nht-cyb/yumi-automatic-soldering-thd/README.md

# Automatic Soldering for Through-Hole Components with ABB YuMi

Automated soldering of through-hole (THD) components on PCBs with the **ABB YuMi (IRB 14000)** collaborative robot, a 3D-printed soldering-iron mount and a custom solder-wire feeder and cleaner.
The software pipeline goes from *"click the pins you want soldered"* to a ready-to-run **RAPID** program. Selected joints are mapped to robot coordinates using a calibrated point dataset, then ordered by **Ant Colony Optimization (ACO)** to minimise travel between joints.

> Bachelor thesis, VNU University of Engineering and Technology, MEMS and Microsystems Department (2024).
> Author: **Nguyen Huyen Trang**. Supervisors: Assoc. Prof. Bui Thanh Tung, MSc. Tran Nhu Chi.

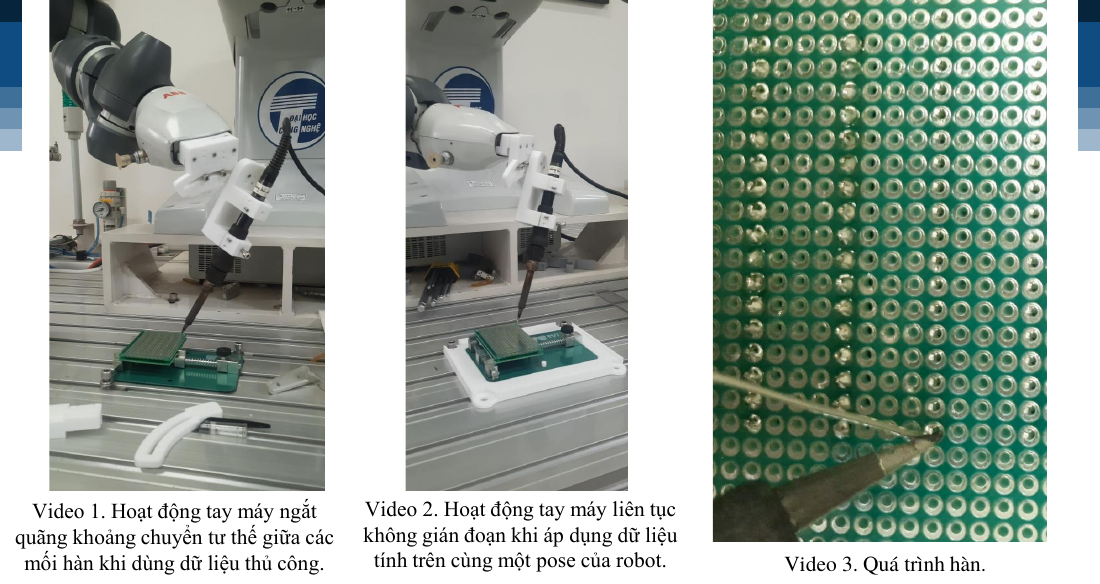
[picture p1: docs/images/robot_demo.png]
YuMi soldering a PCB


## Highlights

| | Result |
| --- | --- |
| Solder defects | **55 % empty joints → 6.7 % overall defect rate** (first trial vs. final parameters) |
| Wrong-position rate | **58.5 % → 10.2 %** of points (manual teaching vs. selective approximation) |
| Hole-pitch error | **1.305 mm → 0.022 mm** (manual teaching vs. selective approximation) |
| Re-setup time for a new board | **Hours → ≈ 4 min** (dataset + calibration instead of re-teaching every point) |
| Path optimization (Berlin52 benchmark) | Unordered tour **16,751 → 7,542** with ACO, the known optimum |
| RAPID programming | **Fully generated**, with no manual editing of point names or calls |
| Robot movement test | https://drive.google.com/drive/folders/1v9BW3aC0AH3kP2q5UkwLiJdkOLWXDny6?usp=sharing |
| Soldering Procedures | https://drive.google.com/drive/folders/1s6_kat9STPvH8OwUOIggMFEBmVdbERJi?usp=sharing |
## Contents

0. [Overview](#0-overview)
1. [Hardware](#1-hardware)
2. [Software setup](#2-software-setup)
3. [Working procedure (how to run)](#3-working-procedure)
4. [Experiments and results](#4-experiments-and-results)
5. [Limitations and future work](#5-limitations-and-future-work)

---

## 0. Overview

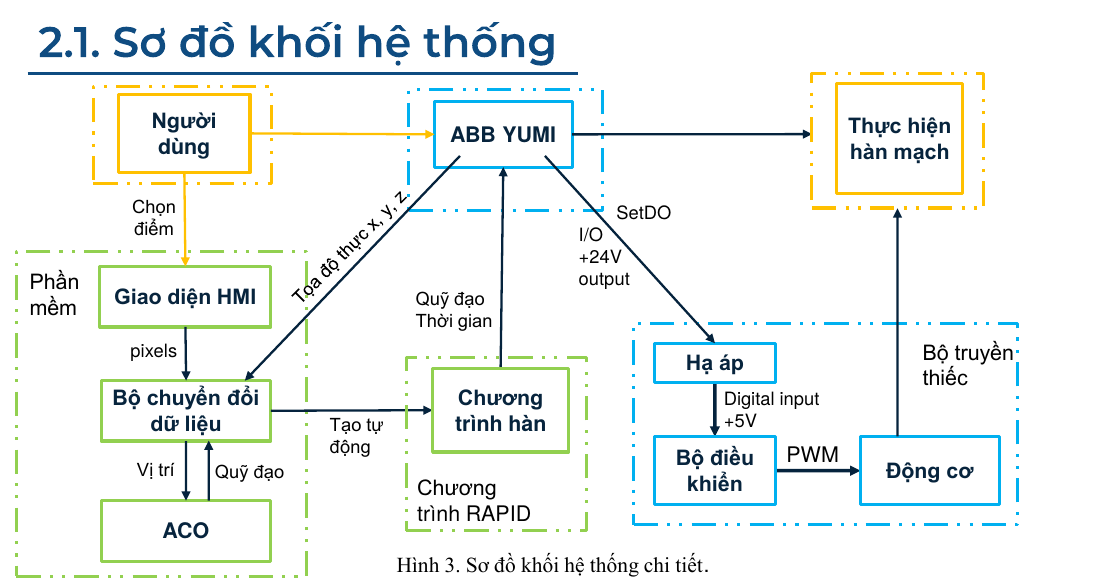
[picture p2: docs/images/system_diagram.png]
System block diagram


The system has three groups of blocks:

- **Software (green):** the web input page, the data processor, the ACO path optimizer and the RAPID program generator
- **Actuation (blue):** the YuMi right arm and the solder feeder
- **Operator (orange):** selects joints, jogs the robot with the FlexPendant and starts the program

**Data flow.** Joints selected on the web page come out as pixels. The processor converts them to `(row, col)` holes, and ACO orders them. The generator merges point data, the solder `PROC` and the `main()` calls into one RAPID module. During the run, YuMi raises a 24 V digital output at each joint. A logic step-down converts it to 5 V, and the feeder controller drives the motor to push solder wire.

### Repository structure

```
.
├── web_pcb_selector/            # HTML/JS page for picking joints, plus the scripts that turn clicks into RAPID
│   ├── index.html               # board-size menu
│   ├── 5x7.html, 6x8.html       # interactive perfboard pages
│   ├── script.js, styles.css
│   ├── img/                     # perfboard images (3×7 … 8×12 cm)
│   ├── pixel_point_conv.py      # clicked pixel coords → (row, col)
│   ├── generate_cmd.py          # (row, col) list → one PROC call per joint
│   ├── generate_rapid.py        # point data + calls → RAPID module
│   ├── clickdata/               # saved clicks from the page
│   ├── converted_output/        # clicks converted to (row, col)
│   ├── command/                 # generated call list
│   ├── program/inputgp/         # robtarget grid and calibration module used as generator input
│   └── Web/                     # screen recordings of the selector
├── data_processing/
│   ├── data_extraction/         # Python scripts for the point dataset
│   │   ├── extract_to_txt.py            # robtargets → x, y, z text
│   │   ├── extract_data_to_excel.py     # robtargets → x, y, z spreadsheet
│   │   ├── save_multiple_data.py        # all input files → one workbook, one sheet each
│   │   ├── generate_points.py           # taught outer-edge points → full 18×24 hole grid
│   │   ├── visualize.py                 # plot the extracted points
│   │   ├── input/                       # taught robtarget files
│   │   ├── output/                      # extracted spreadsheets
│   │   ├── generated point/             # generated inner grid points
│   │   └── visualize data/              # extracted coordinates and plots
│   ├── calibrate/0511/          # RAPID calibration modules (shift / set XYZ, work object)
│   ├── cal_points_v1/           # first C++ grid-point calculator
│   ├── Input real data/         # recordings of the taught-point plots
│   └── *.mp4, *.xlsx            # calibration videos and extracted coordinates
├── aco/
│   ├── ACO_Matlab/              # ACO / TSP solver (MATLAB): ant_colony.m, myaco.m, helpers
│   │   ├── data/, *.csv, *.xlsx, berlin52.*   # test point sets
│   │   └── results/             # result figures (.fig, .png)
│   └── Traveling Salesman/
│       ├── Code Matlab/         # Berlin52 version of the MATLAB solver
│       └── Code Python/         # Python version (main.py, aco.py, ant_colony.py, graphs.py, util.py)
├── ACO-results/                 # recordings and plots of ACO runs
├── rapid/
│   ├── MainModule.mod           # main right-arm module
│   ├── one_row_*.mod, move_p_row.mod   # single-row test programs
│   ├── SimpleMove.mod, SimpleMove.sys  # first motion test
│   ├── calibrateXYZ_for_shifted_station.txt   # calibration module for a shifted board
│   └── *.txt, *.xlsx            # taught robtarget data and backups
├── firmware/
│   ├── cad/                     # SolidWorks parts, STL and STEP files
│   │   ├── GripperVer1/, GripperVer2/   # soldering-iron mount, first and second build
│   │   ├── Board Setup/                 # PCB fixture
│   │   ├── Print2/                      # parts exported for 3D printing
│   │   ├── SLW_Hakko/                   # soldering-iron model
│   │   └── chot/                        # pin and transmission-head base
│   ├── cleaner_bldc/            # ESP32 + Nidec 24H BLDC tip cleaner
│   │   └── BLDC_Cleaner/        # sketch
│   ├── feeder_v1_esp32/         # ESP32 + Nidec 24H BLDC
│   │   ├── nidec/               # sketch
│   │   ├── SolderFeeder1/       # CAD
│   │   ├── schematic2/          # Fritzing schematic
│   │   └── SolderFeederSchematicV2/
│   └── feeder_v2_mega/          # Arduino Mega 2560 + TB6600 + NEMA14 (final)
│       ├── Solder_Feeder.ino    # sketch
│       ├── schematic3/          # Fritzing schematic and exports
│       ├── DM860A Stepper Motor Driver/   # Fritzing part
│       └── img/                 # gear-train renders
├── results_img/                 # photos of soldered boards per test case, result charts
├── reports/                     # thesis, slides and short report
├── yumi_readme/                 # RobotStudio getting-started notes
├── scripts/make_gifs.sh         # builds the README GIFs
└── docs/                        # images and GIFs used in this README
```

---

## 1. Hardware

### 1.1 Work-cell setup

A fixture plate holds the PCB in a repeatable position in front of the YuMi right arm. Test boards are double-sided perfboards (2.54 mm pitch) with jumper pins in consecutive rows. Pins should protrude **2 mm or less** and be held in place by bending the leads or taping them.

### 1.2 Soldering-iron mount

The mount bolts to the camera face of the YuMi wrist. A curved slotted bracket lets you set the iron angle. The final setup uses the **iron at 60° from vertical**, with the solder nozzle horizontal on the opposite side of the pin. All parts are 3D-printed. Leave clearance for M2 screw holes, because 0.4 mm nozzles shrink holes by about 0.2–0.5 mm.

| CAD | First and second builds |
| --- | --- |
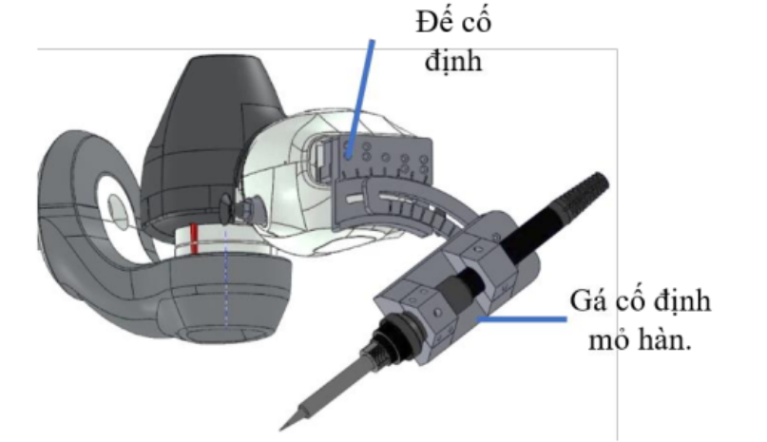
[picture p3: docs/images/mount_cad.png]
CAD model of the soldering-iron mount
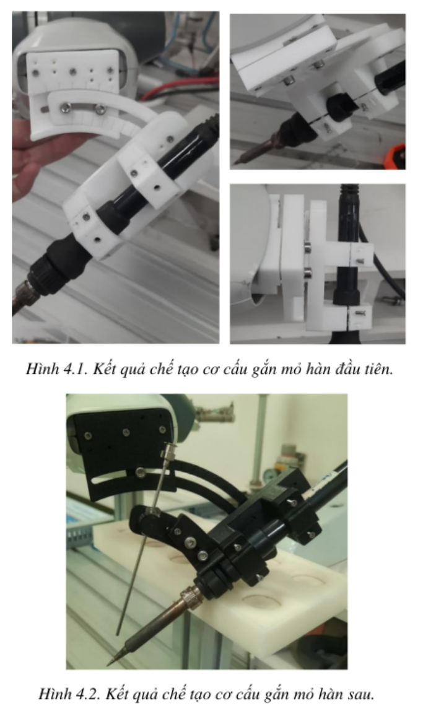
[picture p4: docs/images/mount_photos.png]
Photos of the first and second mount builds
|  |  |

### 1.3 Solder feeder v1 (ESP32 + BLDC)

The wire is pinched between a motor-driven gear and a ball bearing, guided by four brass posts. It only fits **0.8 mm** wire.

| Model | Build | Controller |
| --- | --- | --- |
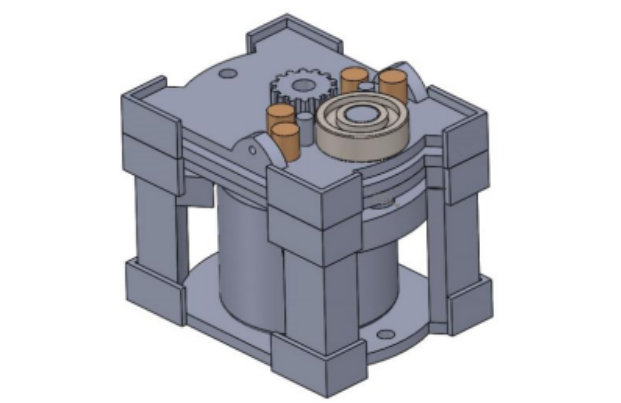
[picture p5: docs/images/feeder_v1_cad.png]
CAD model of feeder v1
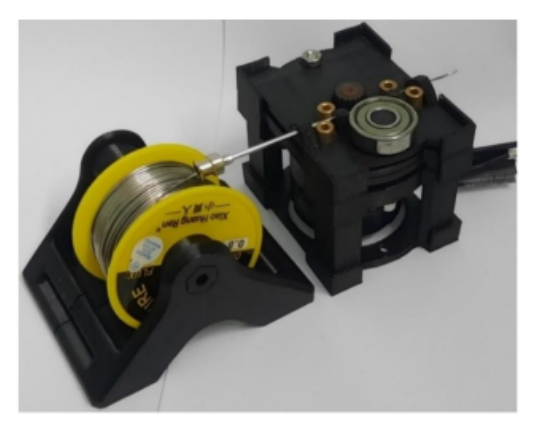
[picture p6: docs/images/feeder_v1_photo.png]
Built feeder v1
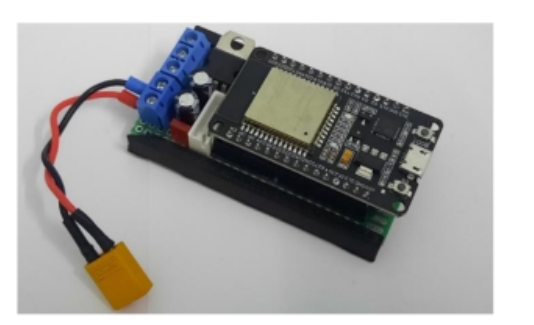
[picture p7: docs/images/feeder_v1_board.png]
ESP32 controller board for feeder v1
|  |  |  |

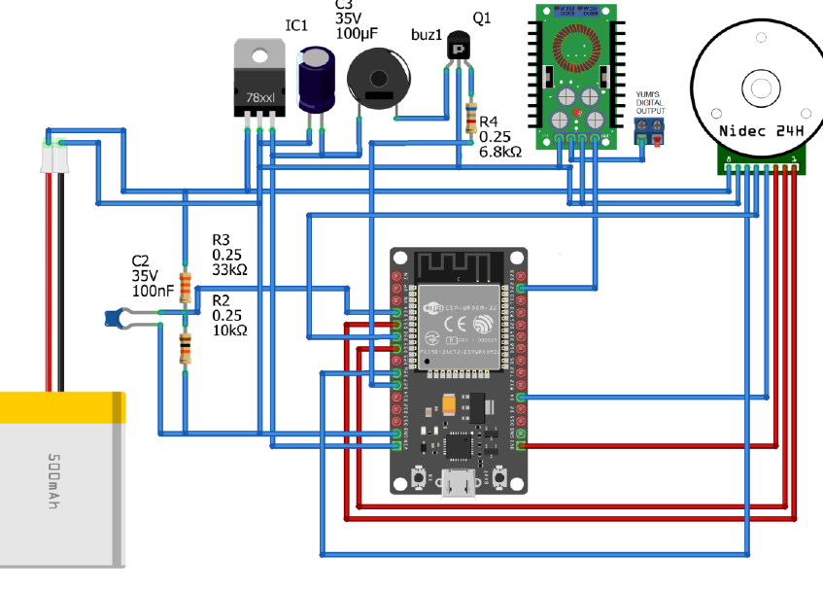
[picture p8: docs/images/feeder_v1_schematic.png]
v1 schematic


- **Controller:** ESP32 driving a **Nidec 24H055M020** BLDC motor with built-in driver and encoder (PWM speed control)
- **Power:** 12 V for the motor; a 7805 regulator supplies 5 V to the ESP32
- **Input:** YuMi digital output (0/24 V) through a voltage divider and step-down converter
- **Problems found:** wire slipping and sudden jerks at start-up. These caused most of the "insufficient solder" defects in early tests.
- **Code:** `firmware/feeder_v1_esp32/`

### 1.4 Solder feeder v2 (Arduino Mega + stepper), final version

This version is based on a 3D-printer filament extruder. A **9:5:1 spur-gear train** drives a grooved pulley, and a spring-loaded screw sets the clamping force. It handles wire from **0.3 to 1.2 mm**. The groove keeps bent wire from slipping and reduces solder spatter.

| Gear train | Build |
| --- | --- |
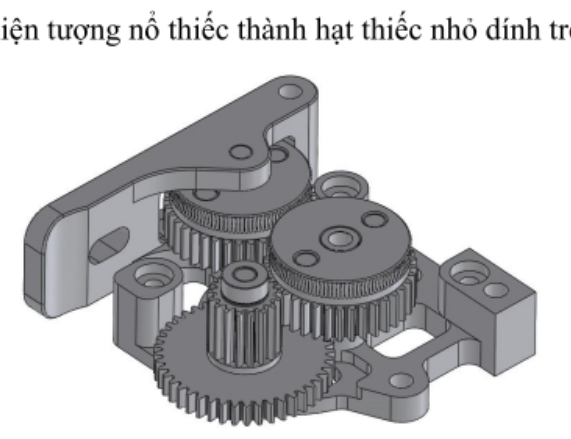
[picture p9: docs/images/feeder_v2_gears.png]
Feeder v2 spur-gear train
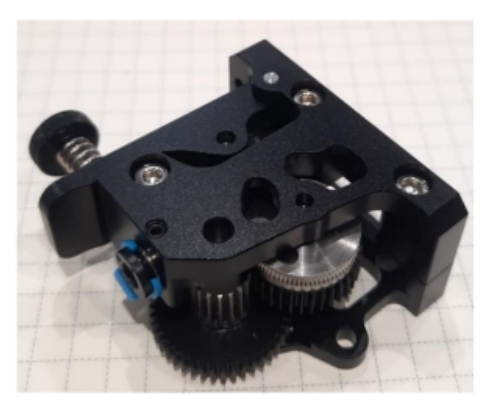
[picture p10: docs/images/feeder_v2_photo.png]
Built feeder v2
|  |  |

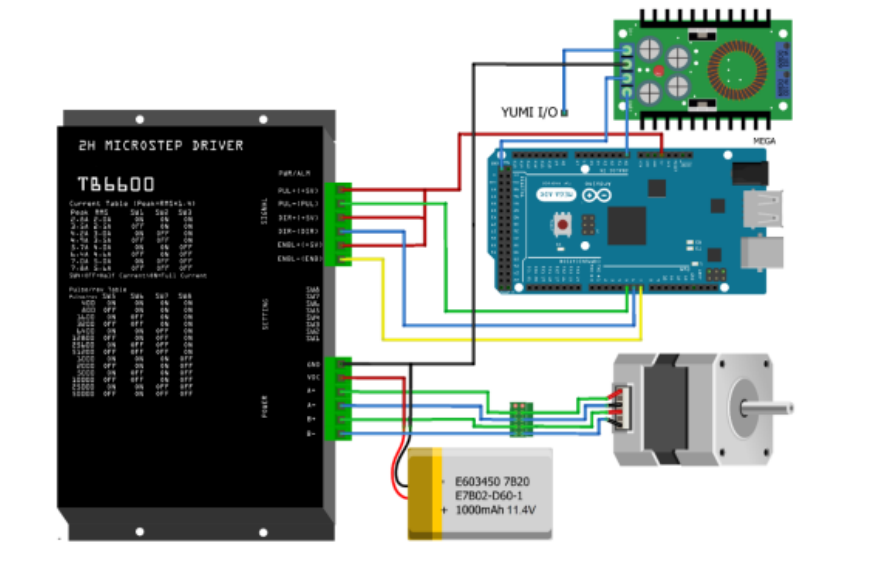
[picture p11: docs/images/feeder_v2_schematic.png]
v2 schematic


- **Controller:** Arduino Mega 2560 with a **TB6600** micro-step driver and a **NEMA14 36STH20-1004AHG** stepper, which gives slow and precise feed rates
- **Power:** 12 V to the driver and 5 V to the Mega
- **Input:** YuMi I/O through a 24 V → 5 V step-down
- **Code:** `firmware/feeder_v2_mega/`

---

## 2. Software setup

**Requirements**
- ABB RobotStudio (RobotWare with RAPID) connected to the YuMi controller
- Python 3.8+ with `numpy`, `matplotlib`, `pandas`, `xlsxwriter` and `plotly`
- MATLAB R2020+ (recommended for ACO, which ran much faster than the Python version)
- Arduino IDE (ESP32 core for v1)

```bash
git clone https://github.com/nht-cyb/yumi-automatic-soldering-thd.git
cd yumi-automatic-soldering-thd
pip install numpy matplotlib pandas xlsxwriter plotly
```

The scripts are research code: each one reads its input and output paths from variables in the file, relative to its own folder. Run them from that folder and edit the variables to point at your files.

### 2.1 Start pose

Jog the right arm with the FlexPendant joystick to a home pose. The wrist camera must face straight down at the board, perpendicular to the table. Adjust joints 4–6 to get there. With this pose fixed, pure linear jogging moves the iron tip along board rows and columns without changing the tool angle.

| J1 | J2 | J3 | J4 | J5 | J6 | J7 |
| --- | --- | --- | --- | --- | --- | --- |
| 54.64° | -98.48° | 25.01° | 20.64° | 41.72° | 94.18° | -96.10° |

### 2.2 Build the base point dataset (once per fixture)

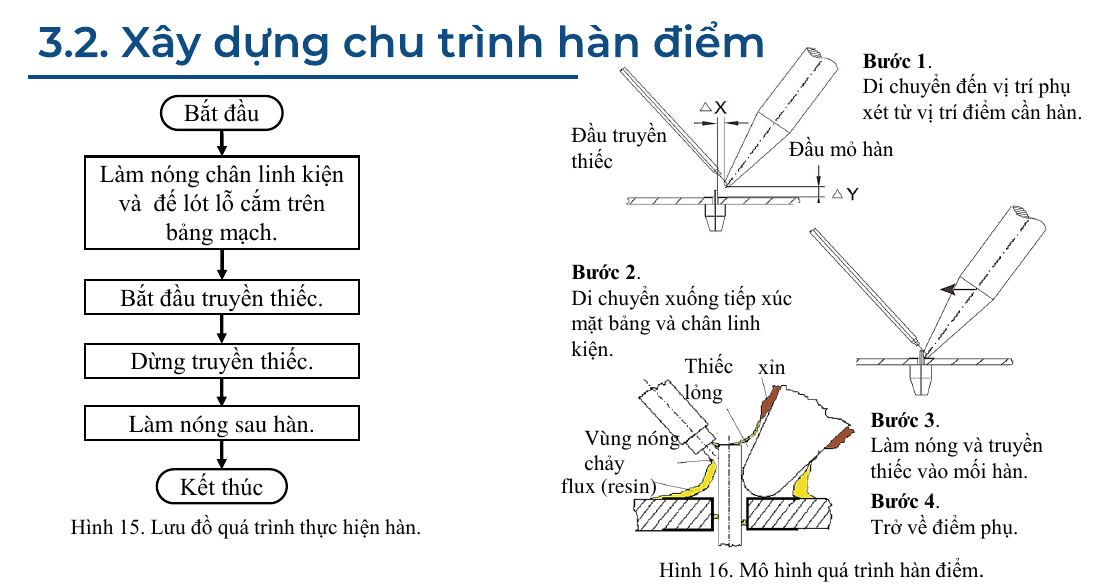
[picture p12: docs/images/dataset_flow.png]
Dataset generation flow


1. From the home pose, jog to the board corners and several reference holes along each row. Save each one as a `robtarget`. Move in straight lines only and touch the surface lightly.
2. Run the RAPID module that writes the saved points to a file.
3. Generate the full grid:

```bash
cd data_processing/data_extraction
python extract_to_txt.py     # input/2310_outer_grid.txt → visualize data/2310_outer_grid.txt
python generate_points.py    # → generated point/432_grid_points.txt
python visualize.py          # optional 3D plot of the points
```

Put the file of saved robtargets in `input/` and set `filename` at the top of `extract_to_txt.py`. That script extracts x, y, z from each `robtarget`. `generate_points.py` then interpolates between the taught edge points to fill in the full 18 × 24 grid (432 holes) and writes one `X, Y, Z` line per hole. `extract_data_to_excel.py` and `save_multiple_data.py` export the same coordinates to spreadsheets in `output/`.

The method described in the thesis (see `reports/`) also estimates the real hole pitch, which is not exactly 2.54 mm because of measurement angle, tilt and jog resolution, and replaces outliers with the averaged estimate.

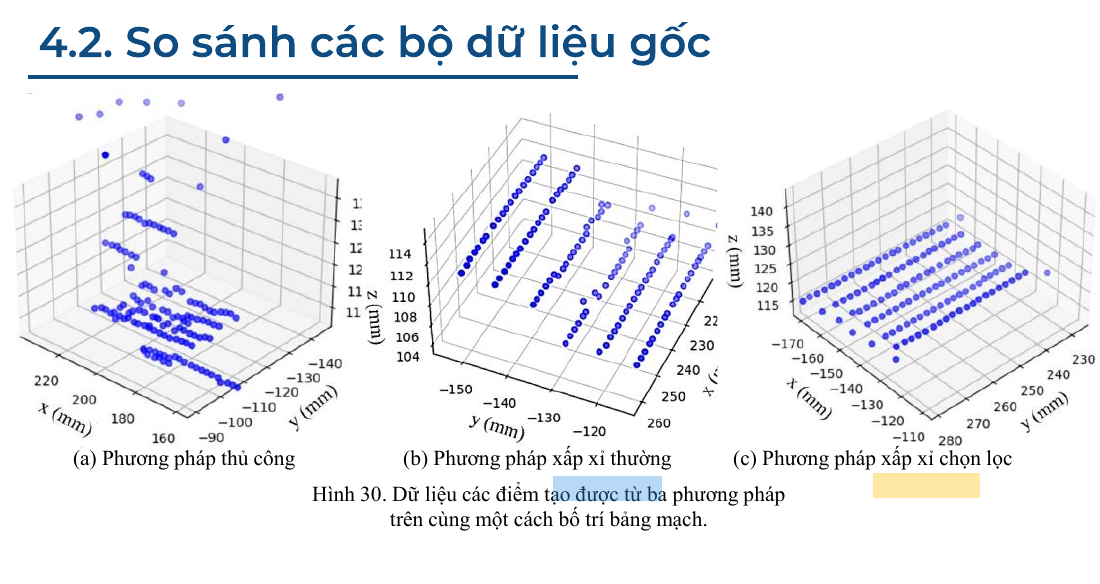
[picture p13: docs/images/dataset_methods.png]
Dataset methods compared


| Method | Δx | Δy | Δz | ε(x) | Wrong-position rate y / z / mean |
| --- | --- | --- | --- | --- | --- |
| Manual teaching | 1.2346 | 0.2713 | -0.0212 | 1.3054 | 0.409 / 0.761 / **0.585** |
| Plain approximation | 1.9523 | -0.0689 | -0.1047 | 0.5878 | 0.227 / 0.280 / **0.254** |
| Selective approximation | 2.5180 | -0.0046 | 0.0065 | **0.0215** | 0.129 / 0.076 / **0.102** |

Δ is the mean distance between consecutive points in a row (mm), and ε(x) is the mean pitch error. With the generated dataset, the arm moves smoothly between joints, without pose changes, pauses or pin collisions.

| Hand-taught points (left) vs. generated dataset (right), 1.5× speed |
| --- |
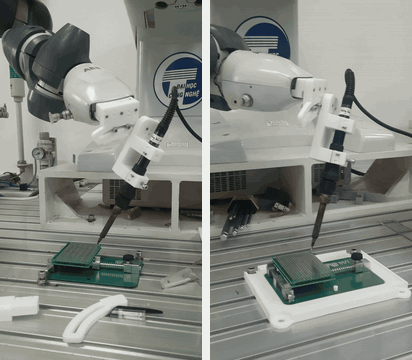
[picture p14: docs/gifs/motion_comparison.gif]
Left: the arm pauses to change pose between hand-taught points. Right: the arm moves continuously using the generated dataset
|  |

### 2.3 Calibration (each time the board is replaced)

The task needs about **0.2 mm** accuracy, and a replaced board never sits exactly where the last one did.

- **XY shift:** touch the new board origin. `shiftXY` is the mean offset from the stored origin, and it is added to every point.
- **Z height:** similar to bed levelling on a 3D printer. Touch the tip to the surface at several points until it just makes contact without pressing. Store the mean as the constant `calibratedZ`. YuMi only reports a collision after the board tilts about 2 mm, so the height must be set carefully when the iron is hot.

```
newPointXY = oldPointXY + shiftXY + offset    ! offset = hole spacing
newPointZ  = calibratedZ + PinLength
```

Re-setup takes **about 4 minutes**. Re-teaching every point by hand used to take hours.

---

## 3. Working procedure

### 3.1 Select the joints to solder

Open `web_pcb_selector/index.html` and choose a board size. The menu lists 3×7, 4×6, 5×7, 6×8, 7×9 and 8×12 cm, but only the 5×7 and 6×8 pages are included in this repository. Click a hole to select it, or drag to select a whole row. You can undo, clear all or save. **Save Positions** downloads `clicked_positions.txt`; move it into `web_pcb_selector/clickdata/`.

| Board size menu | Selecting joints |
| --- | --- |
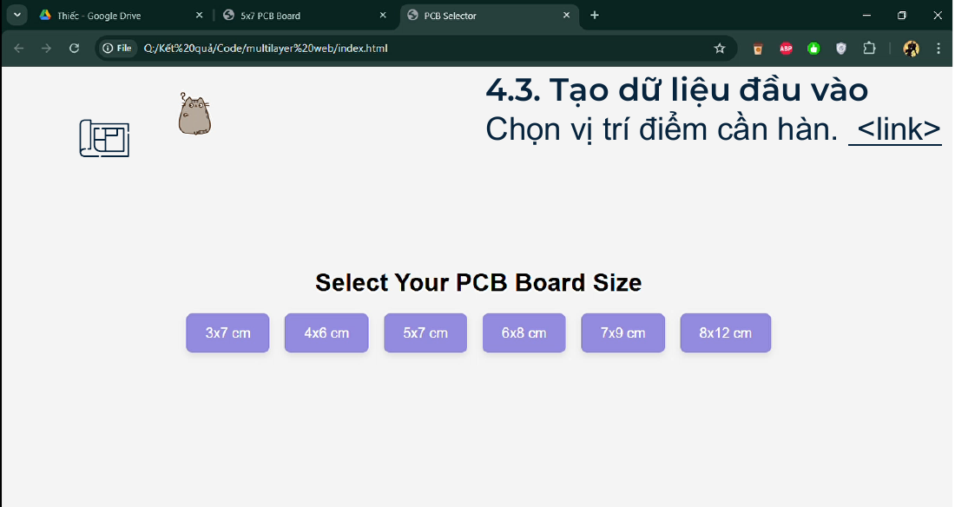
[picture p15: docs/images/pcb_selector.png]
Board size menu of the web selector
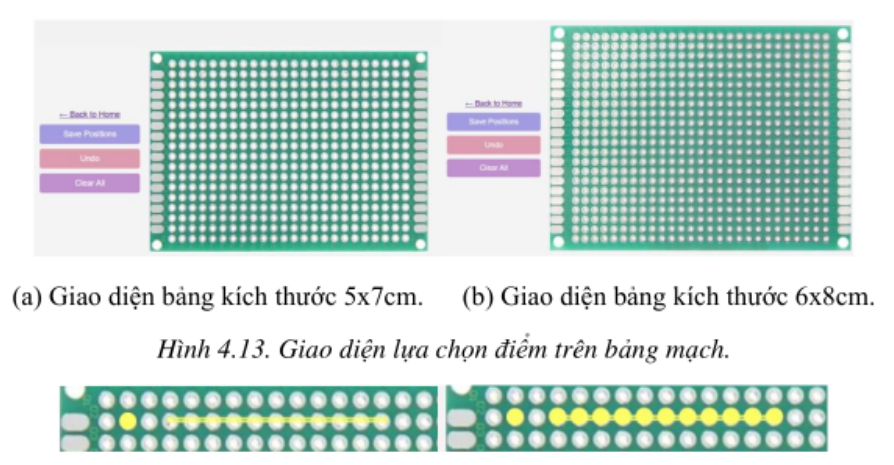
[picture p16: docs/images/pcb_boards.png]
Joints selected on a board
|  |  |

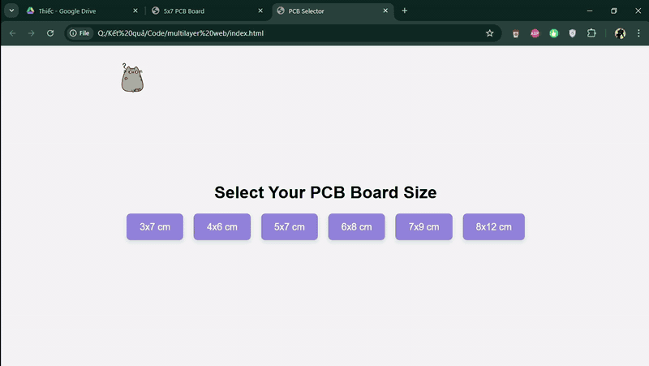
[picture p17: docs/gifs/web_selector.gif]
Choosing a 5×7 cm board and selecting rows of joints in the web selector (1.5× speed)


```bash
cd web_pcb_selector
python pixel_point_conv.py   # clickdata/clicked_positions.txt → converted_output/clicked_positions_converted.txt
```

The script snaps each pixel to the nearest hole, drops duplicates and sorts by row and column. The pixel position of hole (1, 1) and the hole spacing are set in `reference_x`, `reference_y` and `grid_spacing` near the end of the script; change them for a different board page. If the output file already exists, the script writes `clicked_positions_output_<n>.txt` instead of overwriting it.

| Input (pixels x, y) | Output (row, col) |
| --- | --- |
| 65 45 | 2 2 |
| 105 44 | 2 4 |
| 125 44 | 2 5 |
| 146 44 | 2 6 |
| … | … |
| 309 44 | 2 14 |

### 3.2 Optimize the path (ACO / TSP)

```matlab
% MATLAB (used for the reported results), from aco/ACO_Matlab/
ant_colony   % Berlin52 benchmark, reads berlin52.csv
myaco        % board points
```

```bash
# Python
cd "aco/Traveling Salesman/Code Python"
python main.py
```

All three have the author's own paths hard-coded, so edit them first:

- `ant_colony.m`: remove or change the `cd('Q:\Thesis\Code\ACO_Matlab')` line so that `berlin52.csv` is found.
- `myaco.m`: change the `cd(...)` line, supply an `input.csv` of joint coordinates and assign its columns to `x` and `y`. Set `n` to the number of joints.
- `main.py`: point `pd.read_csv(...)` at a tab-separated coordinate file with a header row. The tour is plotted with `plotly`.

Each ant builds a tour. Pheromones are updated after each iteration, and the shortest tour found is kept. The parameters were tuned on the **TSP Berlin52** benchmark, whose known optimal tour length is 7,542.

| Setting (MATLAB) | Iterations | Ants | α | β | δ | σ | Result |
| --- | --- | --- | --- | --- | --- | --- | --- |
| Initial | 300 | 60 | 1 | 4 | 0.15 | 0.97 | 8,210.2: stuck in a local optimum |
| **Tuned** | 300 | 60 | **15** | **20** | **0.13** | **0.86** | **7,549.0**, converges at about iteration 60 |

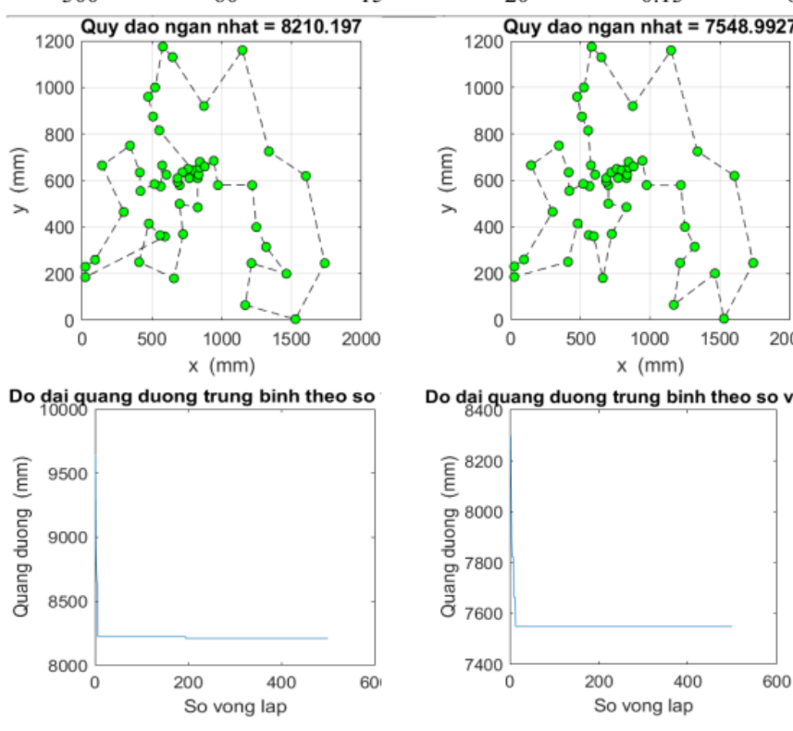
[picture p18: docs/images/aco_berlin52.png]
Berlin52 comparison


The Python version with local search (60 ants, 100 iterations, α = 15, β = 20, decay 0.1) reaches the optimum of 7,542:

| Unordered (16,751) | ACO (7,542) |
| --- | --- |
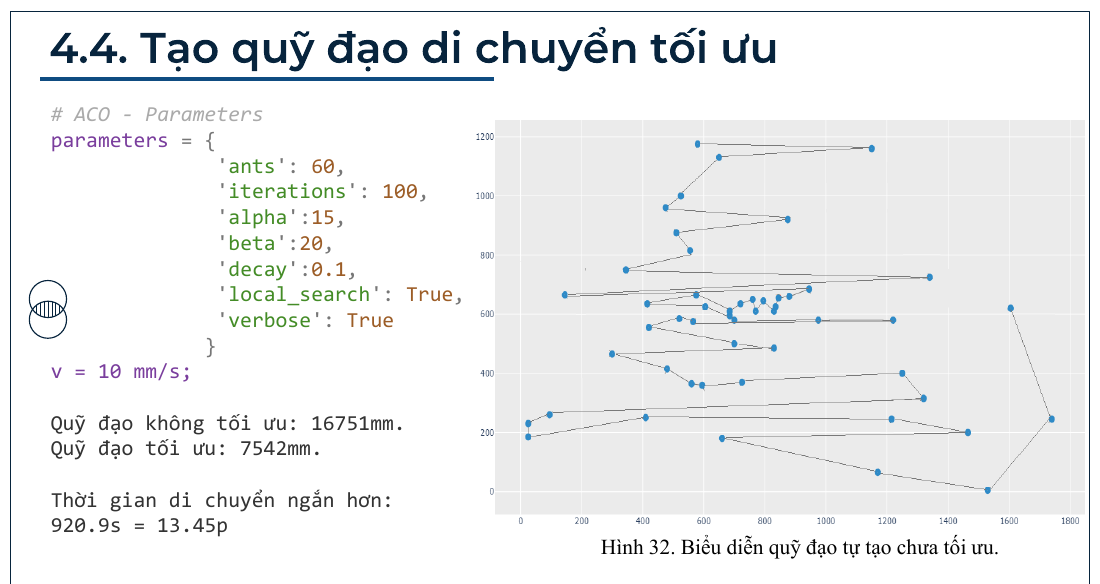
[picture p19: docs/images/path_before.png]
Unordered Berlin52 tour
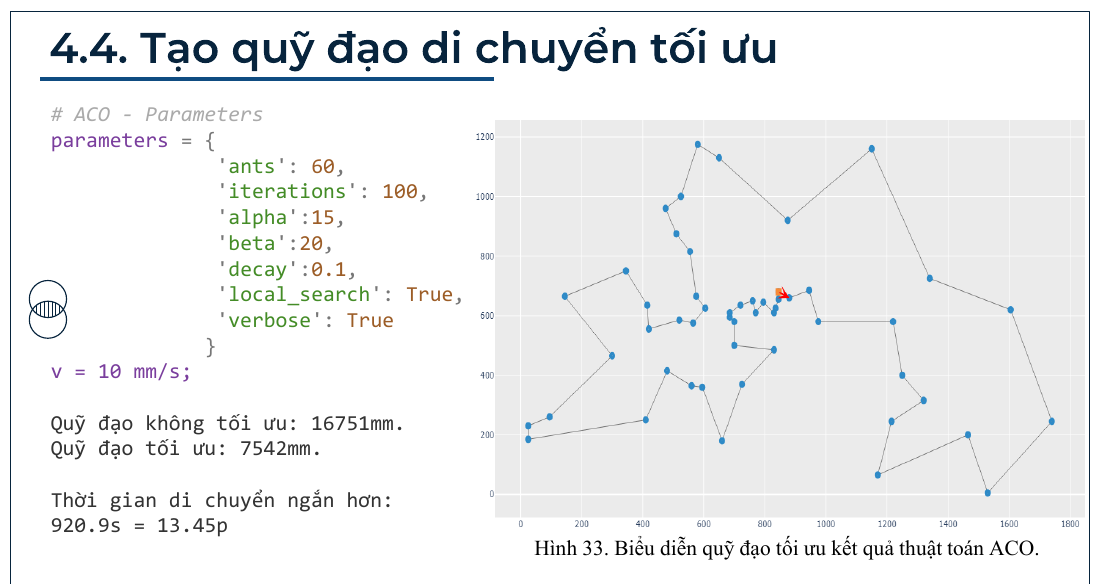
[picture p20: docs/images/path_aco.png]
ACO-optimized Berlin52 tour
|  |  |

**Working parameters for the board:** 20 iterations, 10 ants, α = 15, β = 20, δ = 0.13, σ = 0.86. On 10 random holes the shortest path was **74.14 mm**, found at iteration 4. When joints sit in evenly spaced rows, the order saved from the web page is already optimal, so ACO is only needed for scattered layouts.

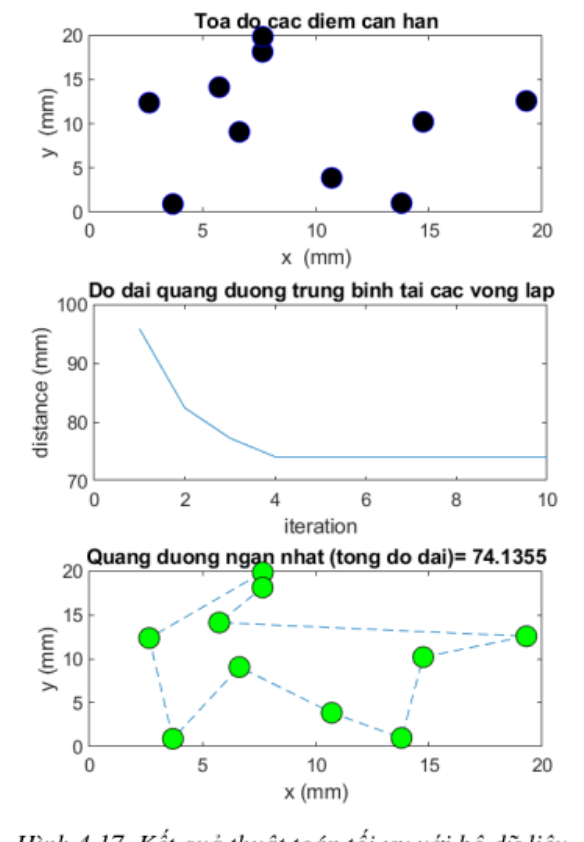
[picture p21: docs/images/aco_final.png]
ACO final


### 3.3 Generate the RAPID program

```bash
cd web_pcb_selector
python generate_cmd.py       # → command/commands.txt, one call per joint
python generate_rapid.py     # → program/clicked_positions_converted_module.txt
```

Both scripts read `converted_output/clicked_positions_converted.txt`; change `input_file` at the bottom of each to use another file. If the input is missing, `generate_rapid.py` exits without writing anything or printing an error.

`generate_rapid.py` starts from the template module (`program/inputgp/calibrateXYZ_for_shifted_station.txt`), which holds the calibration and per-joint routines. It adds any point declarations from `program/inputgp/2310_outer_grid.txt` that the template does not already have, and replaces the `MoveUpDown` calls in `main()` with one call per selected joint. The calls follow the line order of the converted file, so to use an ACO tour, reorder those lines first.

Each call is written as `MoveUpDown <point>;`. Rows map to letters and columns to numbers, so (1, 2) becomes `A2` and (18, 24) becomes `R24`. The included dataset only declares the holes on the board edge. For any other selected hole the script prints a warning; add its `robtarget` to the dataset file before loading the module.

### 3.4 Run on YuMi

1. In RobotStudio, paste or load the generated module into the **right-arm module** (`T_ROB_R`).
2. Flash the feeder firmware and connect the YuMi digital output through the 24 → 5 V step-down.
3. Set the iron to **350 °C**, then move to the home pose and run calibration (2.3).
4. Run `main()`. Keep the soldering speed at **`v20` or lower** to limit tip vibration.
5. Clean the tip every **15–20 joints**.

### 3.5 The soldering cycle at one joint

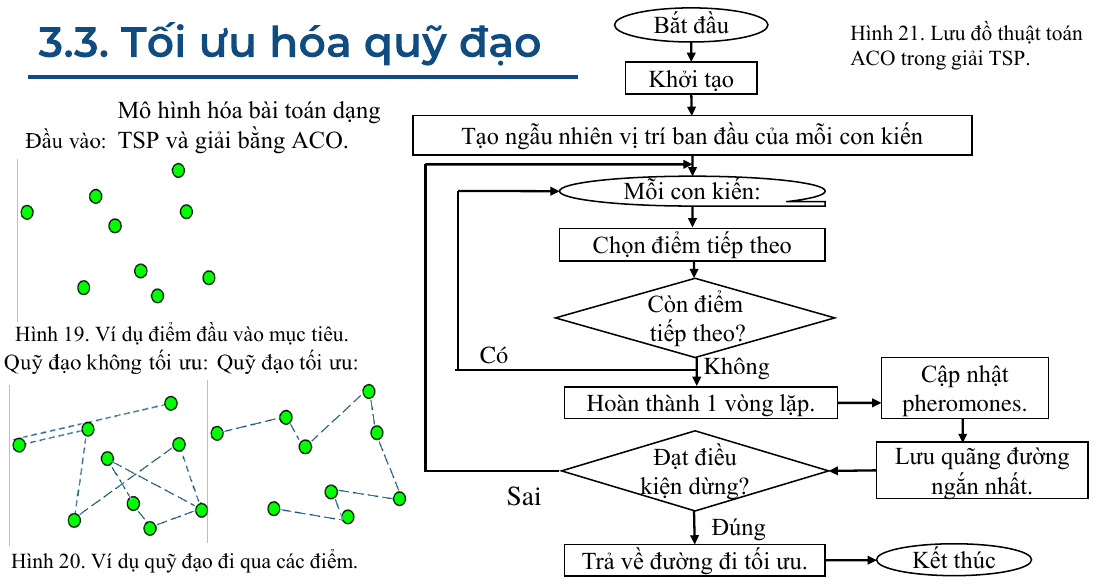
[picture p22: docs/images/solder_cycle.png]
Solder cycle timing


| Close-up along a row (3× speed) | Top-down view (2× speed) |
| --- | --- |
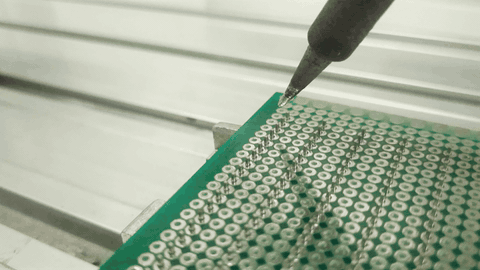
[picture p23: docs/gifs/soldering_closeup.gif]
Close-up of the iron soldering joints along a row
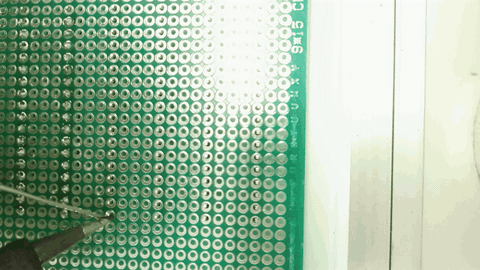
[picture p24: docs/gifs/soldering_topdown.gif]
Top-down view of YuMi soldering a row of joints
|  |  |

Simplified pseudo-code (not runnable RAPID; zones, tool data and semicolons are omitted, and `.xy` stands for setting `x` and `y`). The per-joint motion routine used by the generator is `MoveUpDown` in `web_pcb_selector/program/inputgp/calibrateXYZ_for_shifted_station.txt`.

```
PROC solder(robtarget currentPoint)
    temp.trans.xy         := currentPoint.trans.xy + shiftXY
    temp.trans.z          := calibratedZ + PinLength + clearance
    currentPoint.trans.xy := currentPoint.trans.xy + shiftXY
    currentPoint.trans.z  := calibratedZ + PinLength
    MoveL temp, v50                   ! approach point above the joint
    PulseDO \PLength:=0.3, feed       ! pre-feed: wet the tip
    MoveL currentPoint, v20           ! touch pad + pin
    WaitTime pre_heat                 ! pre-heat pad and pin
    PulseDO \PLength:=0.4, feed       ! feed solder
    WaitTime post_heat                ! let the solder flow
    MoveL temp, v20                   ! retract
ENDPROC
```

| Step | Time |
| --- | --- |
| Wait above joint, wet the tip (DO ON) | 0.1 – 0.4 s |
| Move down to the joint | 0.4 – 0.6 s |
| Pre-heat pad and pin | 1.2 s |
| Feed solder (DO ON) | 0.4 s |
| Post-heat, solder flows (DO OFF) | 0.8 s |
| Retract | 0.2 s |
| **Total per joint** | **≈ 3.2 s** |

---

## 4. Experiments and results

### 4.1 Test case 1: no dataset, no calibration

Setup: iron at 30°, feeder v1, points taught by hand, and solder fed the moment the tip touched the board.

| Trial | Temp. | Wait above | Feed | Wait after |
| --- | --- | --- | --- | --- |
| 1 | 285 °C | 0.5 s | 1.0 s | 0.2 s |
| 2 | 320 °C | 1.0 s | 1.5 s | 0.8 s |

**Result:** 22 of 40 joints (**55 %**) were empty. The board and tip were too cold for the solder to flow, and the tool pose drifted between points. Some joints also landed between pins because of position errors.

### 4.2 Test case 2: effect of temperature

Setup: dataset and calibration in use, pre-heat 1.5 s, feed 0.65 s, post-heat 1.0 s, 85 joints per temperature (5 rows × 17).

| Temp. | Excess | Insufficient | Skipped | Spike | Burnt | Defect rate |
| --- | --- | --- | --- | --- | --- | --- |
| 285 °C | 3 | 12 | 1 | 0 | 2 | 22.1 % |
| 300 °C | 2 | 8 | 1 | 0 | 0 | 10.7 % |
| 320 °C | 9 | 10 | 1 | 0 | 0 | 23.5 % |
| **350 °C** | 2 | 4 | 0 | 0 | 0 | **7.1 %** |
| 385 °C (run 1) | 1 | 8 | 1 | 3 | 3 | 18.6 % |
| 385 °C (run 2) | 4 | 16 | 3 | 1 | 4 | 31.4 % |

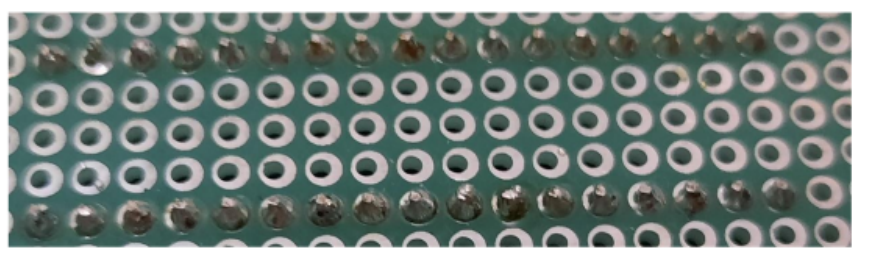
[picture p25: docs/images/joints_350C.png]
Joints at 350 °C


**Heat build-up.** The tip gets hotter during a long run. Joints soldered later in a row (shown at a 400 °C setting, left to right) become duller and burn more easily. Use **320–350 °C** and clean the tip every 15–20 joints.

Heat accumulation

### 4.3 Test case 3: feed time

Setup: 350 °C, pre-heat 1.5 s, feed speed 6 mm/s, post-heat 0.8 s, 72 joints. A short pre-feed was added to wet the tip, so solder reaches both sides of the pin.

| Pre-feed | Feed | Excess | Insufficient | Skipped | Spike | Short | Total defects |
| --- | --- | --- | --- | --- | --- | --- | --- |
| 0.7 s | 1.0 s | 27 | 0 | 0 | 0 | 1 | 29 |
| 0.5 s | 0.8 s | 13 | 7 | 1 | 0 | 0 | 21 |
| **0.3 s** | **0.4 s** | 0 | 18 | 0 | 1 | 0 | **19** |

A typical joint needs about 2 mm of wire, while a 0.7 s pre-feed pushes about 4.5 mm, which explains the excess solder.

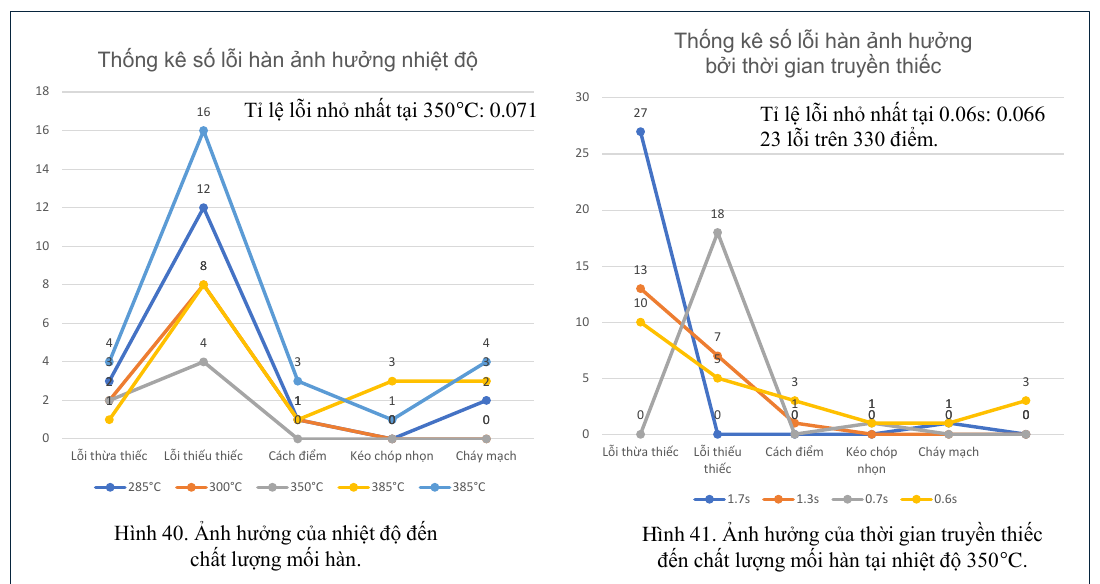
[picture p26: docs/images/defect_stats.png]
Defect statistics


### 4.4 Test case 4: final parameters

Final setup: feeder v2, 350 °C, pre-feed 0.5 s, pre-heat 1.5 s, feed 0.6 s at 4 mm/s, post-heat 0.8 s, and tip cleaning between rows. 330 joints were soldered (22 rows × 15) for each pin length.

| Pin length | Excess | Insufficient | Skipped | Spike | Short | Burnt | Total defects |
| --- | --- | --- | --- | --- | --- | --- | --- |
| 2 mm | 10 | 5 | 3 | 1 | 1 | 3 | 23 |
| 4 mm | 5 | 17 | 0 | 0 | 16 | 4 | 42 |

For short-pin components the overall defect rate is **6.69 %**. Excess solder dropped to **0.33 %**, down from about 30 % in earlier tests. Burnt joints were almost eliminated.

| Short-pin components | Long-pin (4 mm) components |
| --- | --- |
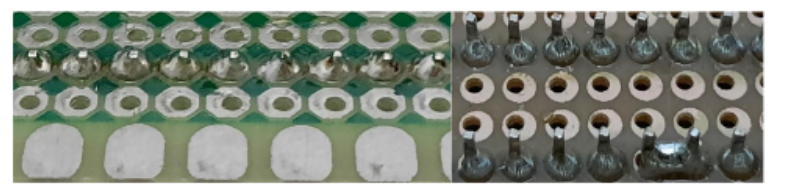
[picture p27: docs/images/final_joints.png]
Final solder joints on short-pin components
|  | Long pins limit the tip's contact angle with the pad and conduct heat toward neighbours, which causes bridging and one-sided joints. |

---

## 5. Limitations and future work

**Limitations**
- There is no temperature sensor. Heat is controlled only through the soldering station setting and timing.
- The quality scale does not yet fully follow industrial criteria such as IPC-A-610.
- Tests used perfboards only, not designed production PCBs.

**Future work**
- A friendlier user interface
- A dedicated CNC-style feeder built for high temperatures
- Active heating with closed-loop temperature sensing
- Camera-based joint localization, collision warnings and motion planning
- ML-based automated optical inspection (AOI) of joints from optical or X-ray images

---

## Citation

```
Nguyen Huyen Trang, "Research and development of through-hole component soldering
on printed circuit boards for the YuMi collaborative robot," B.Eng. thesis,
VNU University of Engineering and Technology, Hanoi, 2024.
```

## License

This project is licensed under the [MIT License](LICENSE).
