nht-cyb/yumi-automatic-soldering-thd/data_processing/data_extraction/visualize data/1110.png

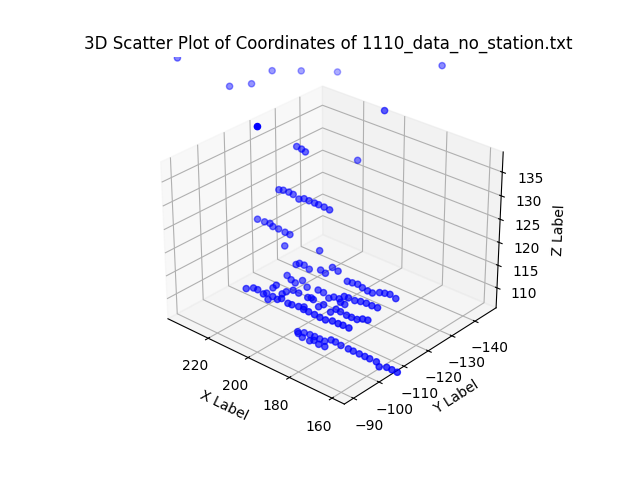
data_processing/data_extraction/visualize data/1110.png
