nht-cyb/yumi-automatic-soldering-thd/data_processing/data_extraction/visualize data/2210_BQ.png

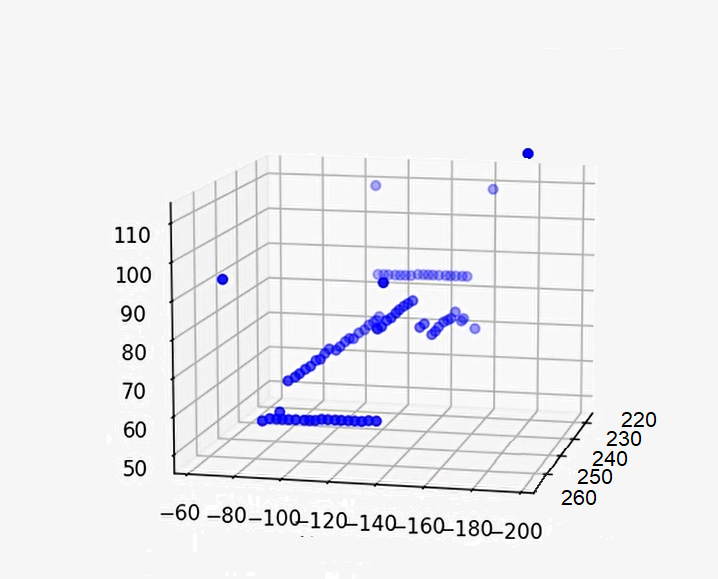
data_processing/data_extraction/visualize data/2210_BQ.png
