nht-cyb/yumi-automatic-soldering-thd/data_processing/data_extraction/visualize data/data.png

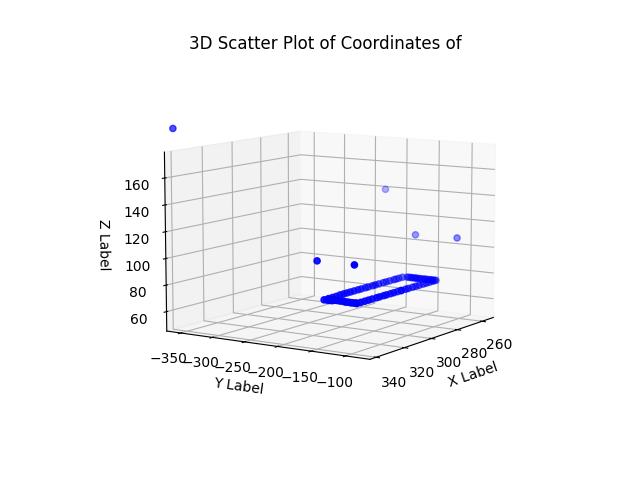
data_processing/data_extraction/visualize data/data.png
