nht-cyb/yumi-automatic-soldering-thd/data_processing/data_extraction/visualize data/Figure_1.png

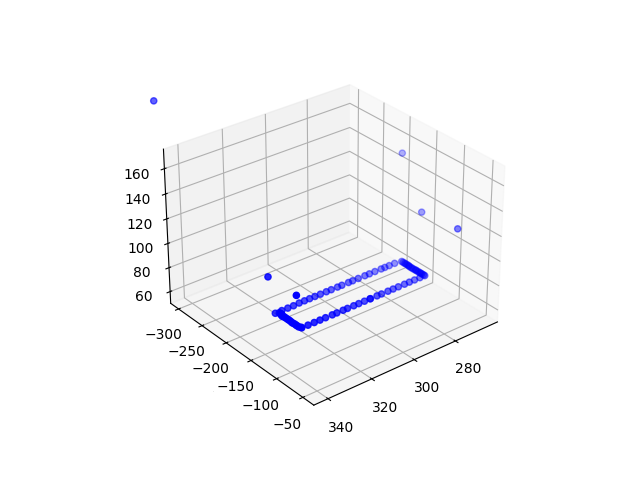
data_processing/data_extraction/visualize data/Figure_1.png
