nht-cyb/yumi-automatic-soldering-thd/data_processing/data_extraction/visualize data/Figure_1_.png

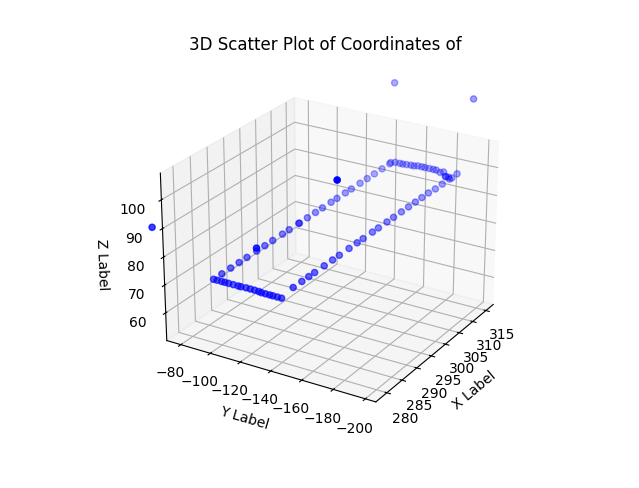
data_processing/data_extraction/visualize data/Figure_1_.png
