nht-cyb/yumi-automatic-soldering-thd/data_processing/data_extraction/visualize data/yellowpip.png

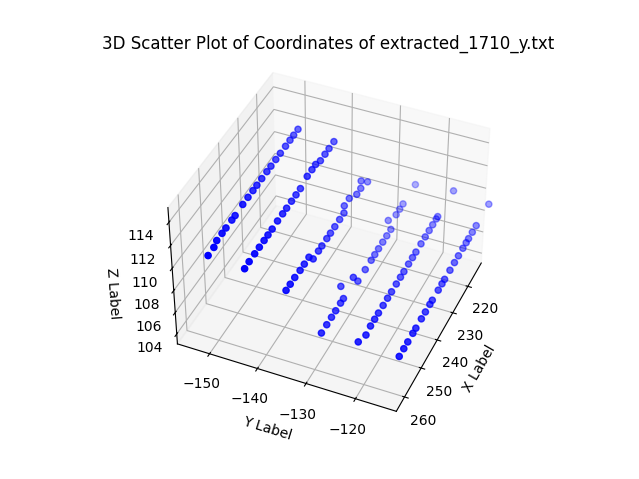
data_processing/data_extraction/visualize data/yellowpip.png
