nht-cyb/yumi-automatic-soldering-thd/firmware/cad/abb_irb14000_with_workspace-1.snapshot.2/ABB_IRB14000_with_WorkSpace.JPG

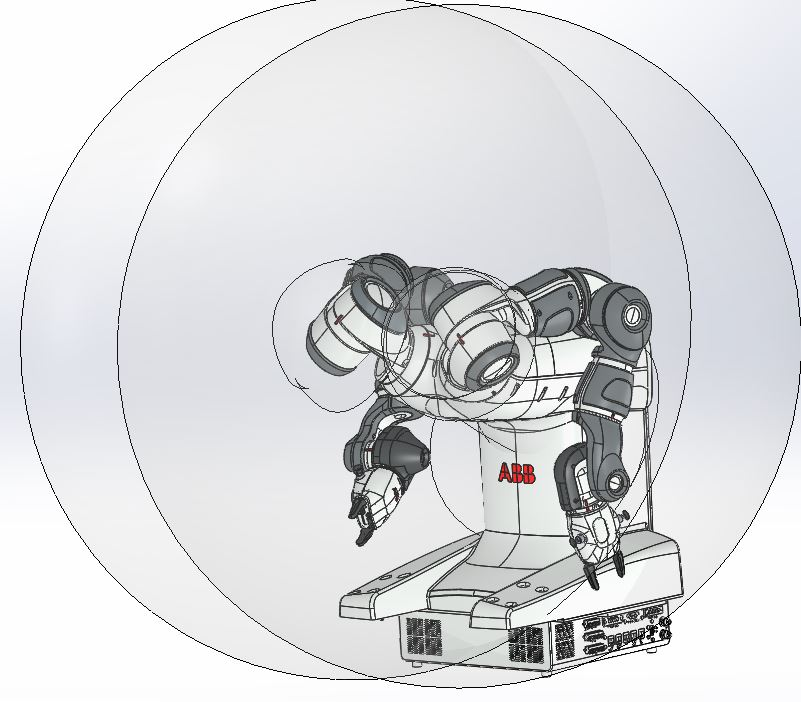
firmware/cad/abb_irb14000_with_workspace-1.snapshot.2/ABB_IRB14000_with_WorkSpace.JPG
