nht-cyb/yumi-automatic-soldering-thd/firmware/cad/Assem3.JPG

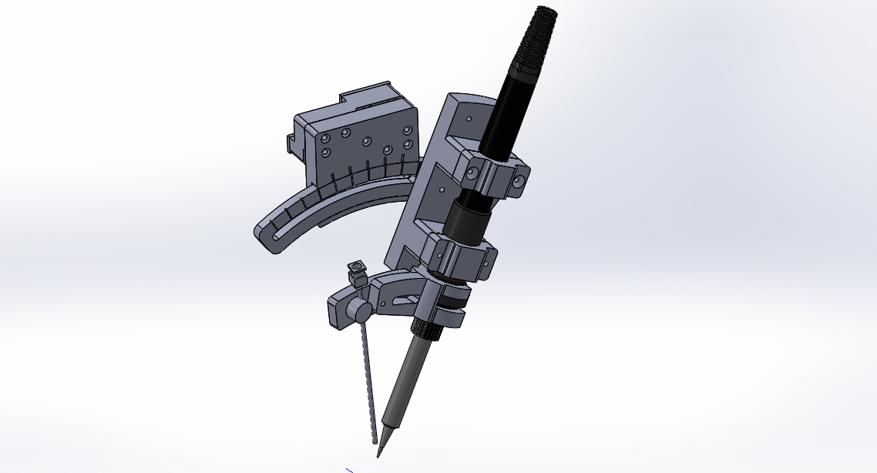
firmware/cad/Assem3.JPG
