nht-cyb/yumi-automatic-soldering-thd/firmware/cad/GripperVer2/Asse112.JPG

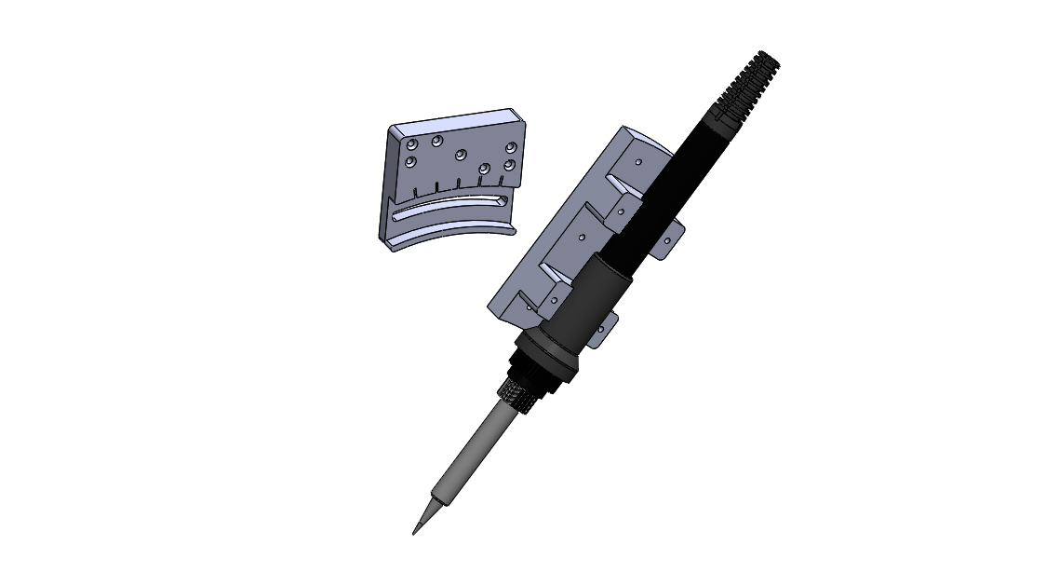
firmware/cad/GripperVer2/Asse112.JPG
