nht-cyb/yumi-automatic-soldering-thd/firmware/cad/GripperVer2/Assem2.JPG

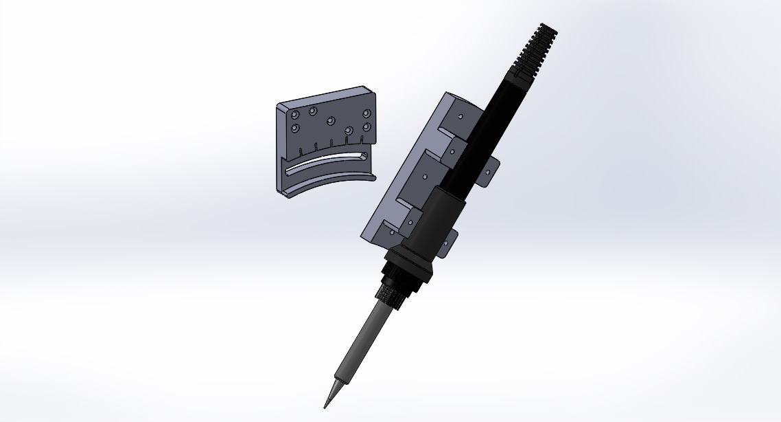
firmware/cad/GripperVer2/Assem2.JPG
