nht-cyb/yumi-automatic-soldering-thd/firmware/cad/GripperVer2/Assem3-1.JPG

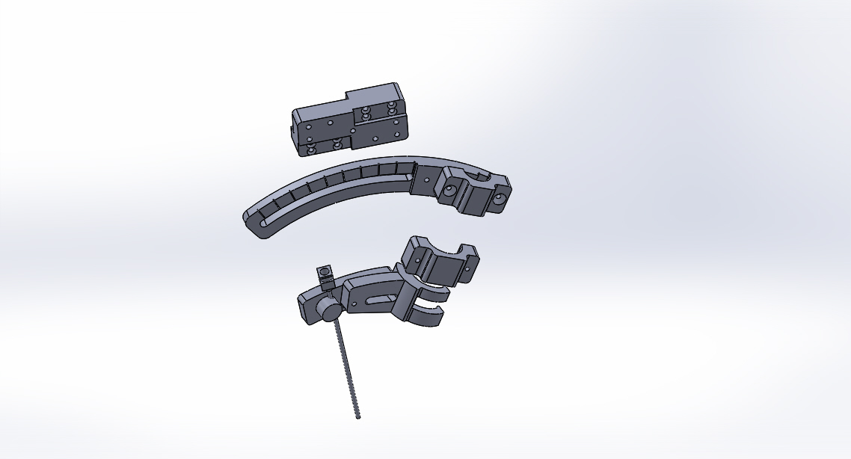
firmware/cad/GripperVer2/Assem3-1.JPG
