nht-cyb/yumi-automatic-soldering-thd/firmware/cad/GripperVer2/img/Assem3-4.JPG

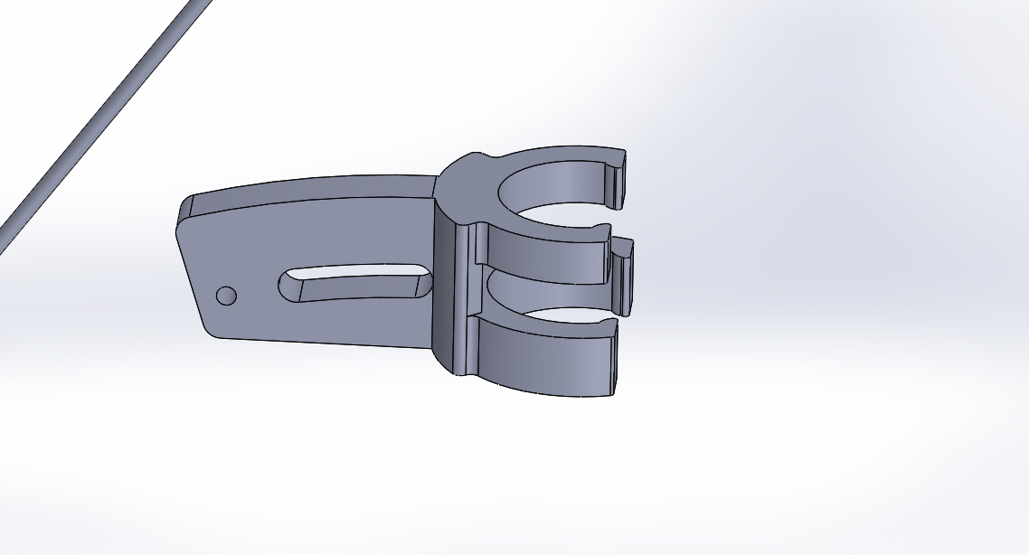
firmware/cad/GripperVer2/img/Assem3-4.JPG
