nht-cyb/yumi-automatic-soldering-thd/firmware/cad/GripperVer2/img/Assem3-angle.JPG

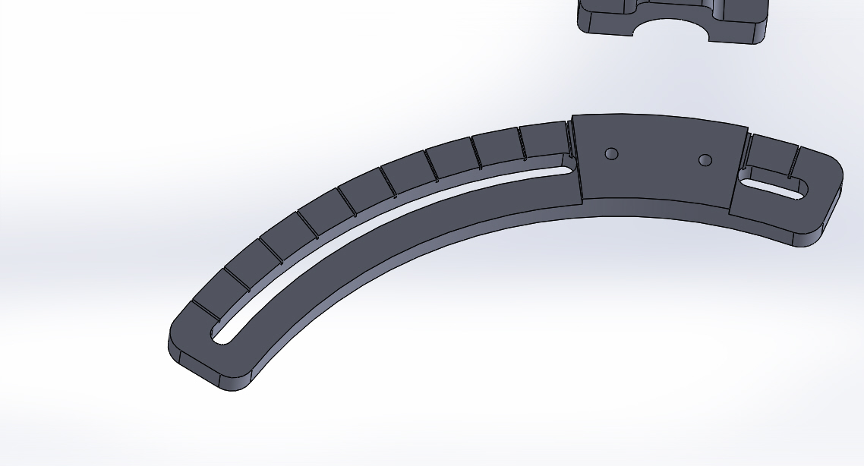
firmware/cad/GripperVer2/img/Assem3-angle.JPG
