nht-cyb/yumi-automatic-soldering-thd/firmware/cad/GripperVer2/img/Assem3.JPG

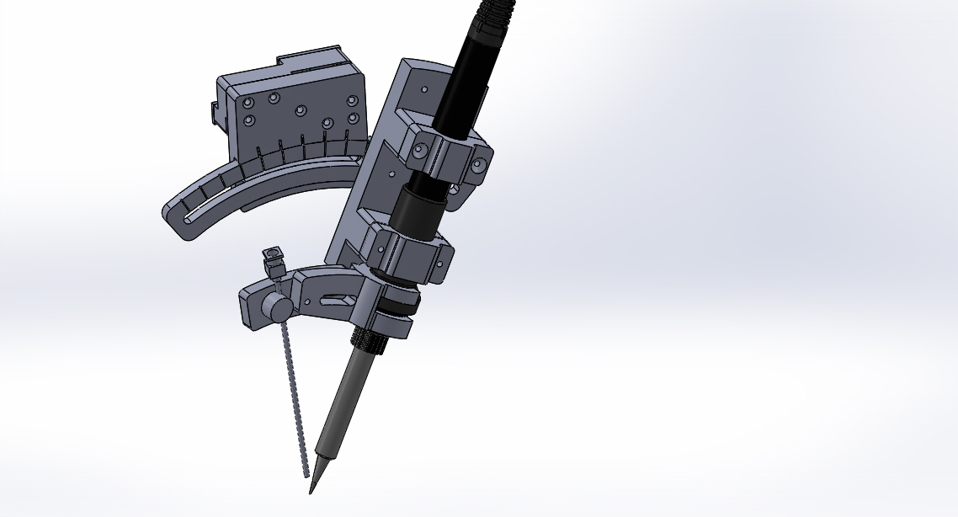
firmware/cad/GripperVer2/img/Assem3.JPG
