nht-cyb/yumi-automatic-soldering-thd/firmware/feeder_v1_esp32/Assem2-1.JPG

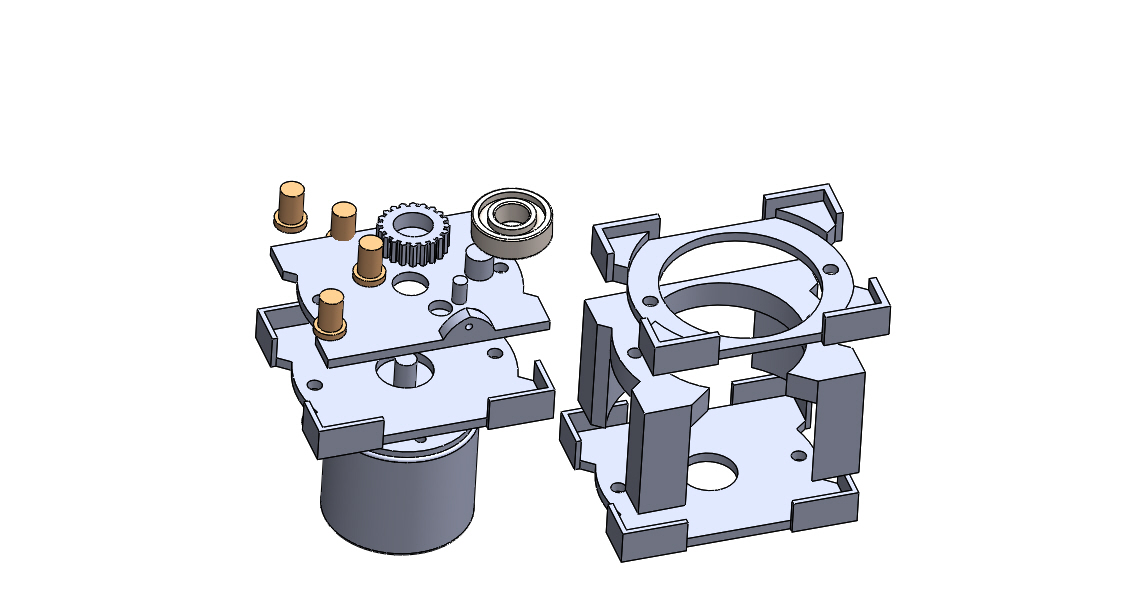
firmware/feeder_v1_esp32/Assem2-1.JPG
