nht-cyb/yumi-automatic-soldering-thd/firmware/feeder_v2_mega/20241212_080543.jpg

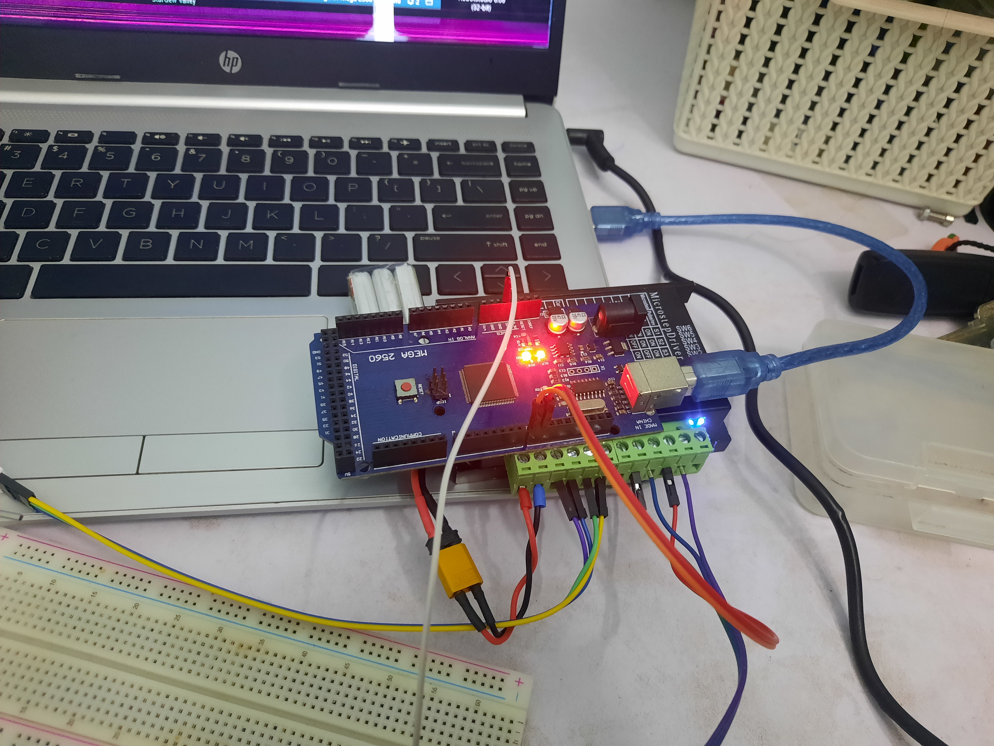
firmware/feeder_v2_mega/20241212_080543.jpg
