nht-cyb/yumi-automatic-soldering-thd/firmware/feeder_v2_mega/feederv2.png

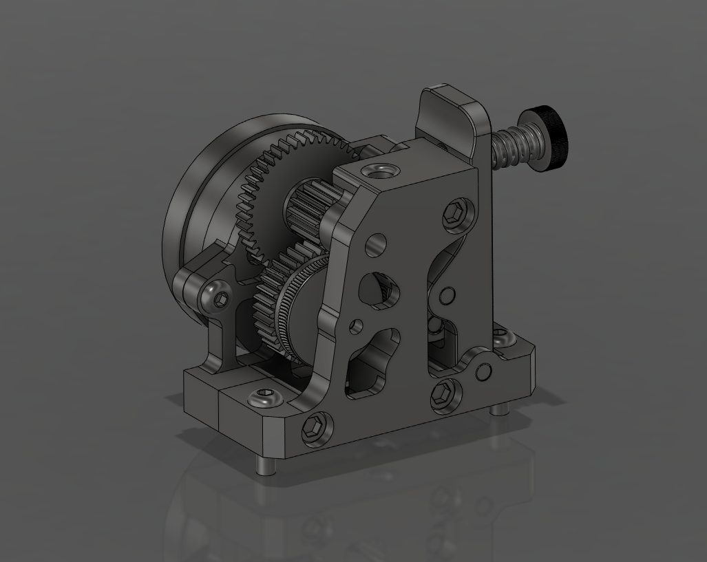
firmware/feeder_v2_mega/feederv2.png
