nht-cyb/yumi-automatic-soldering-thd/firmware/feeder_v2_mega/img/feeder.PNG

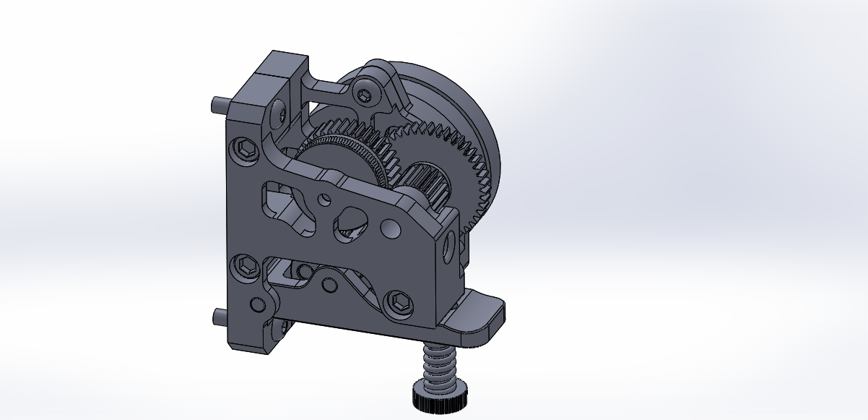
firmware/feeder_v2_mega/img/feeder.PNG
