nht-cyb/yumi-automatic-soldering-thd/firmware/feeder_v2_mega/img/feeder_gear.PNG

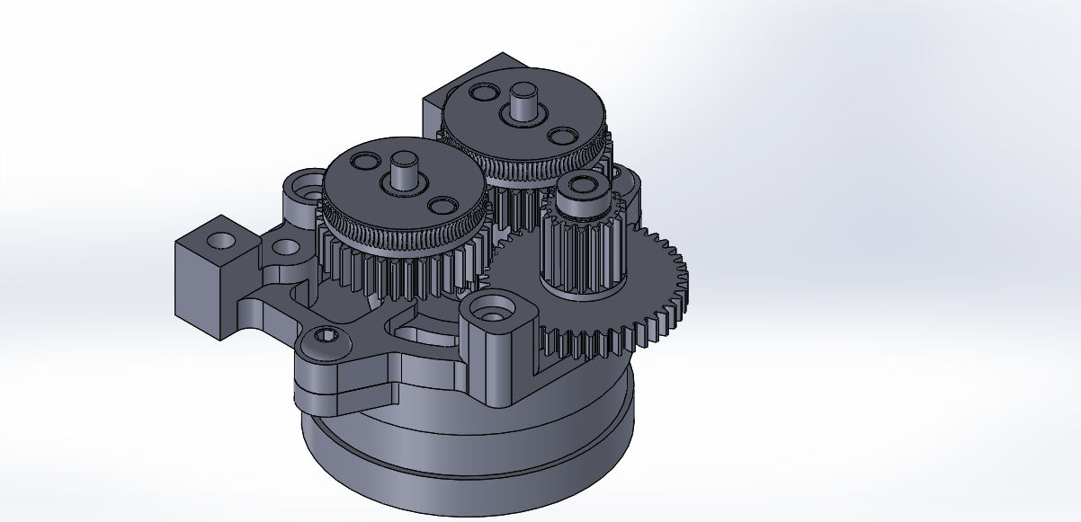
firmware/feeder_v2_mega/img/feeder_gear.PNG
