nht-cyb/yumi-automatic-soldering-thd/firmware/feeder_v2_mega/schematic3/fin_feeder2_schem.png

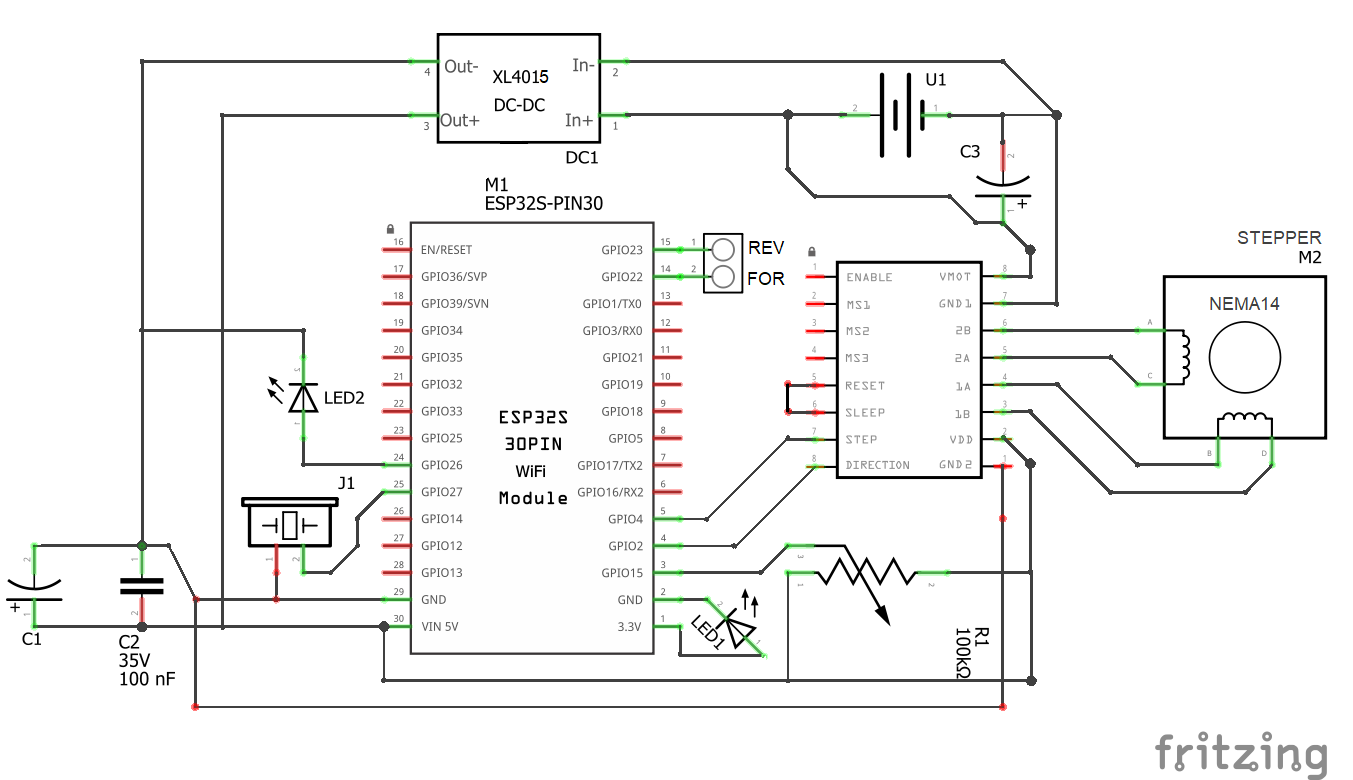
firmware/feeder_v2_mega/schematic3/fin_feeder2_schem.png
