nht-cyb/yumi-automatic-soldering-thd/firmware/feeder_v2_mega/schematic3/schematic3_bb.png

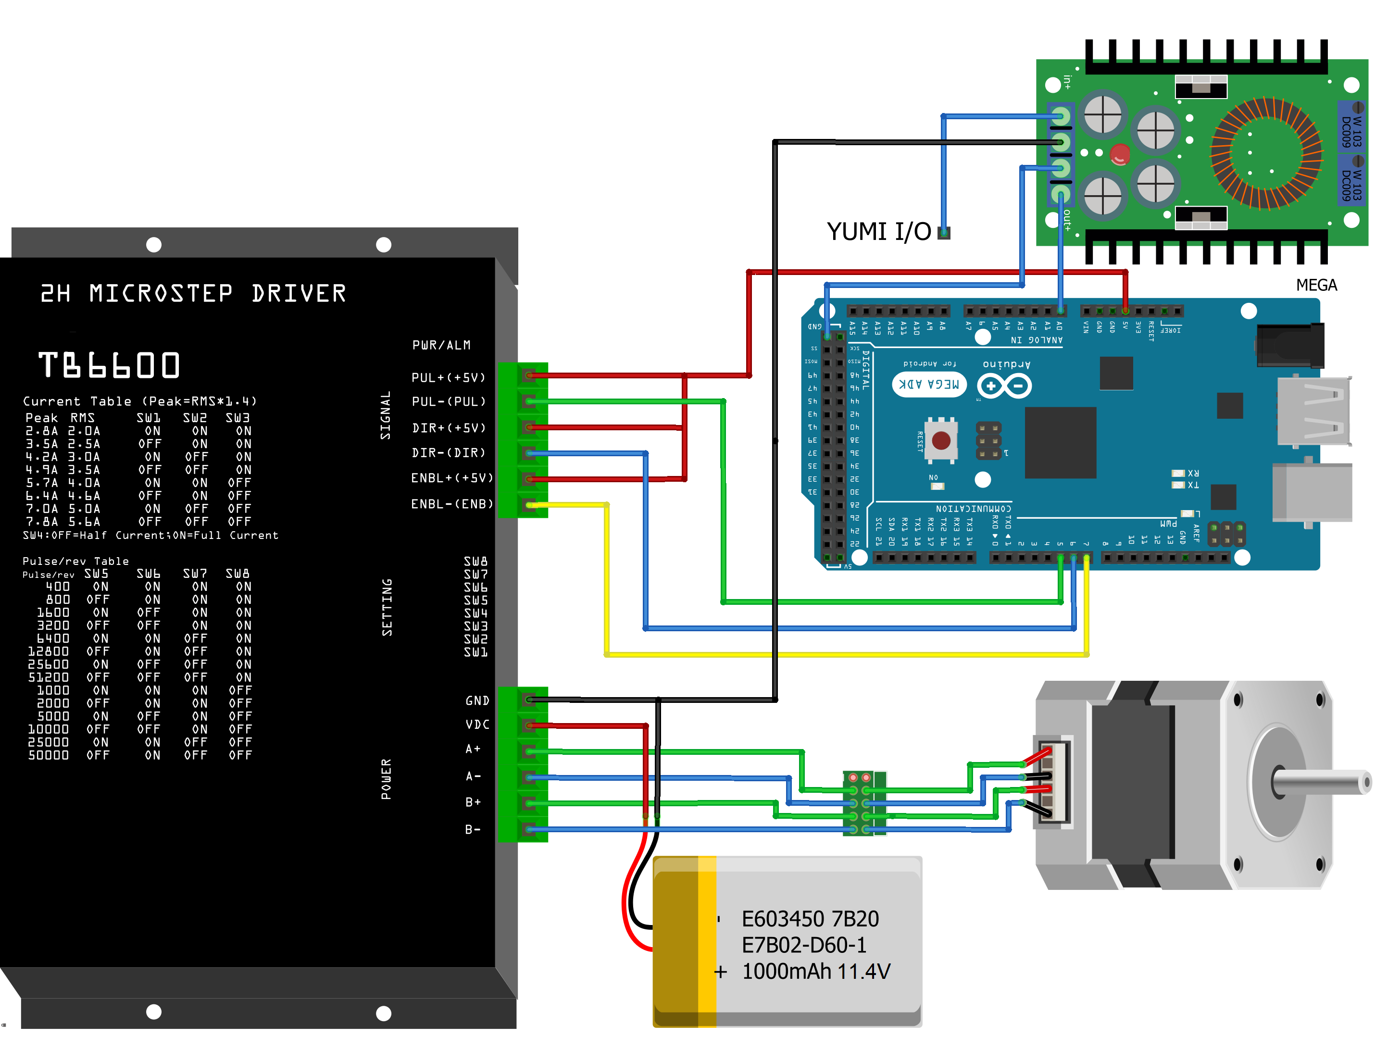
firmware/feeder_v2_mega/schematic3/schematic3_bb.png
