nht-cyb/yumi-automatic-soldering-thd/firmware/feeder_v2_mega/schematic3/schematicV2.png

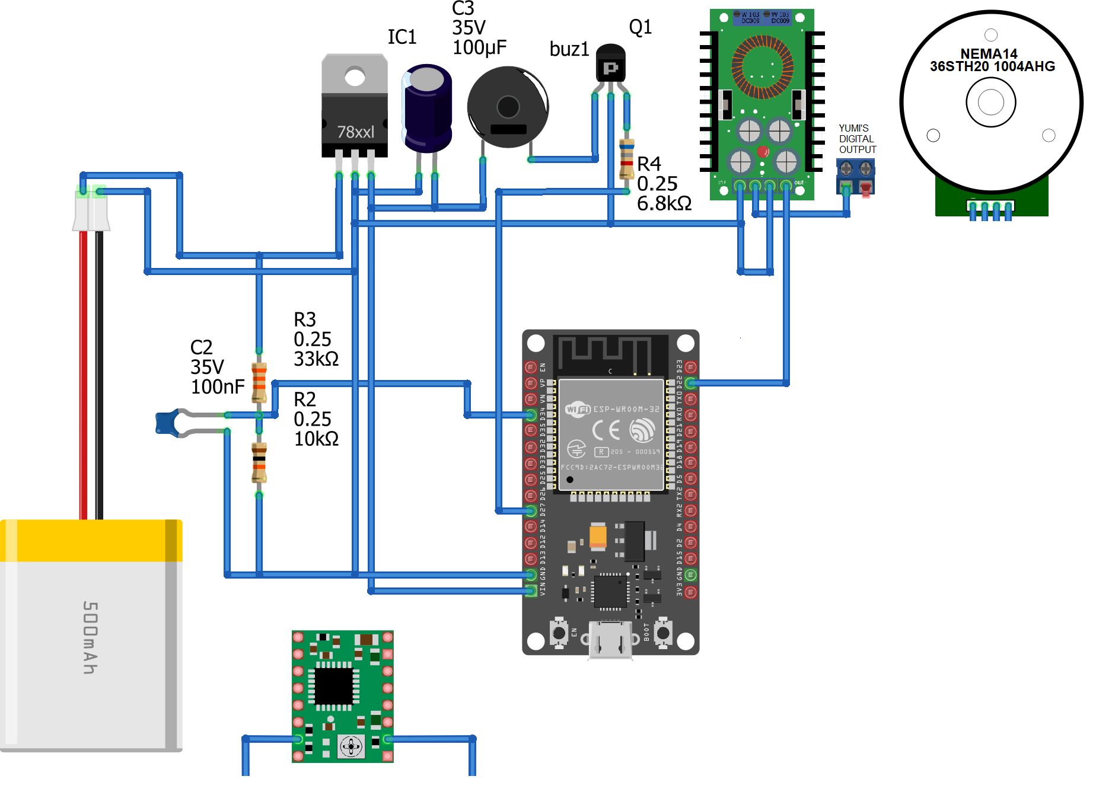
firmware/feeder_v2_mega/schematic3/schematicV2.png
