nht-cyb/yumi-automatic-soldering-thd/web_pcb_selector/img/3x7cm.jpg

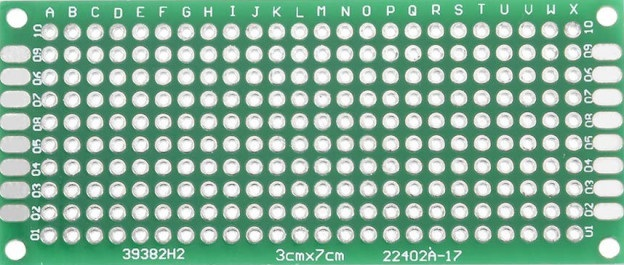
web_pcb_selector/img/3x7cm.jpg
