nht-cyb/yumi-automatic-soldering-thd/web_pcb_selector/img/4x6cm.jpg

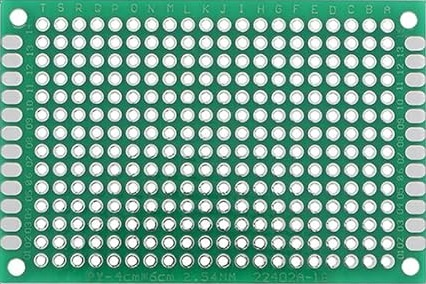
web_pcb_selector/img/4x6cm.jpg
