nht-cyb/yumi-automatic-soldering-thd/web_pcb_selector/img/5x7cm-perfboard-new.png

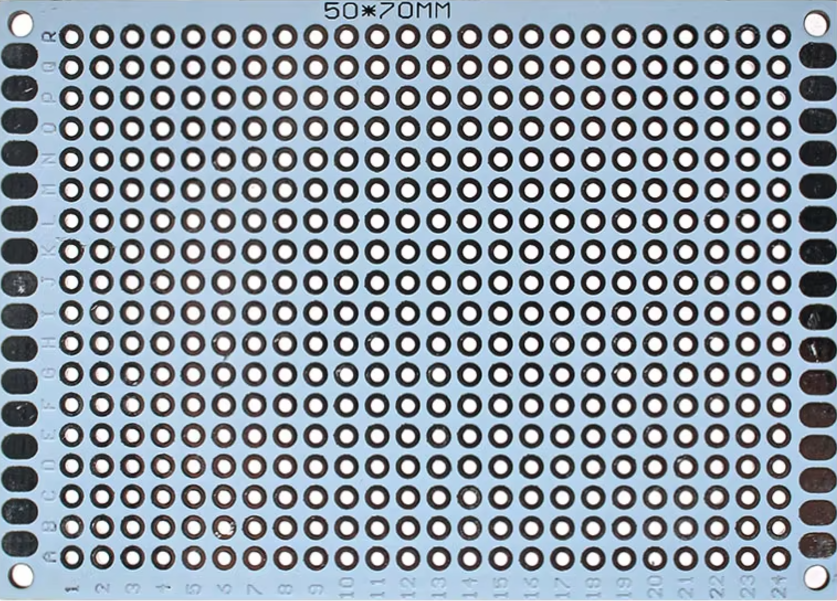
web_pcb_selector/img/5x7cm-perfboard-new.png
