nht-cyb/yumi-automatic-soldering-thd/web_pcb_selector/img/6x8cm-perfboard-480.jpg

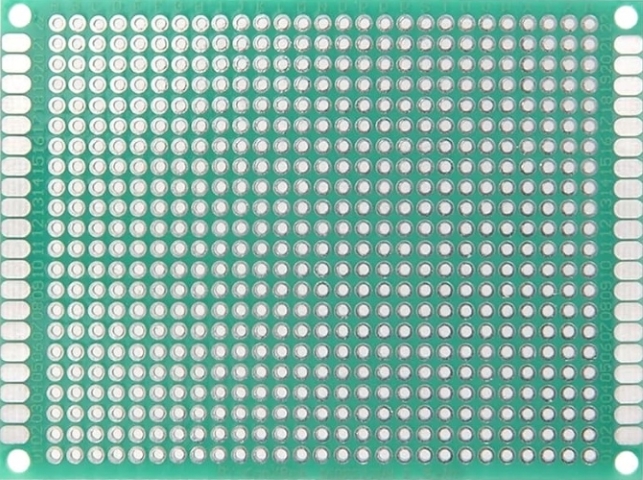
web_pcb_selector/img/6x8cm-perfboard-480.jpg
