nht-cyb/yumi-automatic-soldering-thd/web_pcb_selector/img/8x12cm.jpg

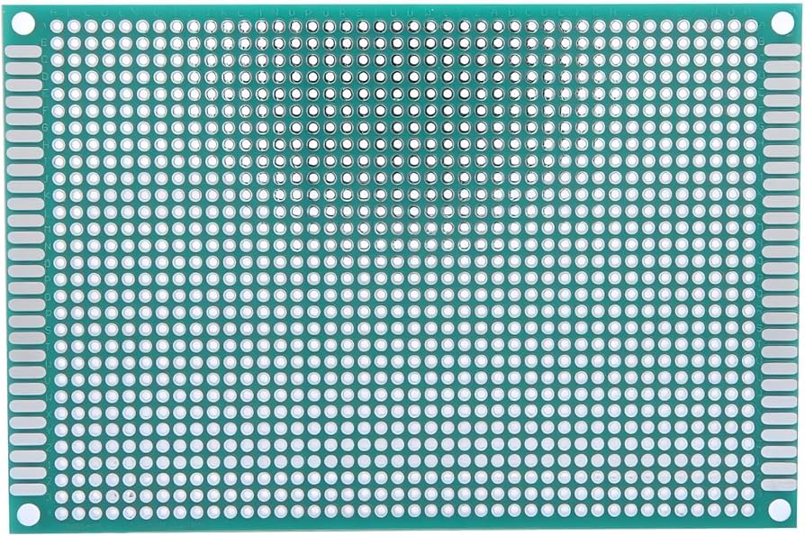
web_pcb_selector/img/8x12cm.jpg
