nht-cyb/yumi-automatic-soldering-thd/firmware/cad/Board Setup/20-PinHeader-Male-2.54mm.SLDASM

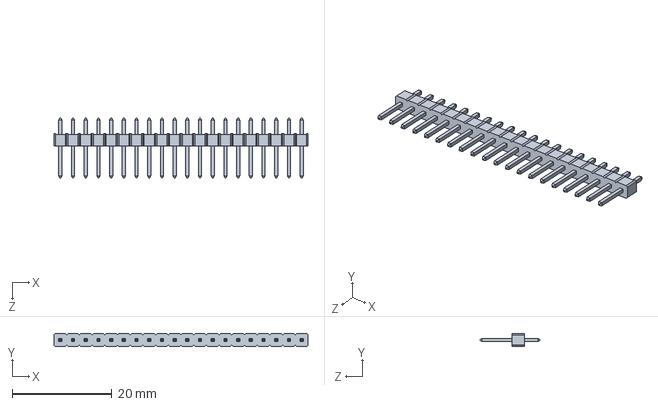
[picture p69: CAD file, 2026-10-10]
firmware/cad/Board Setup/20-PinHeader-Male-2.54mm.SLDASM
50.8 x 2.54 x 11.9 mm
