nht-cyb/yumi-automatic-soldering-thd/firmware/feeder_v1_esp32/SolderFeeder1/Assem1.SLDASM

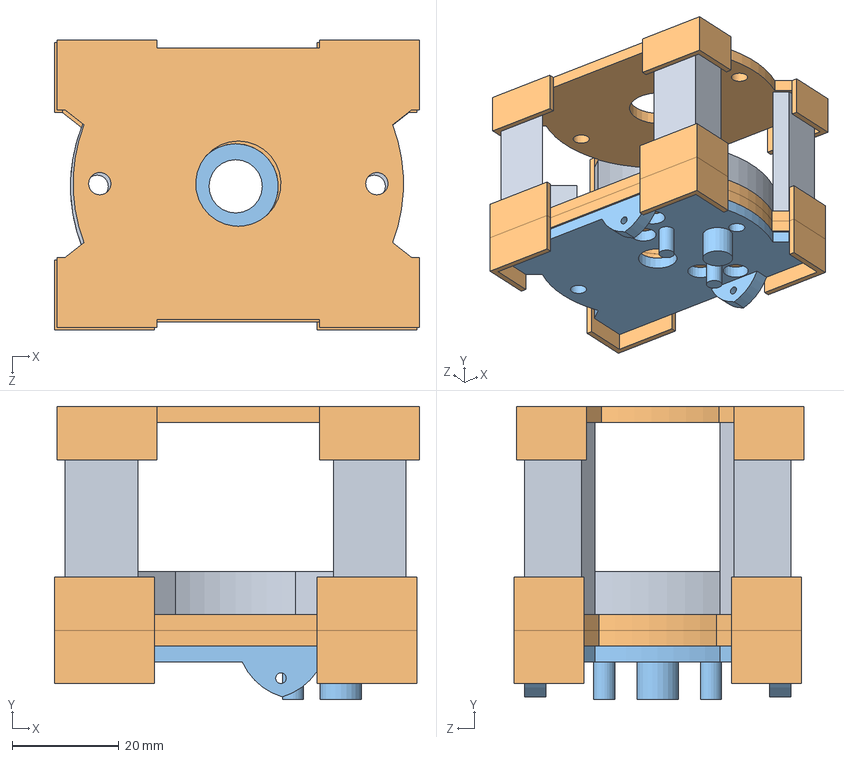
[picture p70: CAD file, 2026-10-10]
firmware/feeder_v1_esp32/SolderFeeder1/Assem1.SLDASM
68.5 x 55.0 x 54.5 mm
motor
motortop x 3
top
