nht-cyb/yumi-automatic-soldering-thd/firmware/cad/Board Setup/pcb_holder.SLDASM

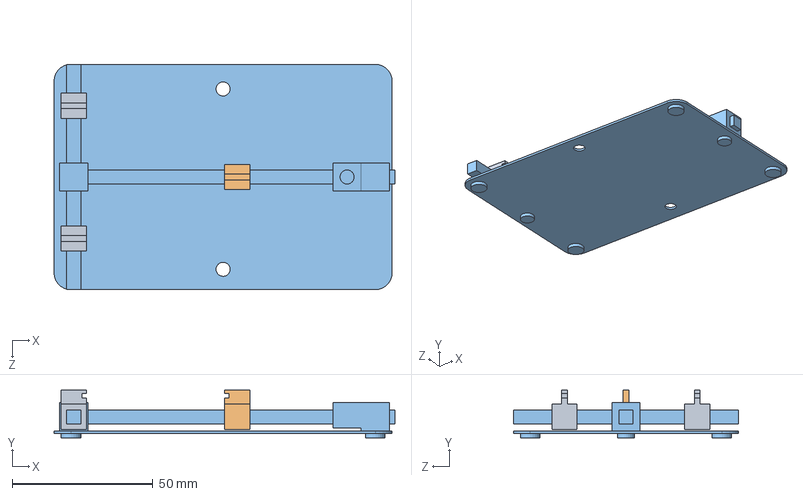
[picture p71: CAD file, 2026-10-10]
firmware/cad/Board Setup/pcb_holder.SLDASM
121.0 x 17.0 x 80.0 mm
2xh_slider x 2
v_slider
holder1
