nht-cyb/yumi-automatic-soldering-thd/firmware/feeder_v1_esp32/SolderFeeder1/Assem2.SLDASM

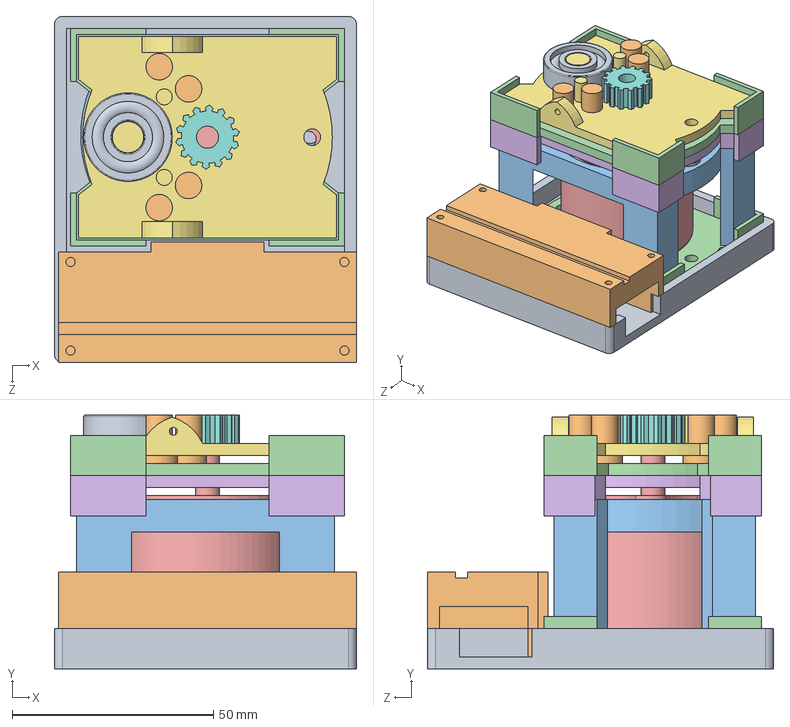
[picture p72: CAD file, 2026-10-10]
firmware/feeder_v1_esp32/SolderFeeder1/Assem2.SLDASM
75.0 x 63.0 x 86.0 mm
batt_holder
batt_holder_top
motor
motortop x 2
nidec24h
board_mount
top
zigzag
radial ball bearing_68_skf
pin x 4
