nht-cyb/yumi-automatic-soldering-thd/firmware/feeder_v1_esp32/SolderFeeder1/Assem1-motor.SLDASM

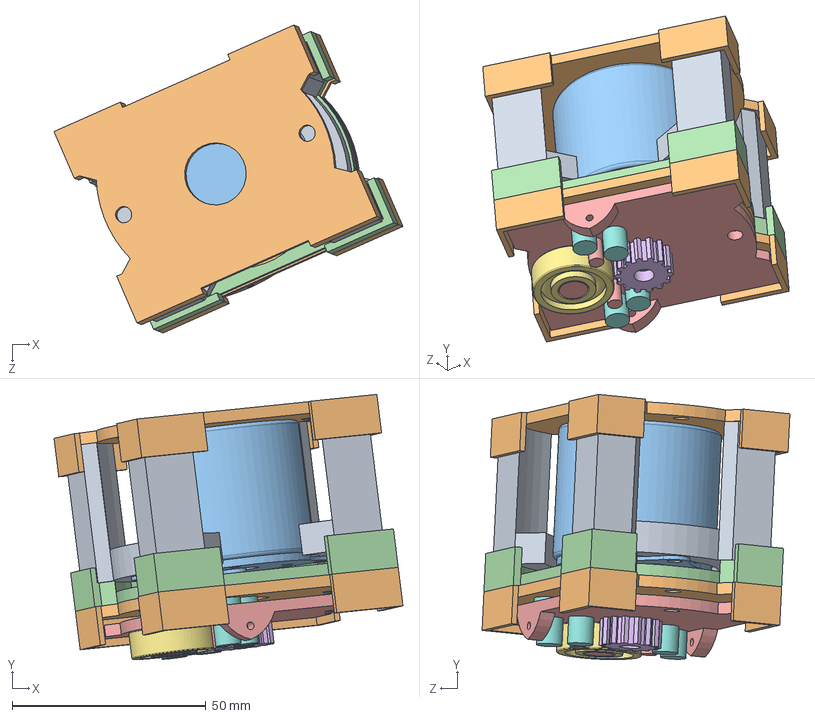
[picture p74: CAD file, 2026-10-10]
firmware/feeder_v1_esp32/SolderFeeder1/Assem1-motor.SLDASM
90.0 x 68.4 x 79.4 mm
motor
motortop x 2
nidec24h
board_mount
top
zigzag
radial ball bearing_68_skf
pin x 4
