nht-cyb/yumi-automatic-soldering-thd/firmware/cad/Board Setup/tableplate_mt.SLDPRT

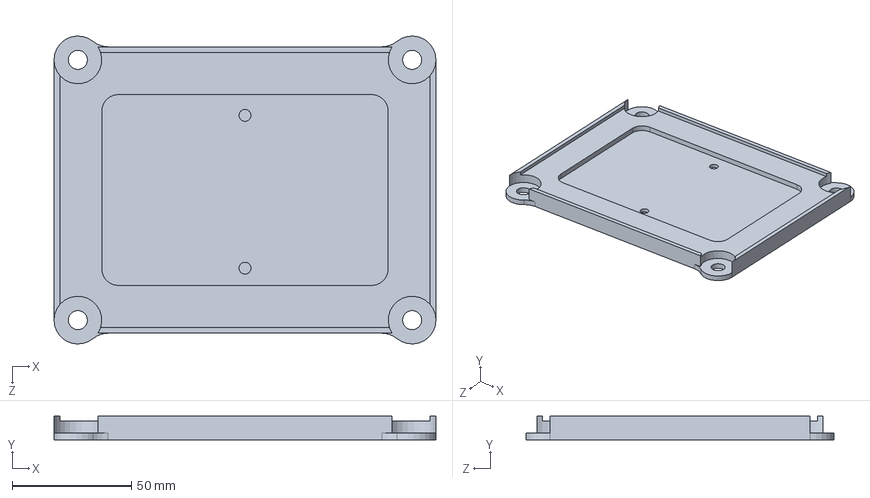
[picture p75: CAD file, 2026-10-10]
firmware/cad/Board Setup/tableplate_mt.SLDPRT
160.0 x 10.0 x 129.0 mm
