nht-cyb/yumi-automatic-soldering-thd/firmware/cad/chot/de_dung_dau_truyen.SLDPRT

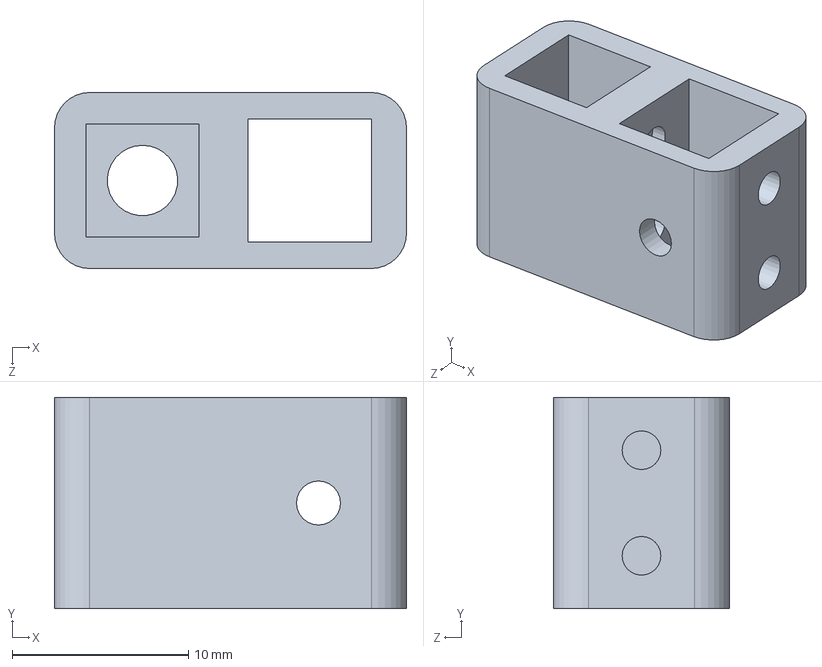
[picture p76: CAD file, 2026-10-10]
firmware/cad/chot/de_dung_dau_truyen.SLDPRT
20.0 x 12.0 x 10.0 mm
