nht-cyb/yumi-automatic-soldering-thd/firmware/cad/GripperVer2/b_holder.SLDPRT

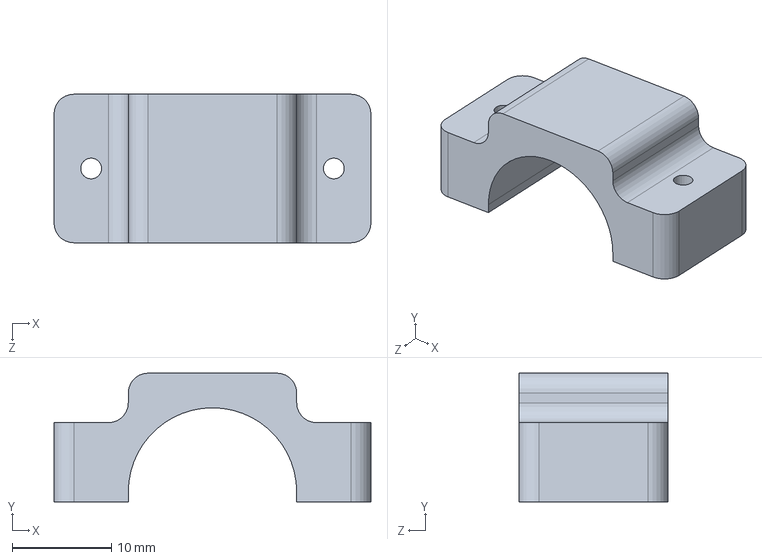
[picture p77: CAD file, 2026-10-10]
firmware/cad/GripperVer2/b_holder.SLDPRT
32.0 x 13.0 x 15.0 mm
