nht-cyb/yumi-automatic-soldering-thd/firmware/cad/HGX-extruder.stp

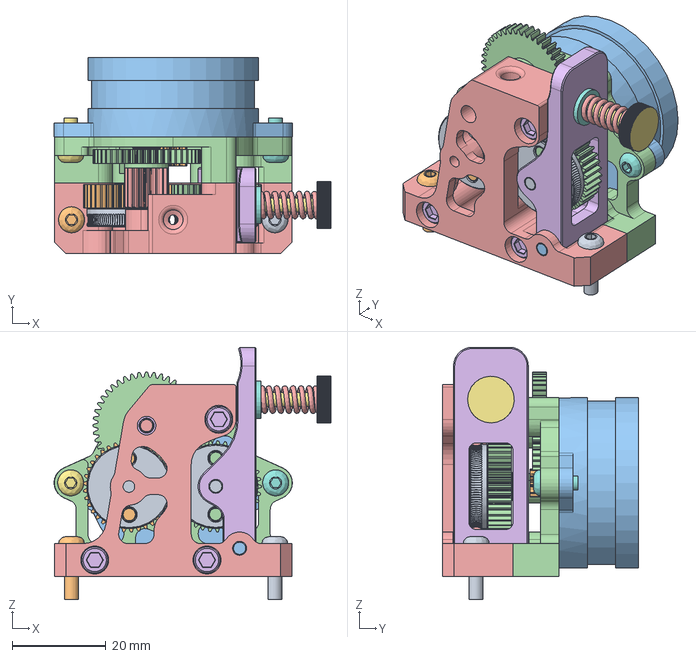
[picture p78: CAD file, 2026-10-10]
firmware/cad/HGX-extruder.stp
59.2 x 42.0 x 54.0 mm
