nht-cyb/yumi-automatic-soldering-thd/firmware/cad/Print2/newp/motorjoint.STL

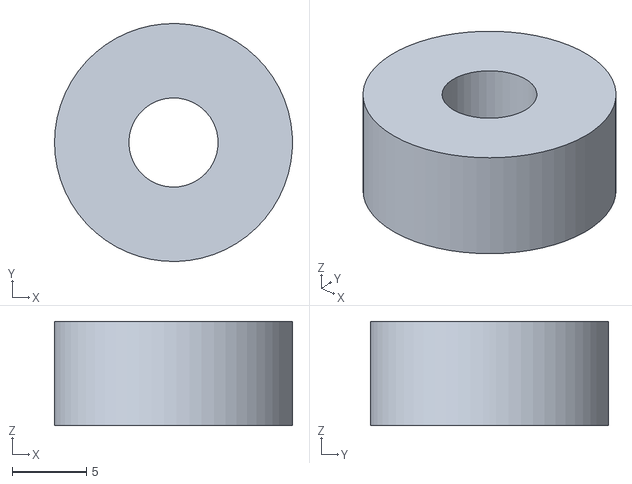
[picture p79: CAD file, 2026-10-10]
firmware/cad/Print2/newp/motorjoint.STL
16.0 x 16.0 x 7.00
