nht-cyb/yumi-automatic-soldering-thd/firmware/cad/Print2/pin_holder.SLDPRT

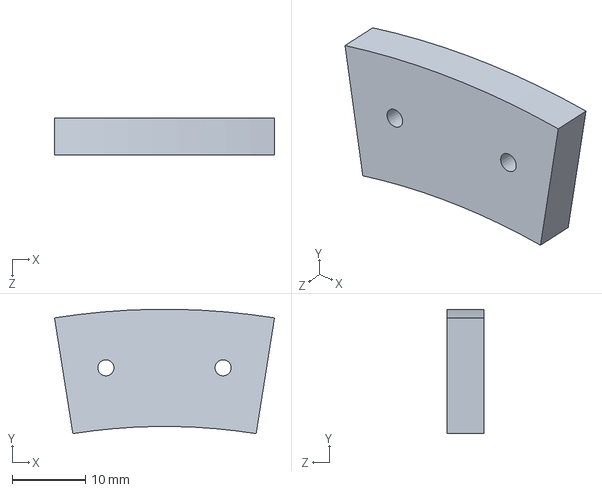
[picture p80: CAD file, 2026-10-10]
firmware/cad/Print2/pin_holder.SLDPRT
30.0 x 17.0 x 5.00 mm
