nht-cyb/yumi-automatic-soldering-thd/firmware/cad/Print2/print_again/motor_joint165.STL

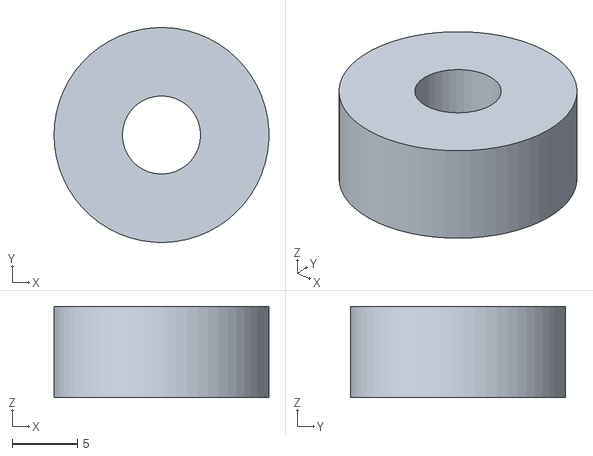
[picture p81: CAD file, 2026-10-10]
firmware/cad/Print2/print_again/motor_joint165.STL
16.5 x 16.5 x 7.00
