nht-cyb/yumi-automatic-soldering-thd/firmware/feeder_v1_esp32/SolderFeeder1/nidec24h.SLDPRT

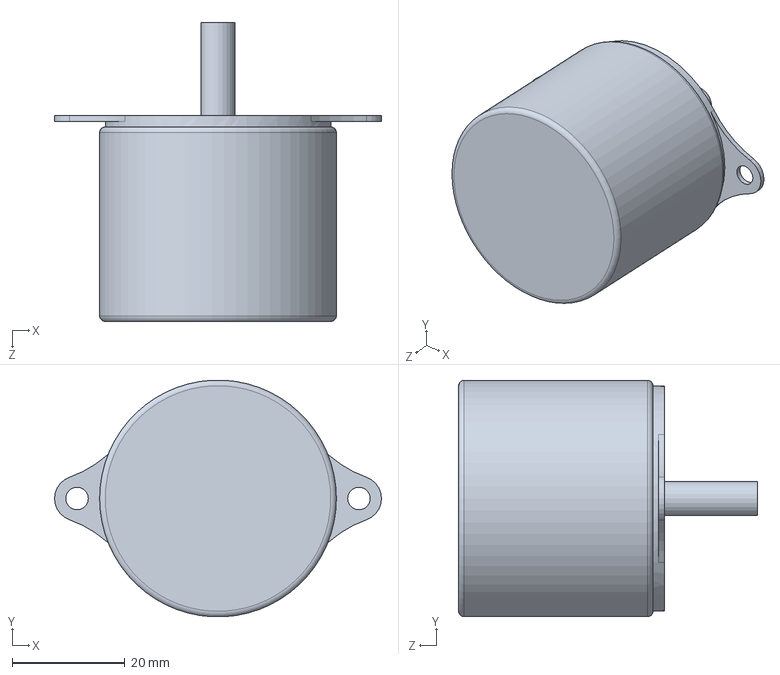
[picture p82: CAD file, 2026-10-10]
firmware/feeder_v1_esp32/SolderFeeder1/nidec24h.SLDPRT
58.0 x 41.9 x 53.0 mm
