nht-cyb/yumi-automatic-soldering-thd/firmware/cad/chot/chotcai.SLDPRT

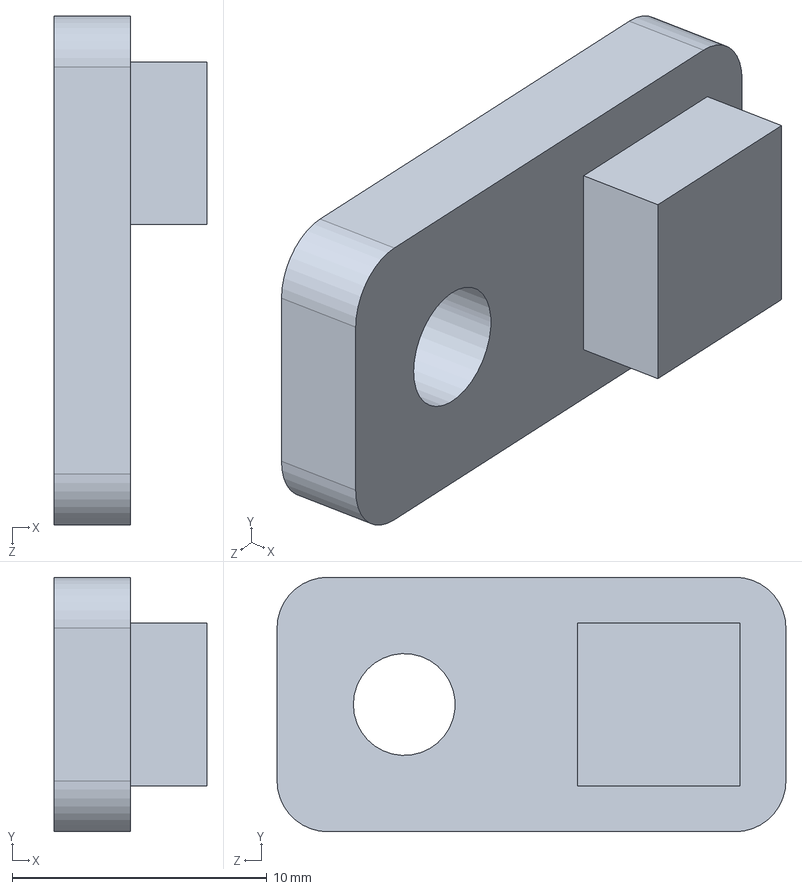
[picture p83: CAD file, 2026-10-10]
firmware/cad/chot/chotcai.SLDPRT
6.00 x 10.0 x 20.0 mm
