nht-cyb/yumi-automatic-soldering-thd/firmware/cad/Print2/motor.SLDPRT

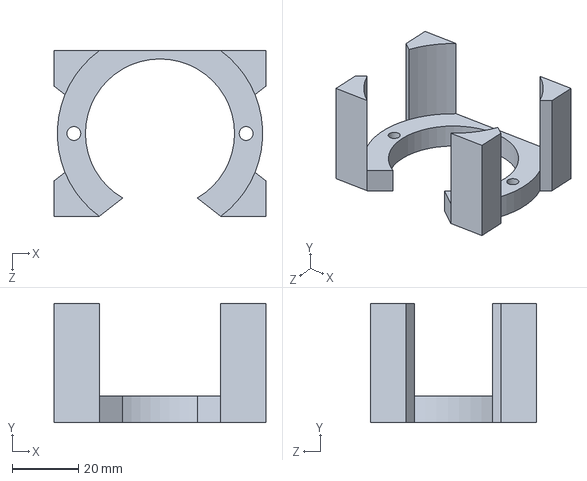
[picture p84: CAD file, 2026-10-10]
firmware/cad/Print2/motor.SLDPRT
64.0 x 36.0 x 50.0 mm
