nht-cyb/yumi-automatic-soldering-thd/firmware/cad/Print2/newp/flat_surface.STL

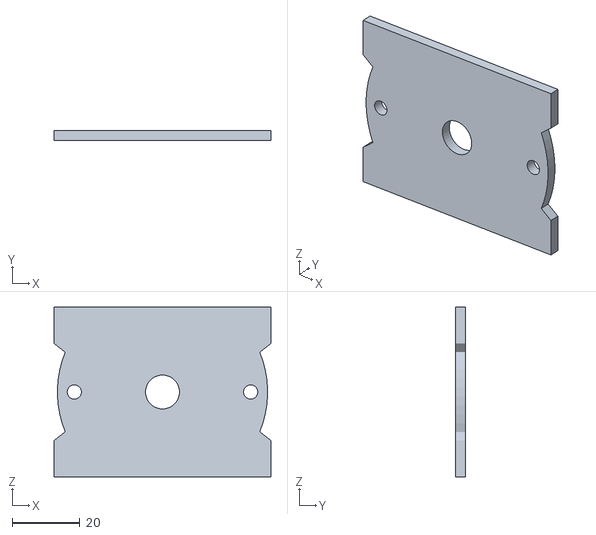
[picture p85: CAD file, 2026-10-10]
firmware/cad/Print2/newp/flat_surface.STL
64.0 x 3.00 x 50.0
