nht-cyb/yumi-automatic-soldering-thd/firmware/cad/Print2/print_again/motortop.STL

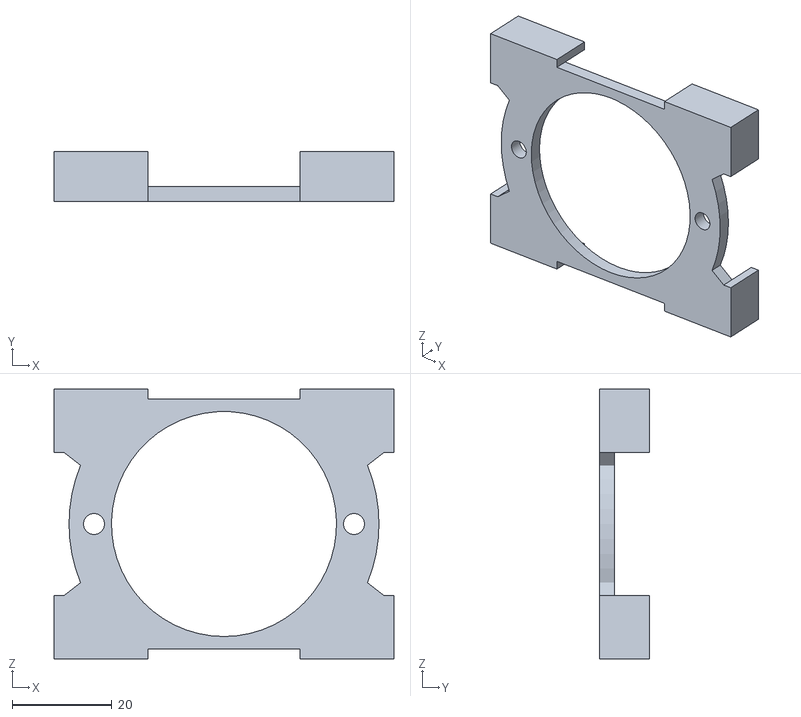
[picture p86: CAD file, 2026-10-10]
firmware/cad/Print2/print_again/motortop.STL
68.0 x 10.0 x 54.0
