nht-cyb/yumi-automatic-soldering-thd/firmware/cad/SLW_Hakko/BendingGuard.SLDPRT

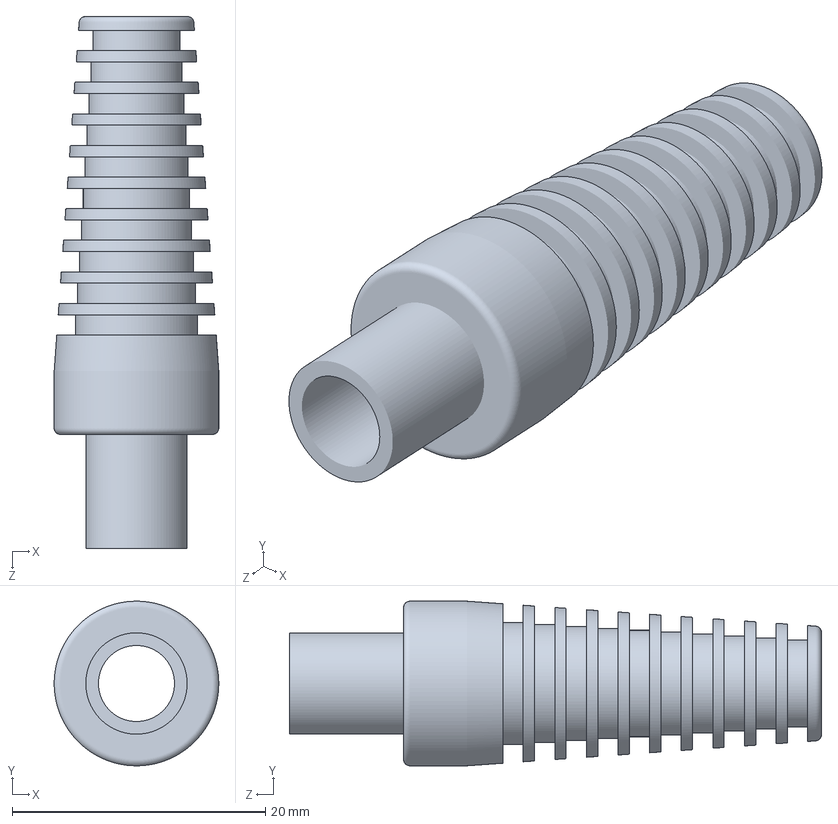
[picture p87: CAD file, 2026-10-10]
firmware/cad/SLW_Hakko/BendingGuard.SLDPRT
13.0 x 13.0 x 42.0 mm
