nht-cyb/yumi-automatic-soldering-thd/firmware/feeder_v1_esp32/SolderFeeder1/flat_surface_no2.SLDPRT

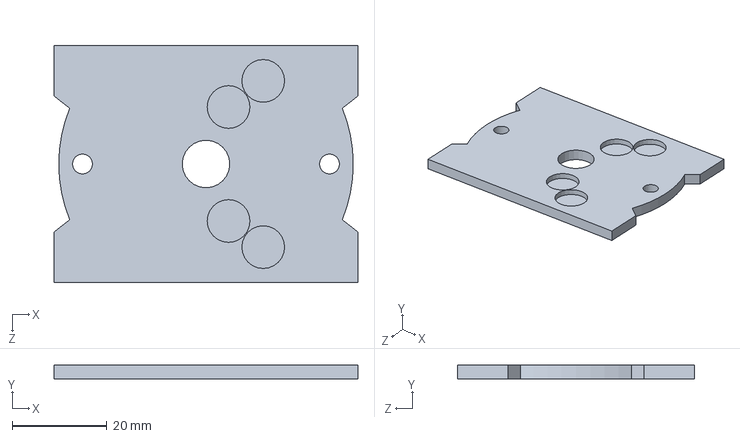
[picture p88: CAD file, 2026-10-10]
firmware/feeder_v1_esp32/SolderFeeder1/flat_surface_no2.SLDPRT
64.0 x 3.00 x 50.0 mm
