nht-cyb/yumi-automatic-soldering-thd/firmware/cad/Board Setup/holder1.SLDPRT

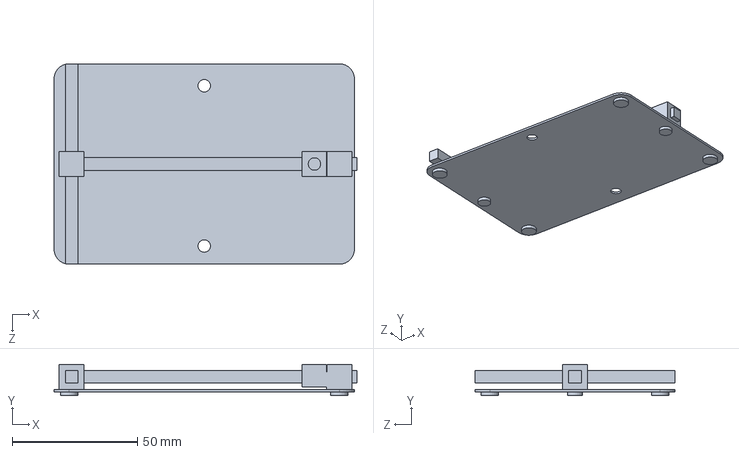
[picture p89: CAD file, 2026-10-10]
firmware/cad/Board Setup/holder1.SLDPRT
121.0 x 12.5 x 80.0 mm
