nht-cyb/yumi-automatic-soldering-thd/firmware/cad/GripperVer2/solderfeed5cm.SLDPRT

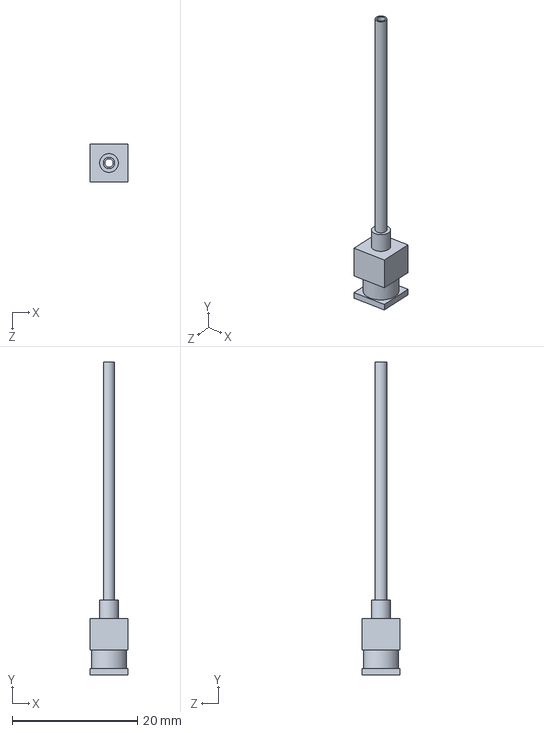
[picture p90: CAD file, 2026-10-10]
firmware/cad/GripperVer2/solderfeed5cm.SLDPRT
6.00 x 50.0 x 6.00 mm
