nht-cyb/yumi-automatic-soldering-thd/firmware/cad/SLW_Hakko/RubberCollar.SLDPRT

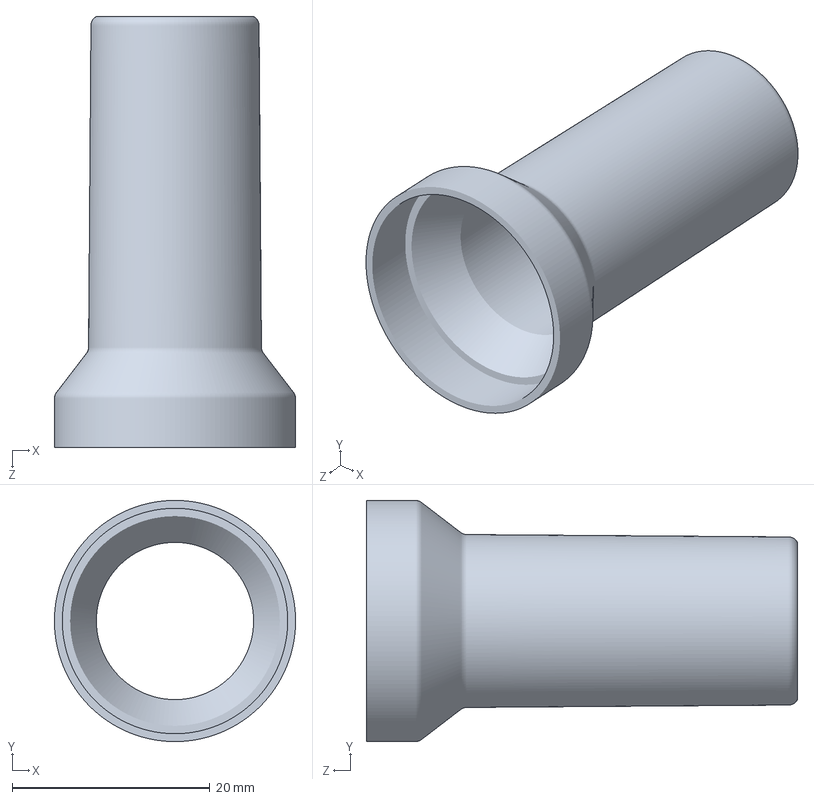
[picture p91: CAD file, 2026-10-10]
firmware/cad/SLW_Hakko/RubberCollar.SLDPRT
24.4 x 24.4 x 43.6 mm
