nht-cyb/yumi-automatic-soldering-thd/firmware/feeder_v1_esp32/SolderFeeder1/pin.SLDPRT

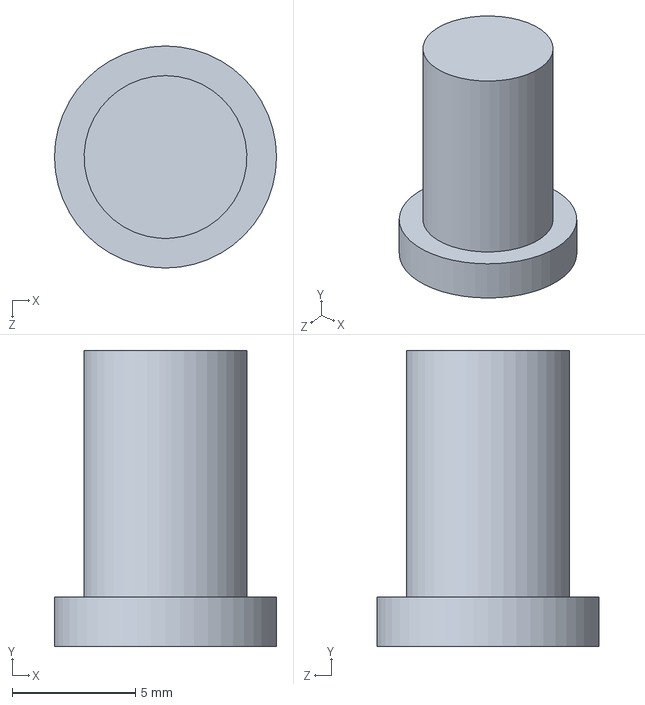
[picture p92: CAD file, 2026-10-10]
firmware/feeder_v1_esp32/SolderFeeder1/pin.SLDPRT
9.00 x 12.0 x 9.00 mm
