nht-cyb/yumi-automatic-soldering-thd/firmware/cad/Board Setup/v_slider.SLDPRT

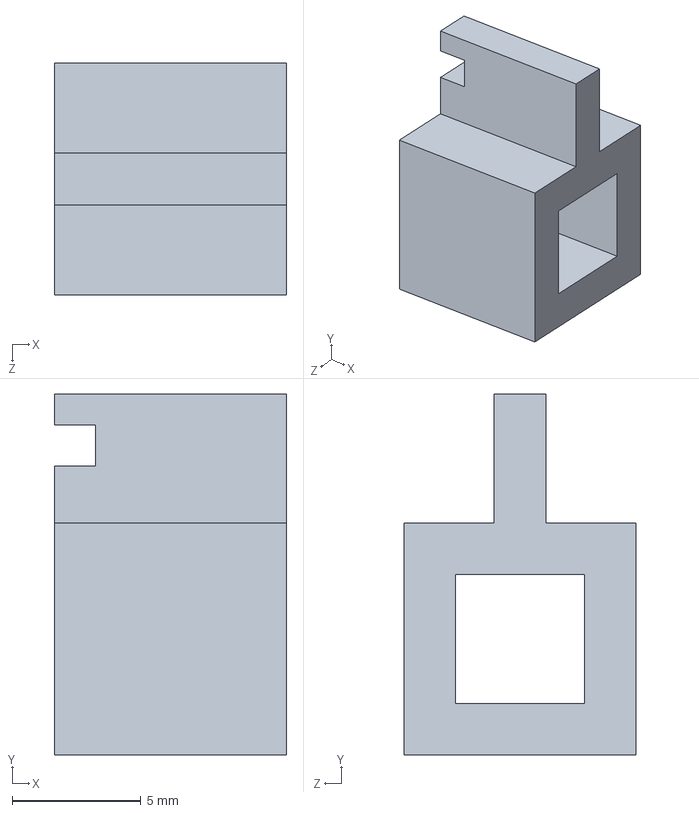
[picture p93: CAD file, 2026-10-10]
firmware/cad/Board Setup/v_slider.SLDPRT
9.00 x 14.0 x 9.00 mm
