nht-cyb/yumi-automatic-soldering-thd/firmware/cad/GripperVer2/yumi_to_mp.SLDPRT

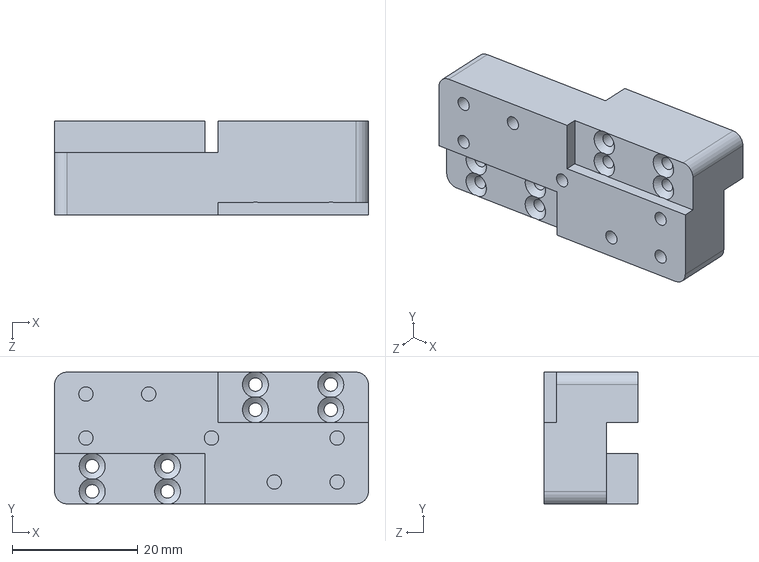
[picture p94: CAD file, 2026-10-10]
firmware/cad/GripperVer2/yumi_to_mp.SLDPRT
50.0 x 21.0 x 15.0 mm
