nht-cyb/yumi-automatic-soldering-thd/firmware/cad/Print2/newp/zigzag.STL

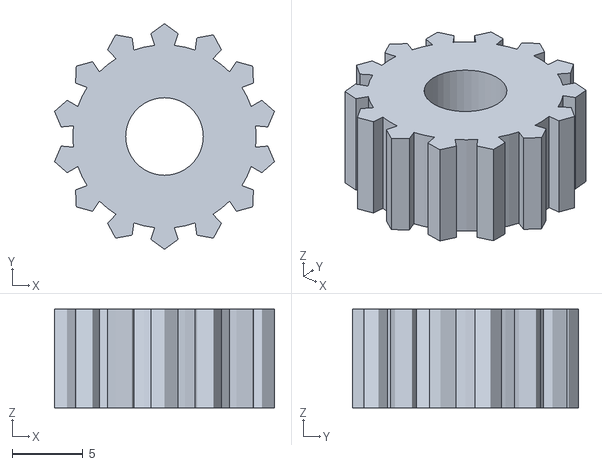
[picture p95: CAD file, 2026-10-10]
firmware/cad/Print2/newp/zigzag.STL
15.6 x 16.0 x 7.00
