nht-cyb/yumi-automatic-soldering-thd/firmware/cad/Print2/Part4_1hole.SLDPRT

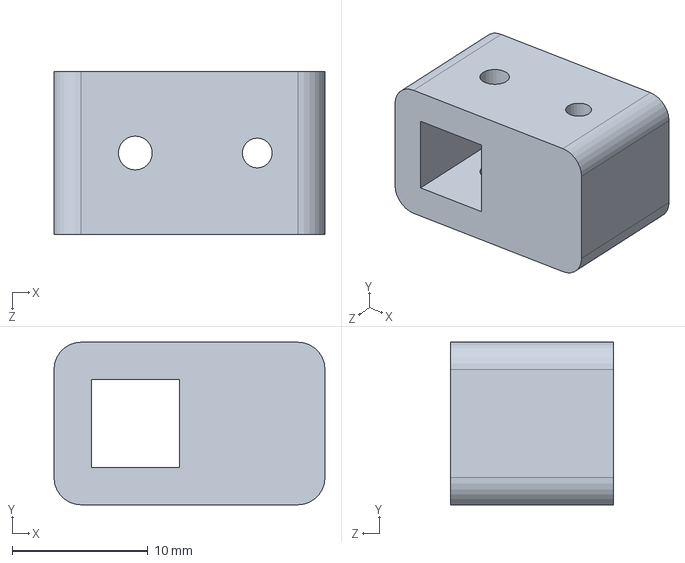
[picture p96: CAD file, 2026-10-10]
firmware/cad/Print2/Part4_1hole.SLDPRT
20.0 x 12.0 x 12.0 mm
