nht-cyb/yumi-automatic-soldering-thd/firmware/cad/Print2/print_again/batt_holder_top.STL

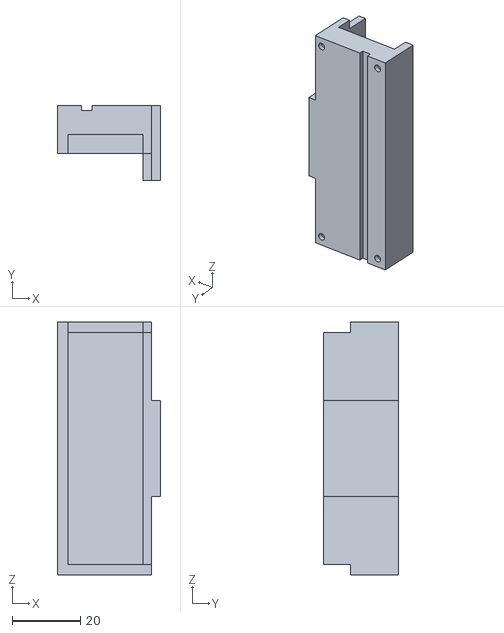
[picture p97: CAD file, 2026-10-10]
firmware/cad/Print2/print_again/batt_holder_top.STL
30.0 x 22.0 x 74.0
