nht-cyb/yumi-automatic-soldering-thd/firmware/cad/SLW_Hakko/Heater.SLDPRT

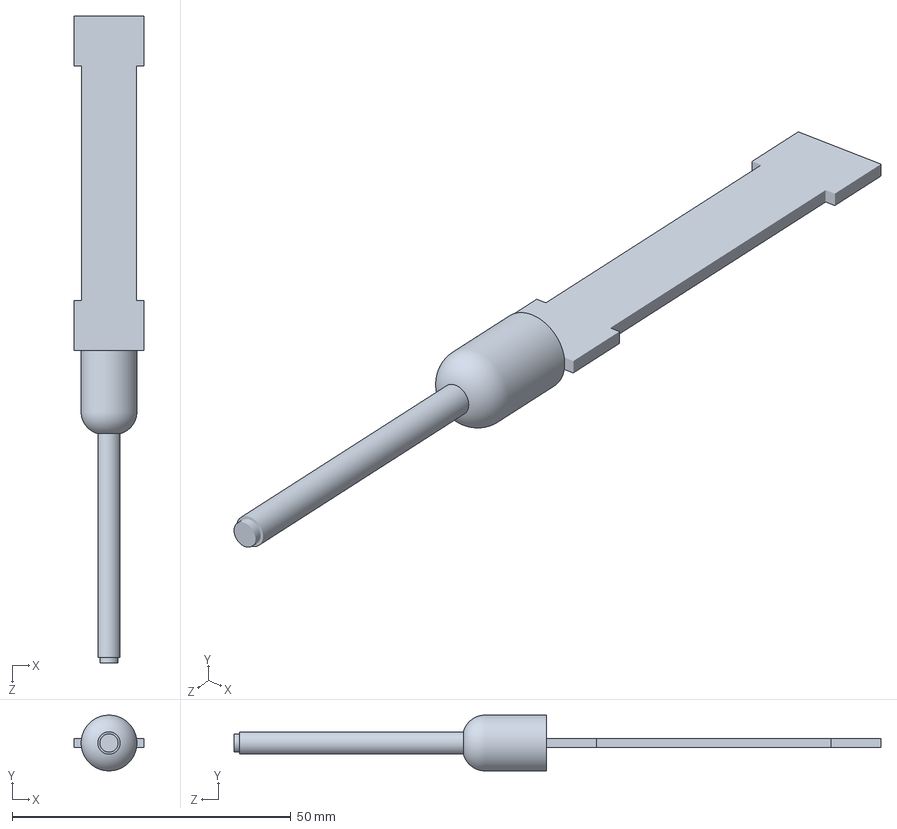
[picture p98: CAD file, 2026-10-10]
firmware/cad/SLW_Hakko/Heater.SLDPRT
12.6 x 10.00 x 116.0 mm
