nht-cyb/yumi-automatic-soldering-thd/firmware/cad/GripperVer2/yumi_mount.SLDPRT

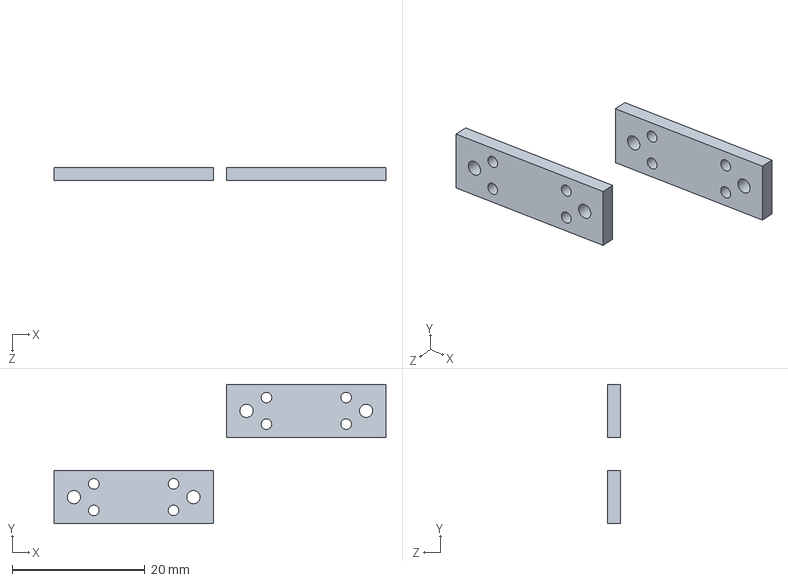
[picture p99: CAD file, 2026-10-10]
firmware/cad/GripperVer2/yumi_mount.SLDPRT
50.0 x 21.0 x 2.00 mm
