nht-cyb/yumi-automatic-soldering-thd/firmware/cad/Print2/newp/top.STL

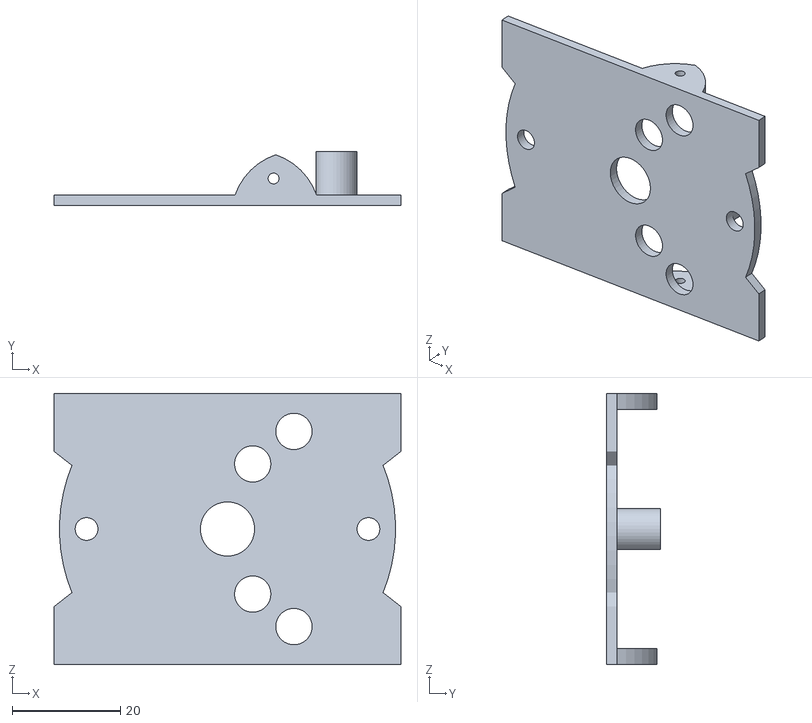
[picture p100: CAD file, 2026-10-10]
firmware/cad/Print2/newp/top.STL
64.0 x 10.0 x 50.0
