nht-cyb/yumi-automatic-soldering-thd/firmware/cad/Print2/part_to 2_anglers.SLDPRT

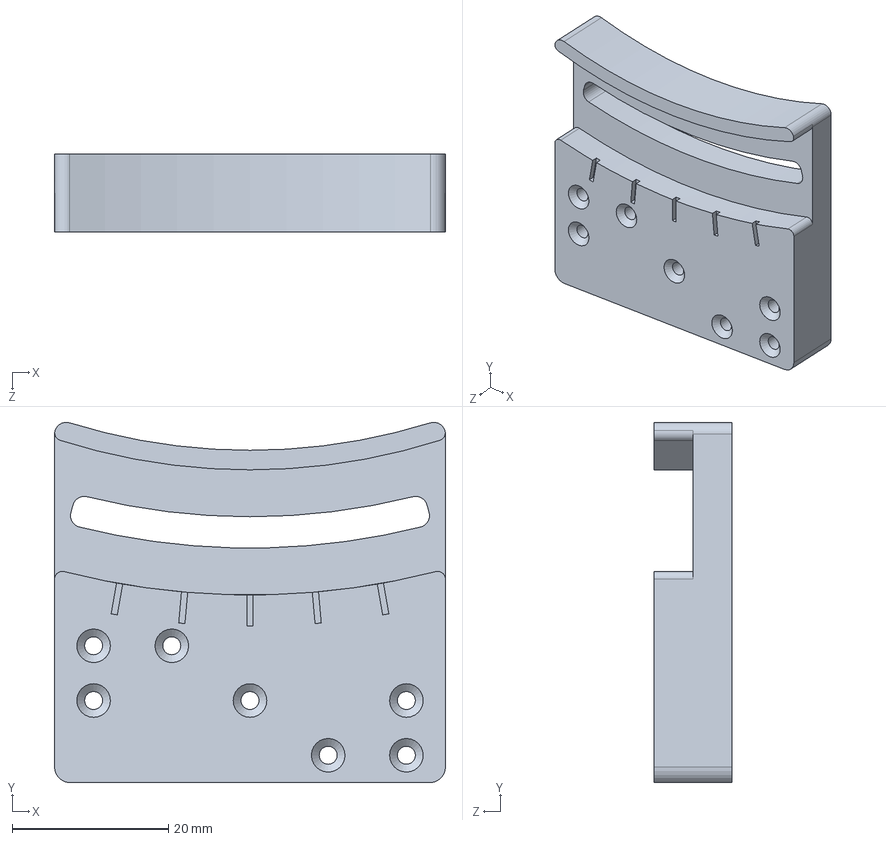
[picture p101: CAD file, 2026-10-10]
firmware/cad/Print2/part_to 2_anglers.SLDPRT
50.0 x 46.1 x 10.0 mm
