nht-cyb/yumi-automatic-soldering-thd/firmware/cad/Print2/print_again/top.STL

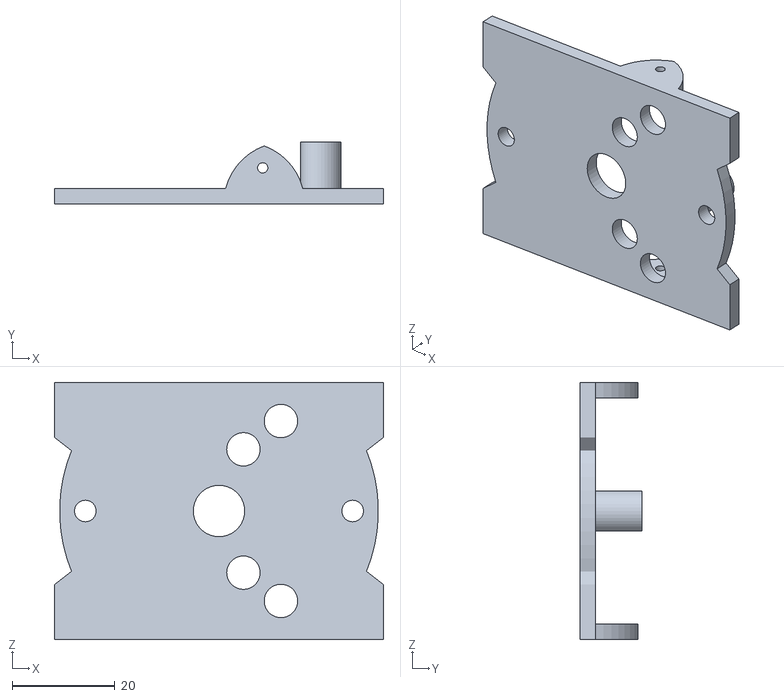
[picture p102: CAD file, 2026-10-10]
firmware/cad/Print2/print_again/top.STL
64.0 x 12.0 x 50.0
