nht-cyb/yumi-automatic-soldering-thd/firmware/cad/SLW_Hakko/Barrel.SLDPRT

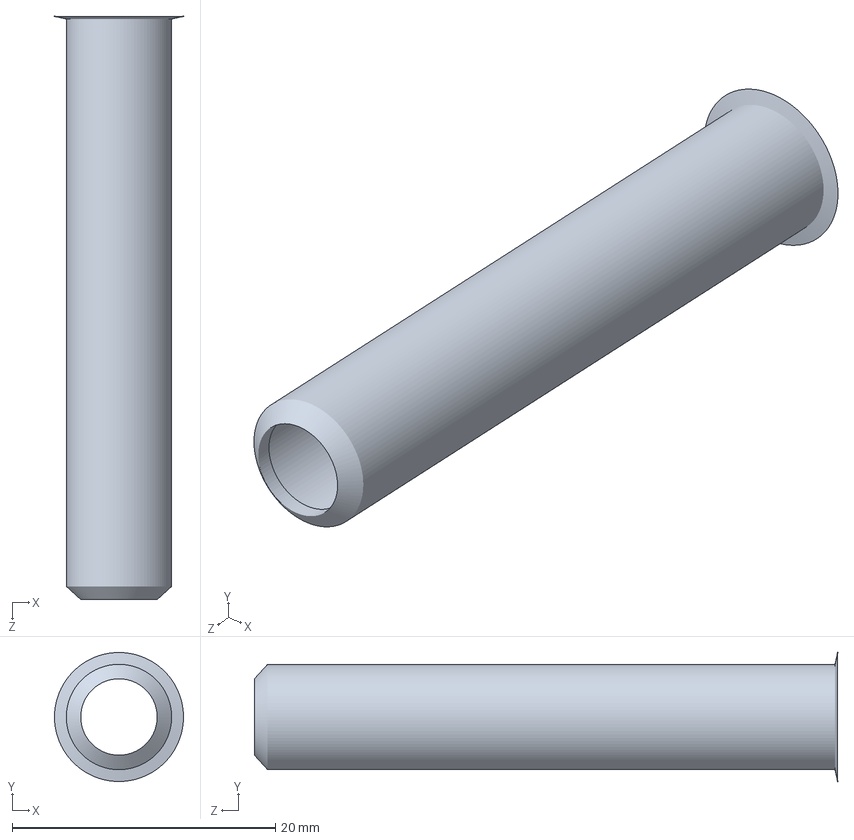
[picture p103: CAD file, 2026-10-10]
firmware/cad/SLW_Hakko/Barrel.SLDPRT
9.80 x 9.80 x 44.3 mm
