nht-cyb/yumi-automatic-soldering-thd/firmware/feeder_v1_esp32/SolderFeeder1/batt_holder.SLDPRT

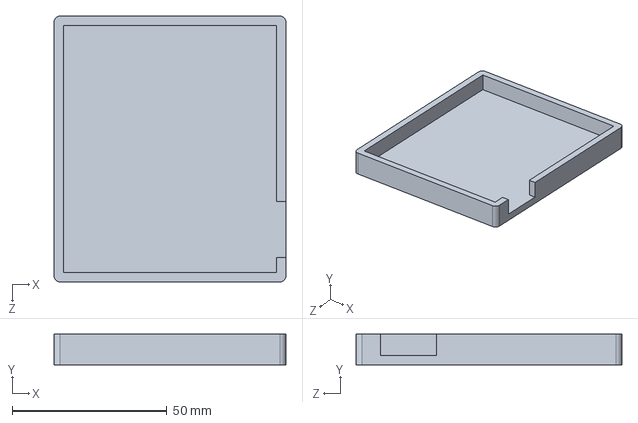
[picture p104: CAD file, 2026-10-10]
firmware/feeder_v1_esp32/SolderFeeder1/batt_holder.SLDPRT
75.0 x 10.0 x 86.0 mm
