nht-cyb/yumi-automatic-soldering-thd/firmware/cad/Board Setup/pole.SLDPRT

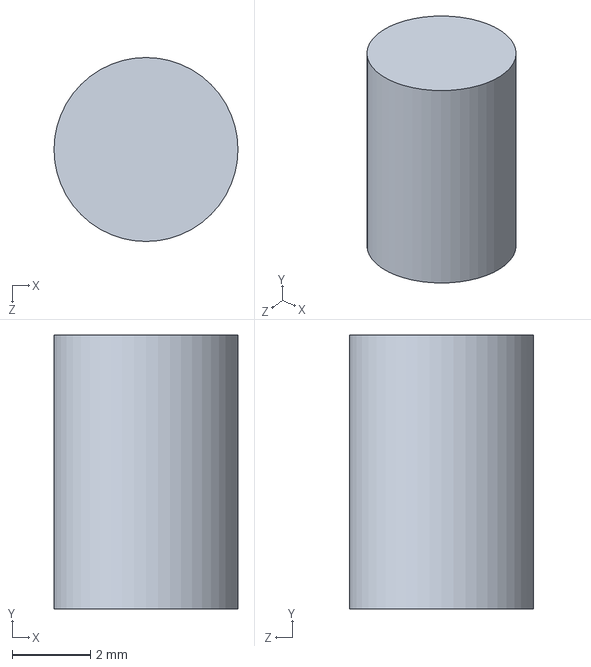
[picture p105: CAD file, 2026-10-10]
firmware/cad/Board Setup/pole.SLDPRT
4.70 x 7.00 x 4.70 mm
