nht-cyb/yumi-automatic-soldering-thd/firmware/cad/Print2/print_again/motor_joint155.STL

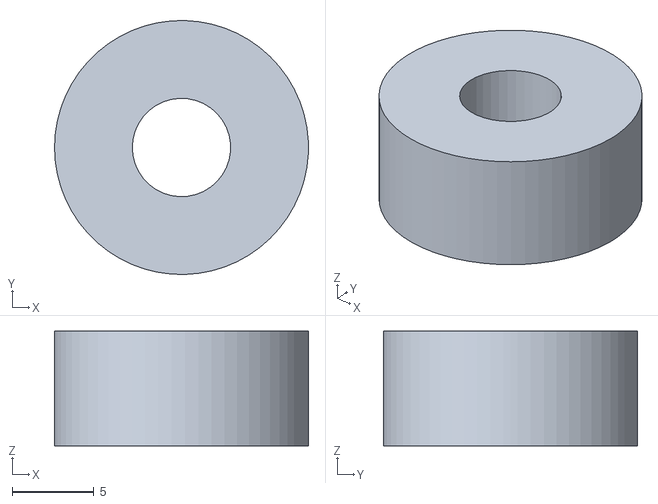
[picture p106: CAD file, 2026-10-10]
firmware/cad/Print2/print_again/motor_joint155.STL
15.5 x 15.5 x 7.00
