nht-cyb/yumi-automatic-soldering-thd/firmware/cad/Print2/rod_holder.STL

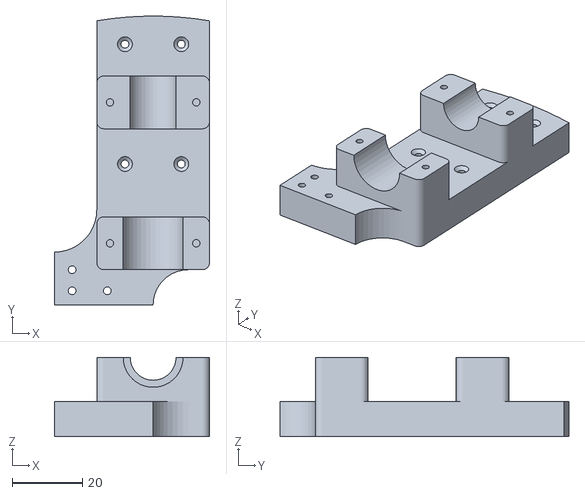
[picture p107: CAD file, 2026-10-10]
firmware/cad/Print2/rod_holder.STL
44.0 x 82.0 x 22.5
