nht-cyb/yumi-automatic-soldering-thd/firmware/cad/SLW_Hakko/Handle.SLDPRT

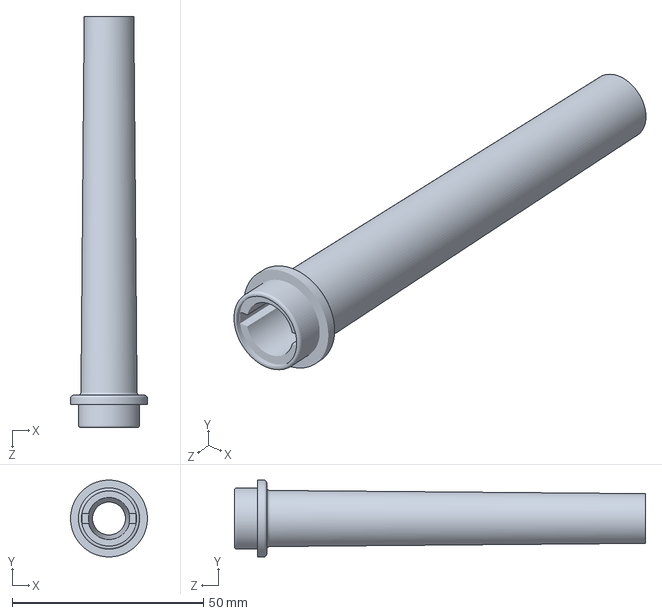
[picture p108: CAD file, 2026-10-10]
firmware/cad/SLW_Hakko/Handle.SLDPRT
20.1 x 20.1 x 107.5 mm
