nht-cyb/yumi-automatic-soldering-thd/firmware/cad/Print2/Part4_flat.SLDPRT

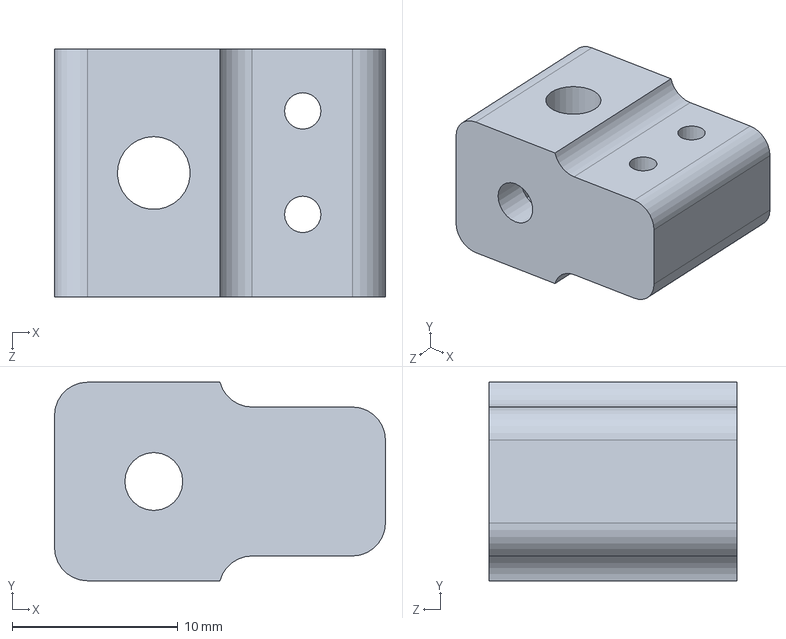
[picture p109: CAD file, 2026-10-10]
firmware/cad/Print2/Part4_flat.SLDPRT
20.0 x 12.0 x 15.0 mm
