nht-cyb/yumi-automatic-soldering-thd/firmware/cad/SLW_Hakko/Tip.SLDPRT

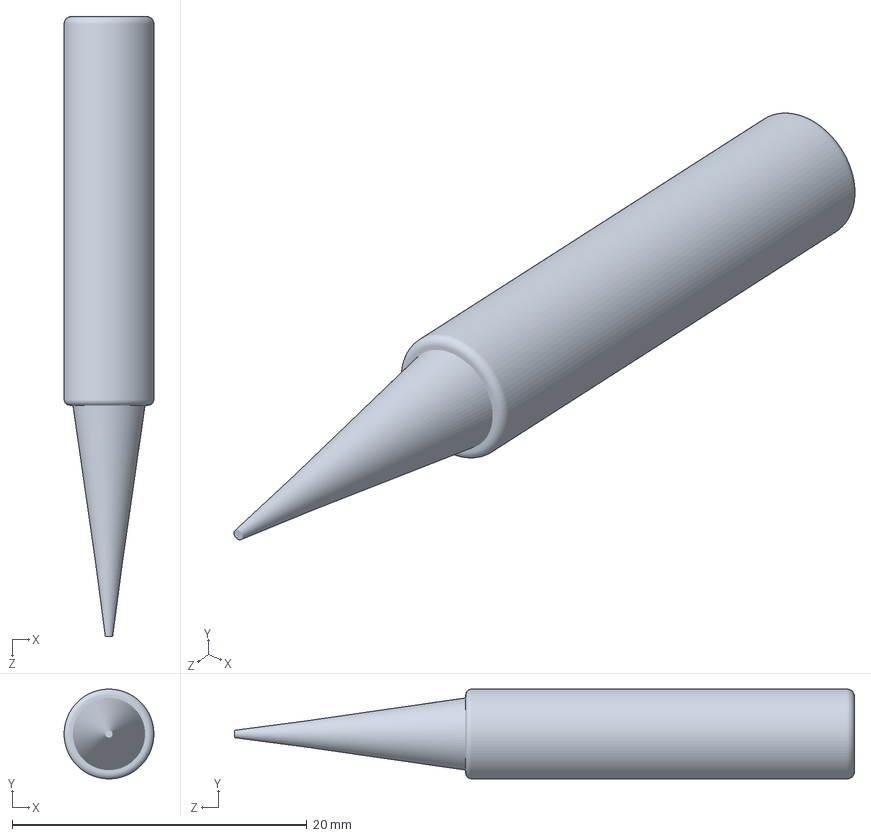
[picture p110: CAD file, 2026-10-10]
firmware/cad/SLW_Hakko/Tip.SLDPRT
6.10 x 6.10 x 42.1 mm
