nht-cyb/yumi-automatic-soldering-thd/firmware/feeder_v1_esp32/SolderFeeder1/battery.SLDPRT

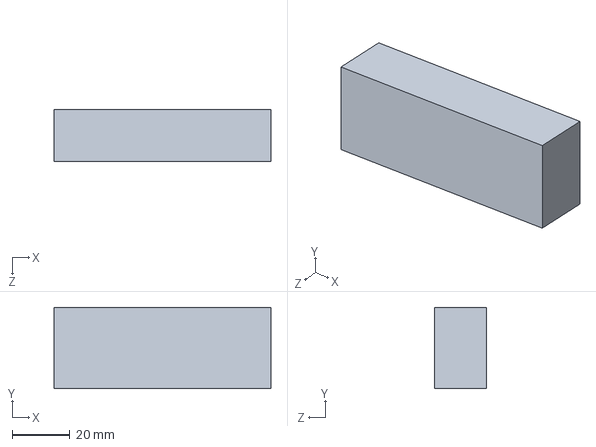
[picture p111: CAD file, 2026-10-10]
firmware/feeder_v1_esp32/SolderFeeder1/battery.SLDPRT
75.0 x 28.0 x 18.0 mm
