nht-cyb/yumi-automatic-soldering-thd/firmware/cad/GripperVer2/solderfeed10cm.SLDPRT

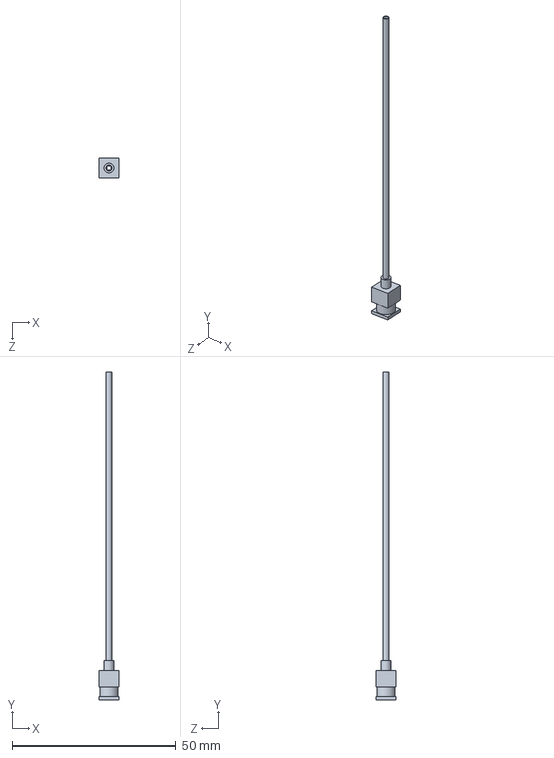
[picture p112: CAD file, 2026-10-10]
firmware/cad/GripperVer2/solderfeed10cm.SLDPRT
6.00 x 100.0 x 6.00 mm
