nht-cyb/yumi-automatic-soldering-thd/firmware/cad/Print2/print_again/motor_joint17.STL

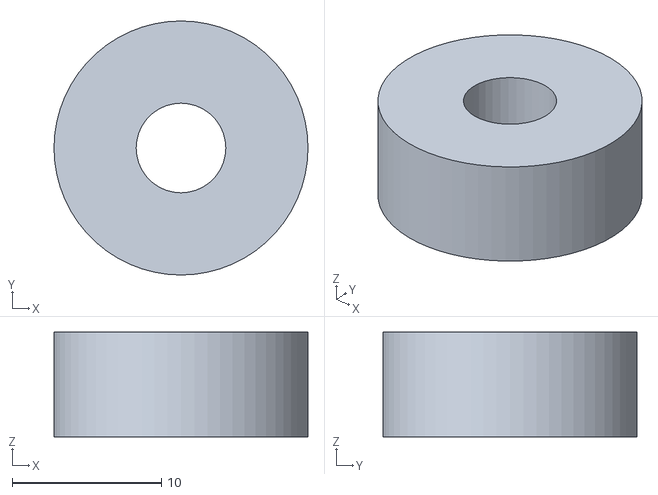
[picture p113: CAD file, 2026-10-10]
firmware/cad/Print2/print_again/motor_joint17.STL
17.0 x 17.0 x 7.00
