nht-cyb/yumi-automatic-soldering-thd/firmware/feeder_v1_esp32/SolderFeeder1/motortop.SLDPRT

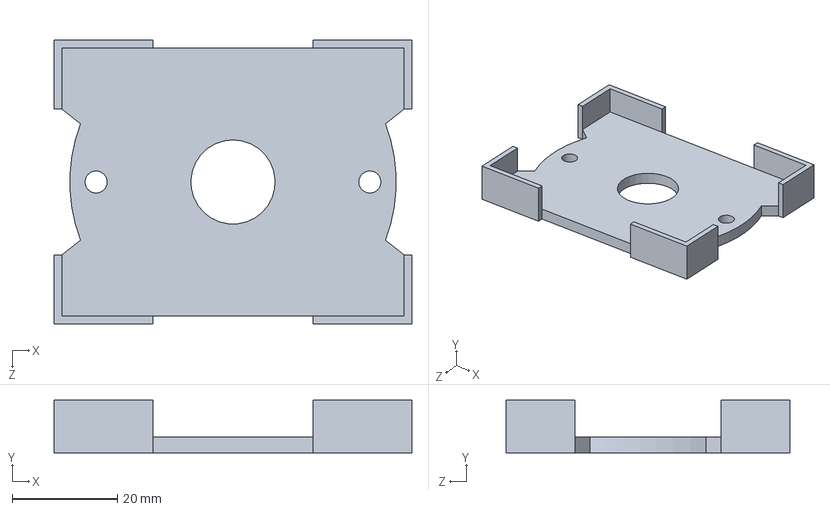
[picture p114: CAD file, 2026-10-10]
firmware/feeder_v1_esp32/SolderFeeder1/motortop.SLDPRT
68.0 x 10.0 x 54.0 mm
