nht-cyb/yumi-automatic-soldering-thd/firmware/cad/GripperVer2/Part1.SLDPRT

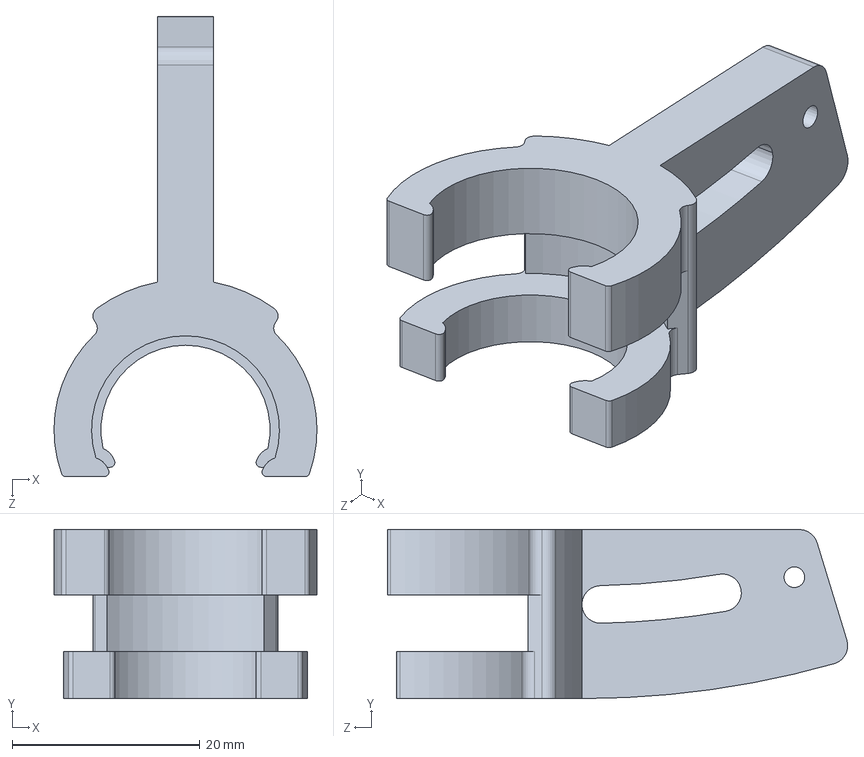
[picture p115: CAD file, 2026-10-10]
firmware/cad/GripperVer2/Part1.SLDPRT
28.0 x 18.0 x 49.0 mm
