nht-cyb/yumi-automatic-soldering-thd/firmware/cad/Print2/new_angler.STL

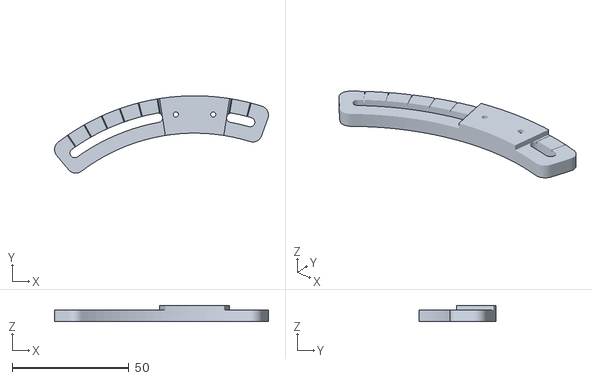
[picture p116: CAD file, 2026-10-10]
firmware/cad/Print2/new_angler.STL
91.7 x 33.1 x 7.00
