nht-cyb/yumi-automatic-soldering-thd/firmware/feeder_v1_esp32/SolderFeeder1/motor_joint.SLDPRT

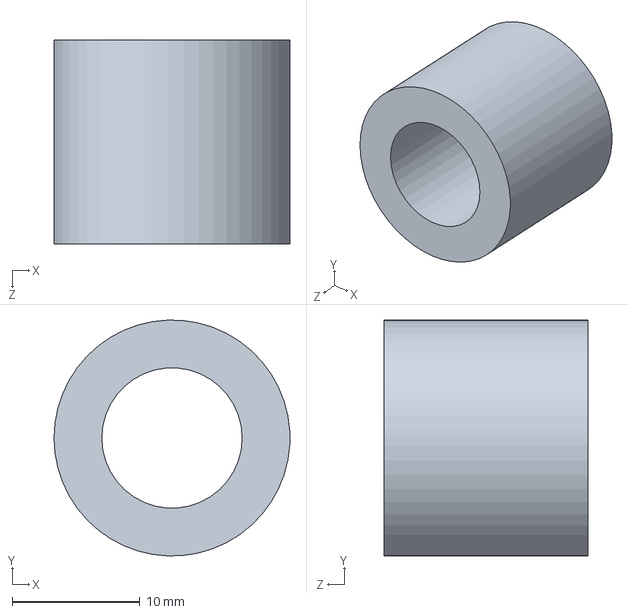
[picture p117: CAD file, 2026-10-10]
firmware/feeder_v1_esp32/SolderFeeder1/motor_joint.SLDPRT
18.5 x 18.5 x 16.0 mm
