nht-cyb/yumi-automatic-soldering-thd/firmware/cad/GripperVer2/rod_holder.SLDPRT

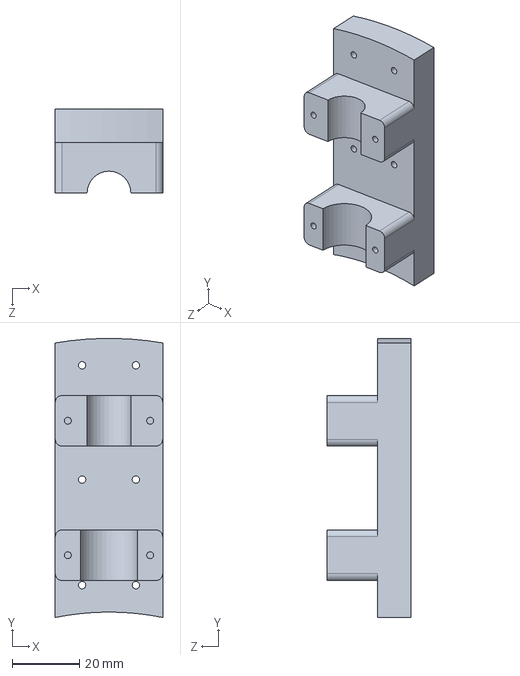
[picture p118: CAD file, 2026-10-10]
firmware/cad/GripperVer2/rod_holder.SLDPRT
32.0 x 83.0 x 25.0 mm
