nht-cyb/yumi-automatic-soldering-thd/firmware/cad/Print2/grip.SLDPRT

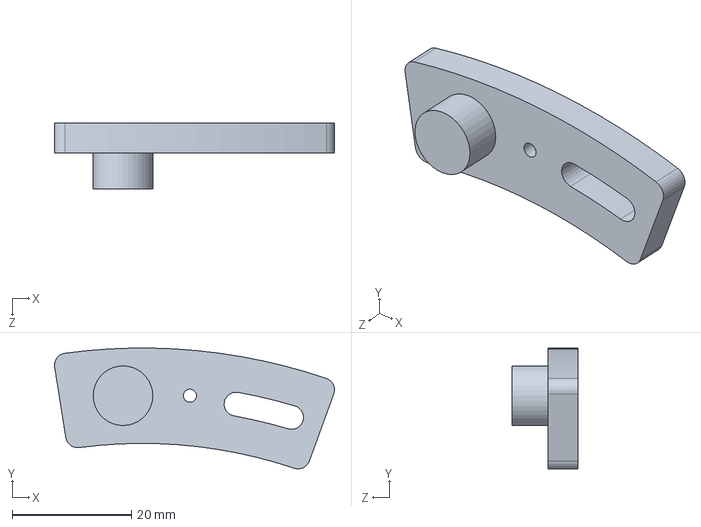
[picture p119: CAD file, 2026-10-10]
firmware/cad/Print2/grip.SLDPRT
47.0 x 20.3 x 11.0 mm
