nht-cyb/yumi-automatic-soldering-thd/firmware/feeder_v1_esp32/SolderFeeder1/zigzag.SLDPRT

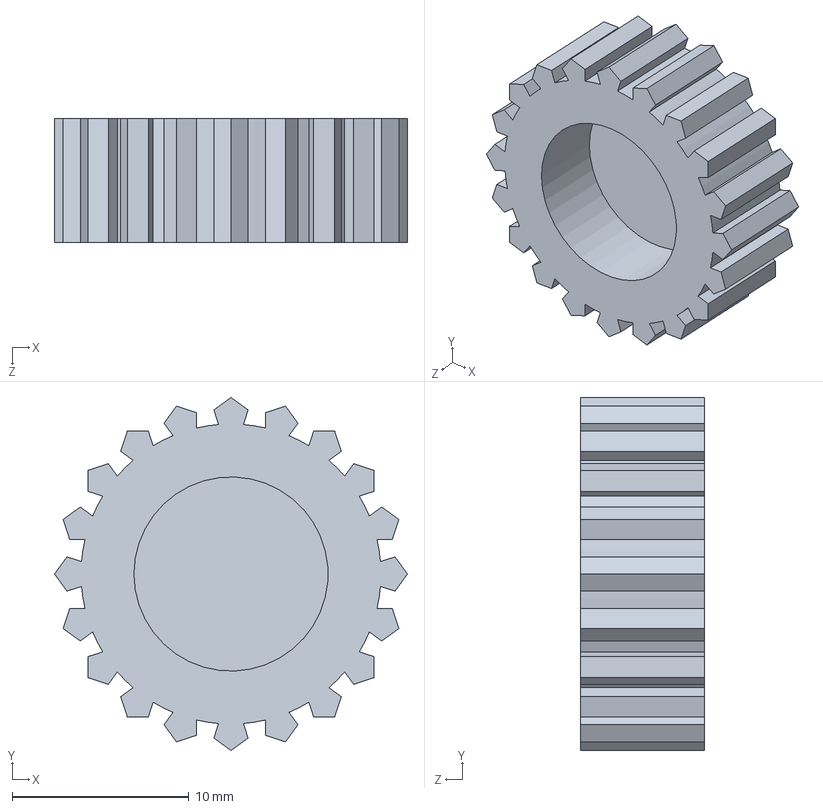
[picture p120: CAD file, 2026-10-10]
firmware/feeder_v1_esp32/SolderFeeder1/zigzag.SLDPRT
20.0 x 20.0 x 7.00 mm
