nht-cyb/yumi-automatic-soldering-thd/firmware/cad/GripperVer2/new_angler.SLDPRT

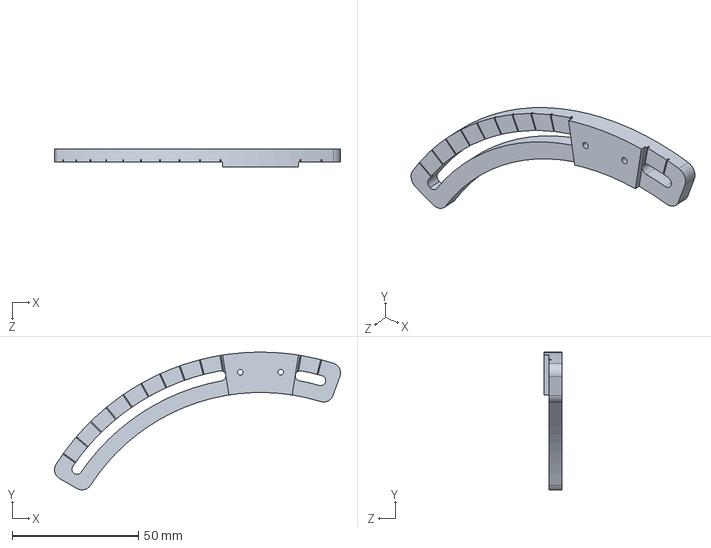
[picture p121: CAD file, 2026-10-10]
firmware/cad/GripperVer2/new_angler.SLDPRT
113.2 x 54.6 x 7.00 mm
