nht-cyb/yumi-automatic-soldering-thd/firmware/cad/Print2/connector.SLDPRT

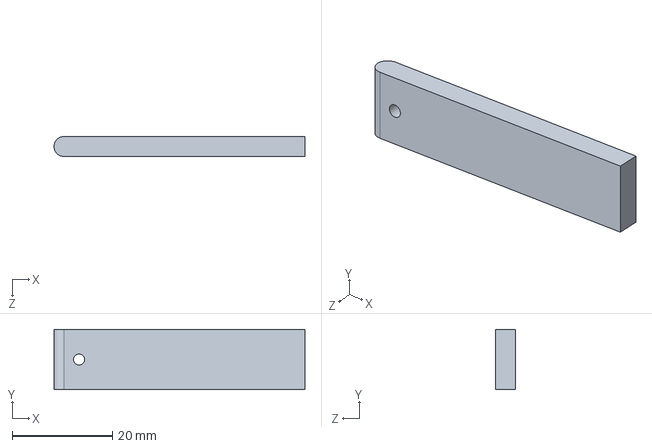
[picture p122: CAD file, 2026-10-10]
firmware/cad/Print2/connector.SLDPRT
50.0 x 12.0 x 4.00 mm
