nht-cyb/yumi-automatic-soldering-thd/firmware/cad/Print2/b_holder.STL

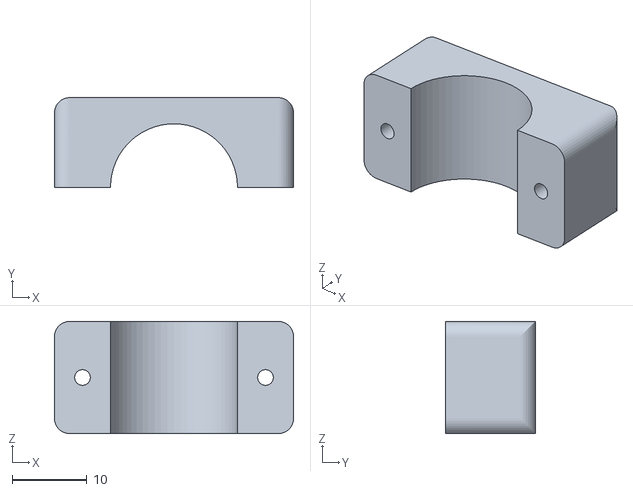
[picture p123: CAD file, 2026-10-10]
firmware/cad/Print2/b_holder.STL
32.0 x 12.0 x 15.0
