nht-cyb/yumi-automatic-soldering-thd/firmware/cad/Print2/t_holder.STL

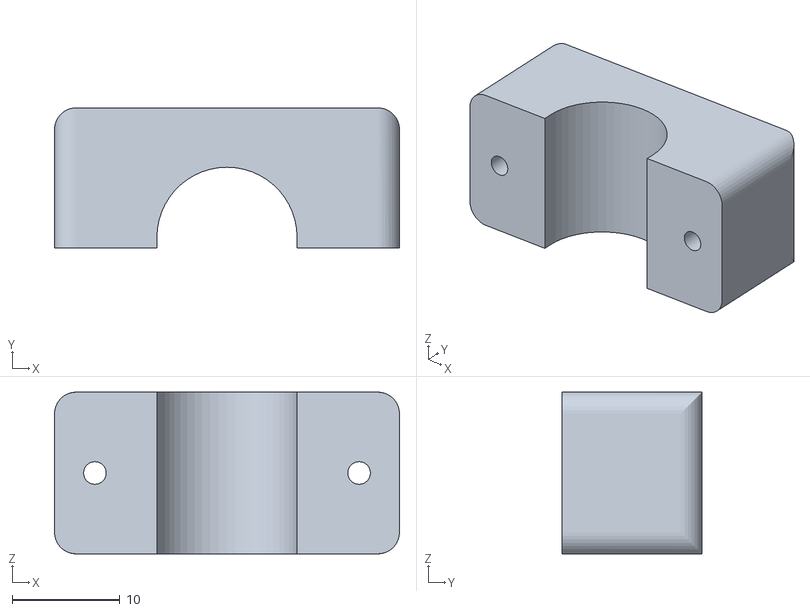
[picture p124: CAD file, 2026-10-10]
firmware/cad/Print2/t_holder.STL
32.0 x 13.0 x 15.0
