nht-cyb/yumi-automatic-soldering-thd/firmware/feeder_v1_esp32/SolderFeeder1/top.SLDPRT

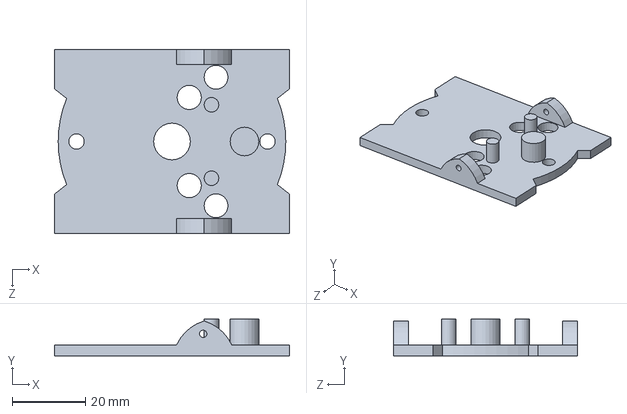
[picture p126: CAD file, 2026-10-10]
firmware/feeder_v1_esp32/SolderFeeder1/top.SLDPRT
64.0 x 10.0 x 50.0 mm
