nht-cyb/yumi-automatic-soldering-thd/firmware/cad/Print2/squarerod.SLDPRT

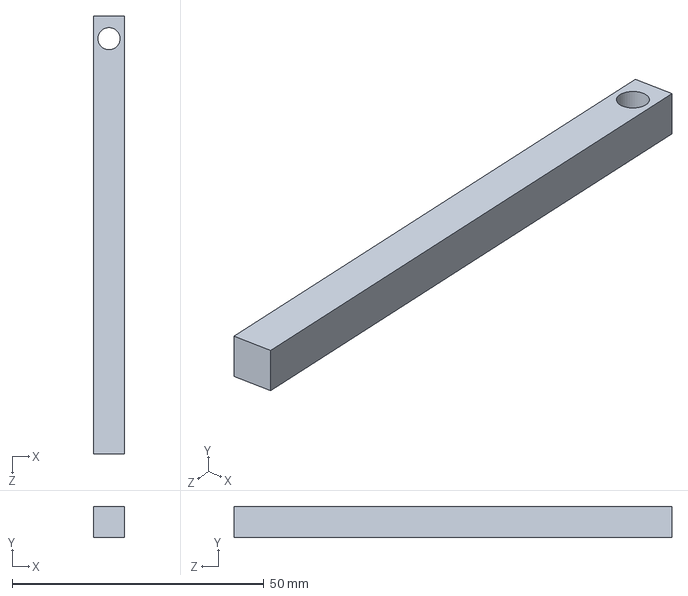
[picture p127: CAD file, 2026-10-10]
firmware/cad/Print2/squarerod.SLDPRT
6.20 x 6.20 x 87.0 mm
