nht-cyb/yumi-automatic-soldering-thd/firmware/feeder_v1_esp32/SolderFeeder1/bottom.SLDPRT

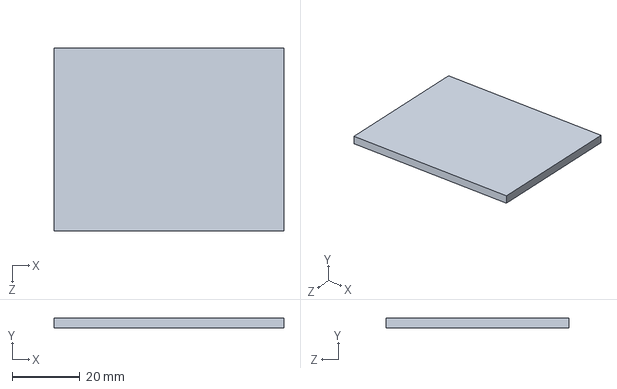
[picture p128: CAD file, 2026-10-10]
firmware/feeder_v1_esp32/SolderFeeder1/bottom.SLDPRT
68.0 x 3.00 x 54.0 mm
