nht-cyb/yumi-automatic-soldering-thd/firmware/cad/Print2/4xouterpart.SLDPRT

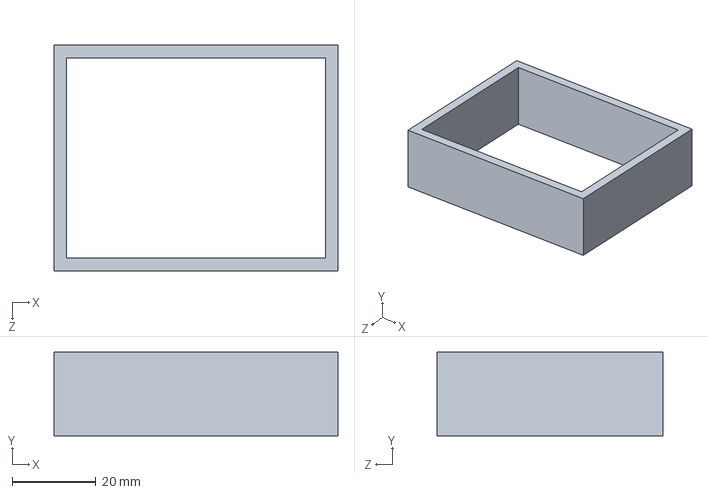
[picture p129: CAD file, 2026-10-10]
firmware/cad/Print2/4xouterpart.SLDPRT
68.0 x 20.0 x 54.0 mm
