nht-cyb/yumi-automatic-soldering-thd/firmware/cad/Print2/hole connect.SLDPRT

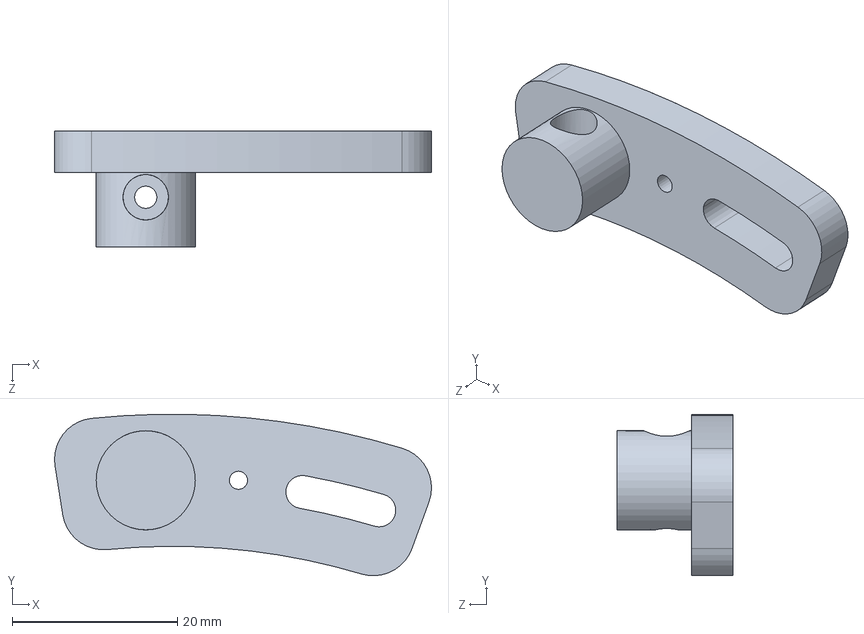
[picture p130: CAD file, 2026-10-10]
firmware/cad/Print2/hole connect.SLDPRT
45.7 x 19.5 x 14.0 mm
