nht-cyb/yumi-automatic-soldering-thd/(list of files, cad)

Other CAD files:
firmware/cad/GripperVer2/table top.SLDPRT
firmware/cad/Print2/chotcai.STL
firmware/cad/Print2/newp/motorjoint55.STL
firmware/cad/Print2/print_again/motor_joint160.STL
firmware/cad/Board Setup/2xh_slider.SLDPRT
firmware/cad/GripperVer2/part_to angler.SLDPRT
firmware/feeder_v1_esp32/SolderFeeder1/flat_surface.SLDPRT
firmware/cad/GripperVer2/t_holder.SLDPRT
firmware/cad/Print2/print_again/flat_surface_no2.STL
firmware/cad/Print2/dau_truyen.STL
firmware/cad/Print2/print_again/batt_holder.STL
firmware/cad/Print2/board_mount.STL
firmware/feeder_v1_esp32/SolderFeeder1/motor.SLDPRT
firmware/feeder_v1_esp32/SolderFeeder1/board_mount.SLDPRT
firmware/cad/Print2/part_to angler.STL
firmware/cad/Print2/yumi_to_mp.STL
firmware/feeder_v1_esp32/SolderFeeder1/batt_holder_top.SLDPRT
firmware/cad/Board Setup/pole.STL
firmware/cad/GripperVer1/angler.SLDPRT
firmware/cad/GripperVer1/b_holder.SLDPRT
firmware/cad/GripperVer1/rod_holder.SLDPRT
firmware/cad/GripperVer1/s_holder.SLDPRT
firmware/cad/GripperVer1/t_holder.SLDPRT
firmware/cad/GripperVer1/yumi_mount_1mm.SLDPRT
firmware/cad/Print2/motor.STL
firmware/cad/SLW_Hakko/Nut.SLDPRT
