nht-cyb/yumi-automatic-soldering-thd/yumi_readme/RobotStudio Tutorial Practice/Getting Started Tutorial.docx

# ROBOTSTUDIO TUTORIAL 1

## 1. Create a project.

An empty Station without including robot & virtual controller.

File > New > Project (Rename project & choose saved path) > Create.

2. Download robot model from ABB Library.

Add pre-build robot model.

Home > Add Library > (Choose robot model) > Download > OK.

3. Navigate in 3D window.

Zoom.

Rotate

Pan

View All

4. Save the project.

File > Save Project.

# ROBOTSTUDIO TUTORIAL 2

1. Open Project.
2. Create virtual controller from layout.

Home > Virtual Controller > From Layout… > (rename controller, controller option) > Finish.

Controller Status: (Popup panel in corner & green light) > Done.

3. Jog the robot.

In Home > Freehand panel,

Jog Joint: Pick which joint to move and drag them.

Move and Rotate: Drag

In Modify > Motion panel,

Mechanism Joint Jog: change value of each joint’s angles to move robot to desired pose.

Mechanism Linear Jog: insert position (x,y,z) of endpoint value to create pose. Choose move to pose or jump to pose after to reposit to robot.

4. Save the project.

File > Save Project.

# ROBOTSTUDIO TUTORIAL 3

1. Open Project.
2. Import tool and attach.

Import from library.

Home > Import Library > (choose EF)

> (attach tool 1) *drag MyTool to robot model in layout panel > Update Position.

or > (attach tool 2 *right click in MyTool in layout panel > Attach to > (choose which part of robot is the EF to attach tool)

3. Create an empty path.

Open Paths & Targets panel, choose robot model > Paths & Procedures > Create Path.

4. Set instruction template.

Typical procedure: MoveL v1000 z100 MyTool

<command> <velocity mm/s> <zone data: how accurately of the ef movement><tool><EF>

Need to learn more command for my project.

5. Teach instructions.

Home > Teach Instruction > (open teach mode, click ok to start operation with default EF) > *drag robot to desired pose > Teach Instruction *again* to add pose and position to path

- Each stop was added into the path file.
6. Move along path.

Home > Paths & Procedures > click in Robot’s Path > edit movement to complete a cycle > *right click on path file* Move along path (to play stimulation).

7. Save project.

File > Save Project.

# ROBOTSTUDIO TUTORIAL 4

1. Open Project.
2. Delete Path and Targets.

Right Click on Path file and target points of work object to delete.

4. Import Library.
5. Show Work Envelope.
6. Position Library.

Import work station and check if they’re in robot workspace or not, drag the station to desired point if they are out of reach.

7. Create Workobject.

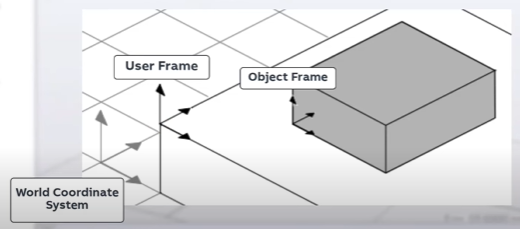
[picture p131: figure]

Set coordinate system of work object: Home > Path Programming > Other > Create Workobject > edit Frame by points > choose select frame and quick snap to point and select edges of table or smt to choose object frame.

Surface selection and point snap to choose edge of object, these points will be saved in target list.

8. Create Targets.

Home > Path Programming > Target > Create Target > choose select frame and quick snap to point and select edges > click ok to create point.

Copy/Apply orientation: view orientation to see tool pose.

Select Target > right click to Modify target > Set tool to position or line along axis xyz

Select Target > right click to Apply Position and Orientation > Orientation.

9. Create a path.

Select all Targets > Add to new path > Modify instructions

10. Auto configuration

Select path file > right click > Auto configuration > Circular/Linear Instruction > All move instructions > Add Home point to complete path.

11. Move along path. To run stimulation.
12. Save project.

File > Save Project.

# ROBOTSTUDIO TUTORIAL 5

1. Open Project.
2. Synchronize to RAPID.

Home > Controller > Synchronize to RAPID. (transfer all targets and paths to RAPID code)

Right click to select which catalogue to transfer.

3. Visualize module in RAPID.

RAPID > Rapid > Robot Model > Project name > main > edit main() to run a procedure > Program Pointer > Set Program pointer to main in the line you want to run, normally the first line in main() function.

Split the viewing window to see code and simulation at the same time> Vertical Group > RAPID > Start to run simulation/visualize for Rapid code.

4. Set simulation entry point.

Right click path file > Set as Simulation entry point.

5. Play simulation.

Simulation > Play.

6. Create Main Path.
7. Save Project.

File > Save Project.
