nht-cyb/yumi-automatic-soldering-thd/firmware/feeder_v1_esp32/SolderFeeder1/imgfd1/Assem1-motor-1.JPG

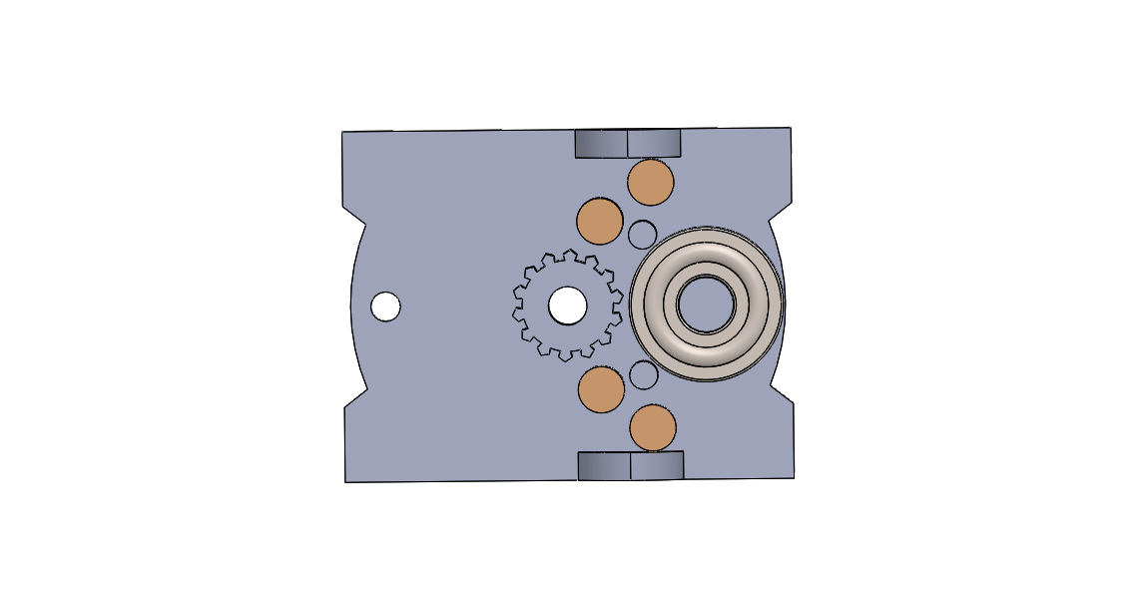
firmware/feeder_v1_esp32/SolderFeeder1/imgfd1/Assem1-motor-1.JPG
