nht-cyb/yumi-automatic-soldering-thd/firmware/feeder_v1_esp32/SolderFeeder1/imgfd1/motorholder.JPG

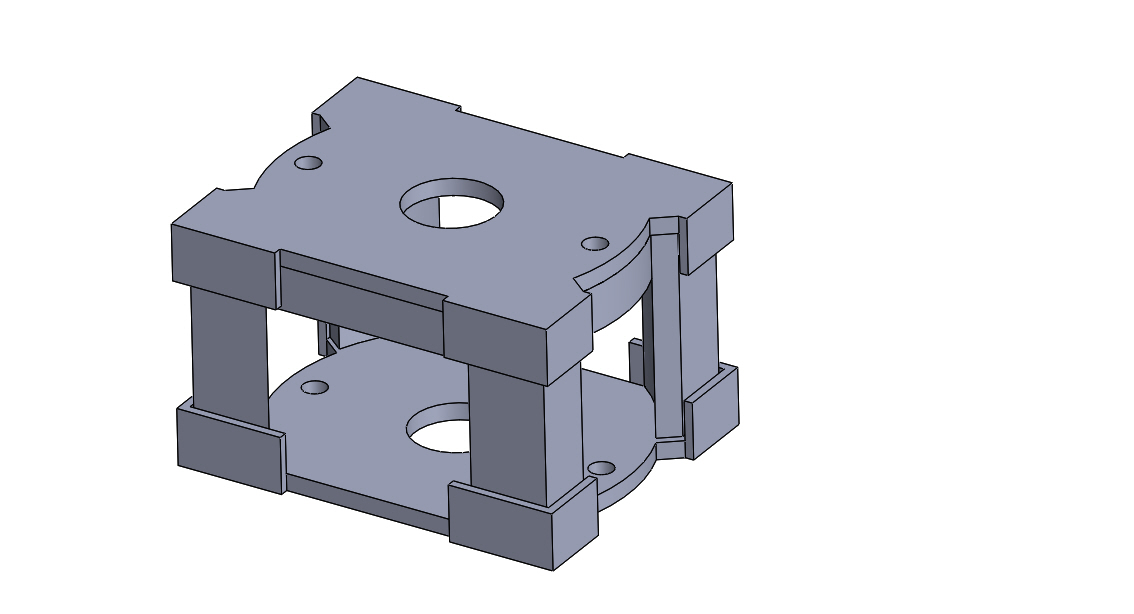
firmware/feeder_v1_esp32/SolderFeeder1/imgfd1/motorholder.JPG
