nht-cyb/yumi-automatic-soldering-thd/firmware/feeder_v1_esp32/SolderFeeder1/imgfd1/solderAssem1-d.JPG

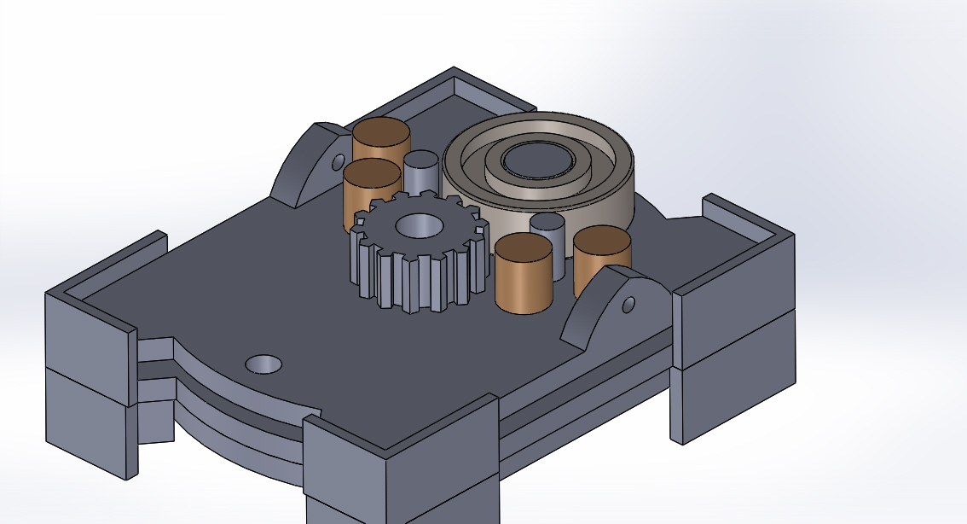
firmware/feeder_v1_esp32/SolderFeeder1/imgfd1/solderAssem1-d.JPG
