nht-cyb/yumi-automatic-soldering-thd/firmware/feeder_v1_esp32/SolderFeederSchematicV2/Solder Feeder Schematic V2_1.jpg

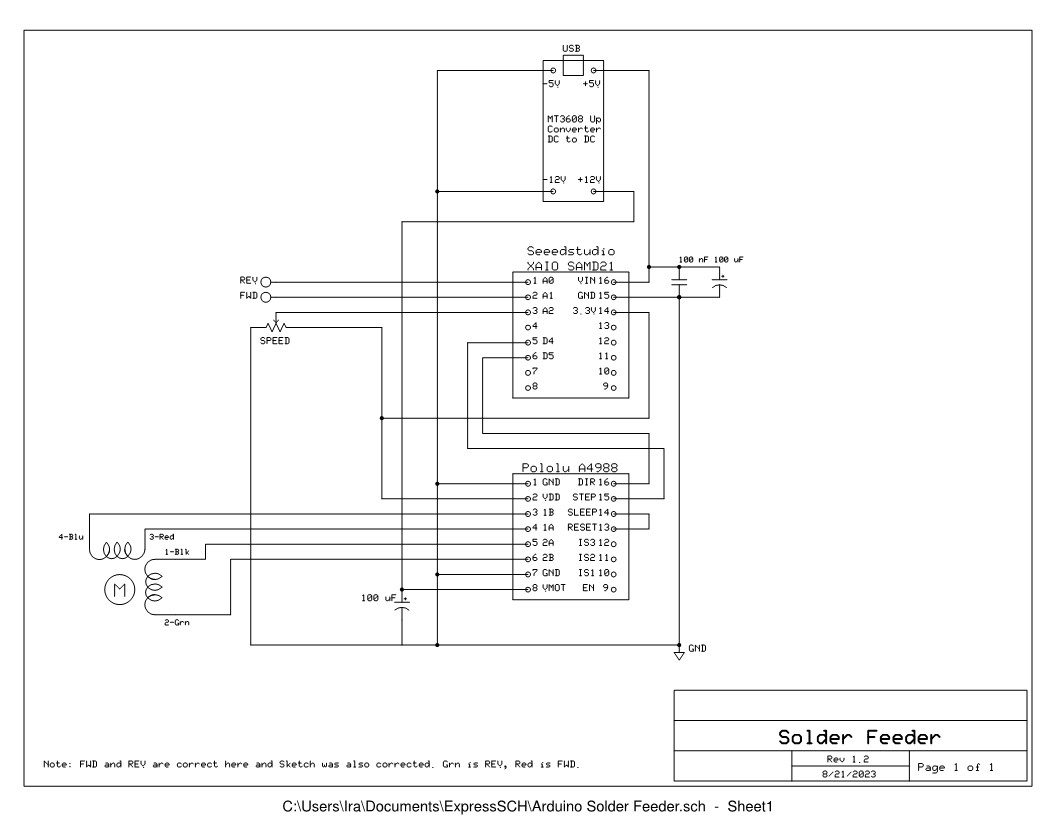
firmware/feeder_v1_esp32/SolderFeederSchematicV2/Solder Feeder Schematic V2_1.jpg
