nht-cyb/yumi-automatic-soldering-thd/results_img/Soldering Results/4.4.2/4.jpg

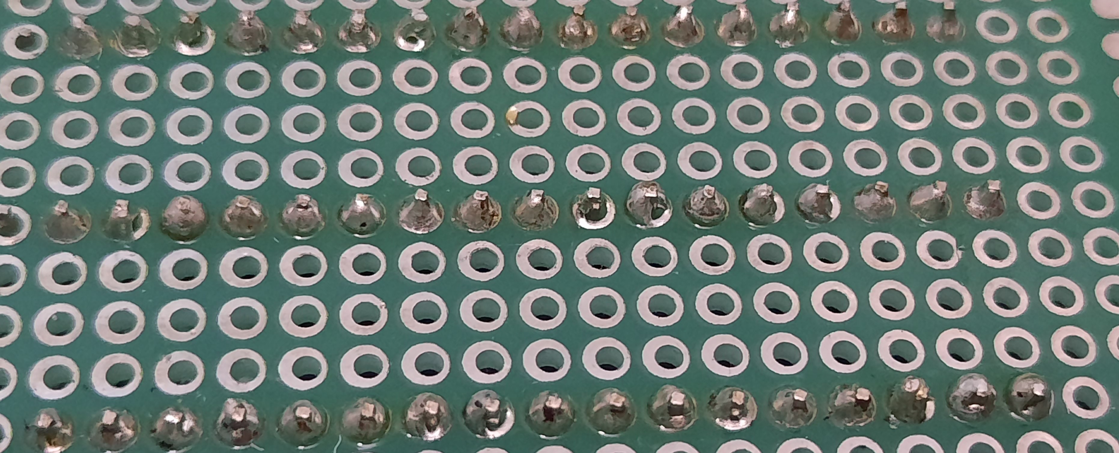
results_img/Soldering Results/4.4.2/4.jpg
