nht-cyb/yumi-automatic-soldering-thd/results_img/Soldering Results/4.4.2/20241209_093759.jpg

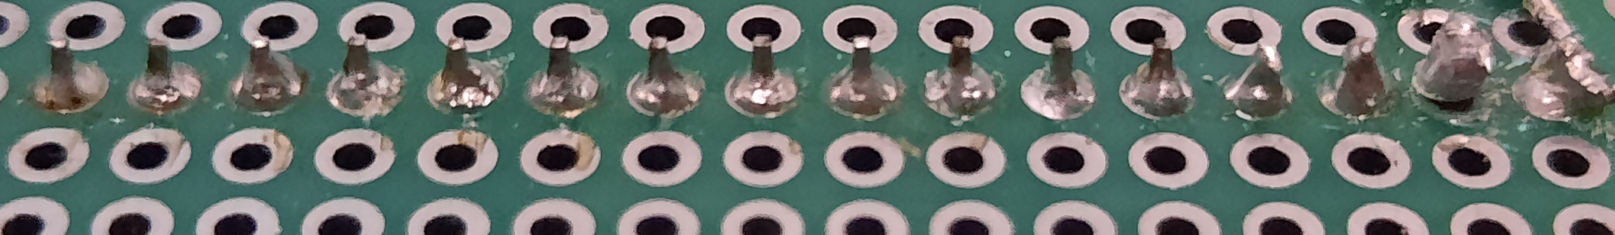
results_img/Soldering Results/4.4.2/20241209_093759.jpg
