nht-cyb/yumi-automatic-soldering-thd/results_img/Soldering Results/4.4.3/10.jpg

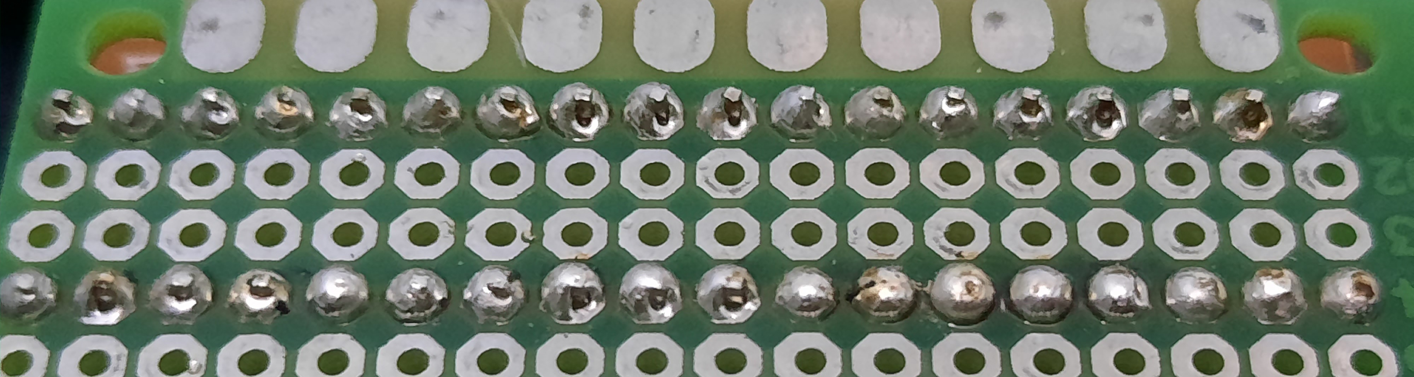
results_img/Soldering Results/4.4.3/10.jpg
