nht-cyb/yumi-automatic-soldering-thd/results_img/Soldering Results/4.4.4/20241209_094547.jpg

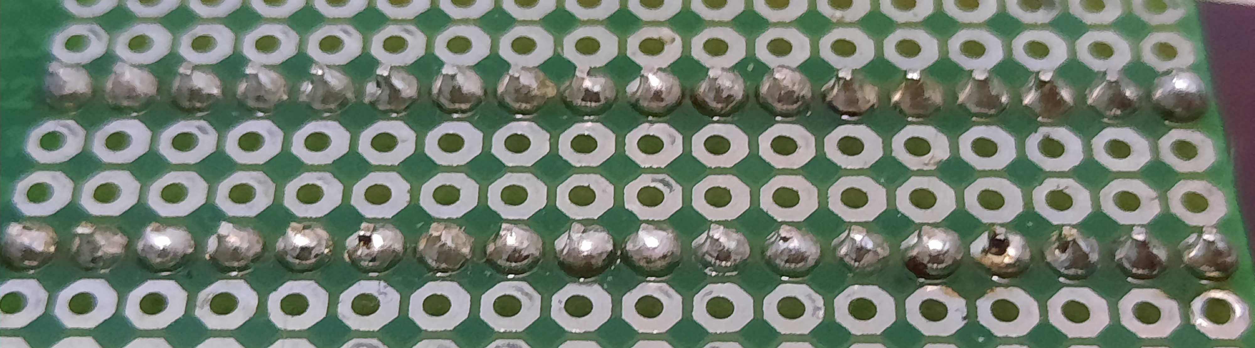
results_img/Soldering Results/4.4.4/20241209_094547.jpg
