nht-cyb/yumi-automatic-soldering-thd/results_img/Soldering Results/4.4.5/20241209_095434.jpg

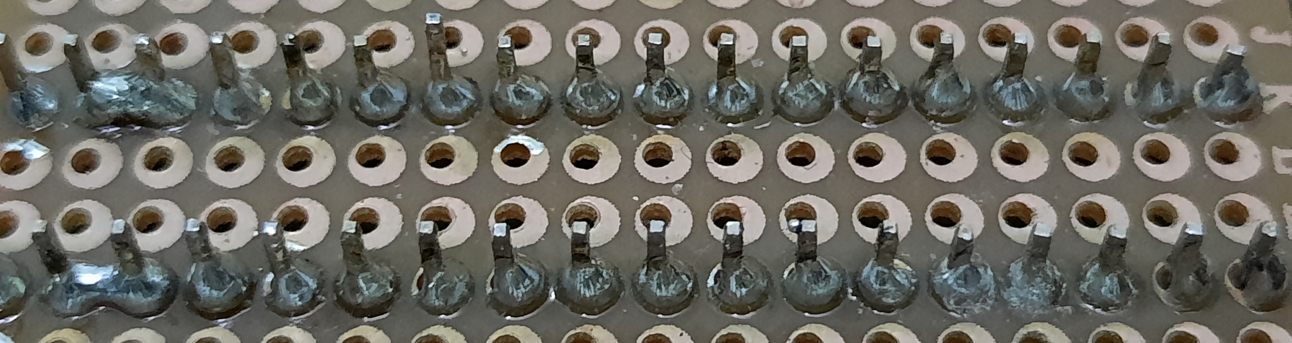
results_img/Soldering Results/4.4.5/20241209_095434.jpg
