nht-cyb/yumi-automatic-soldering-thd/results_img/Soldering Results/4.4.5/20241209_095539.jpg

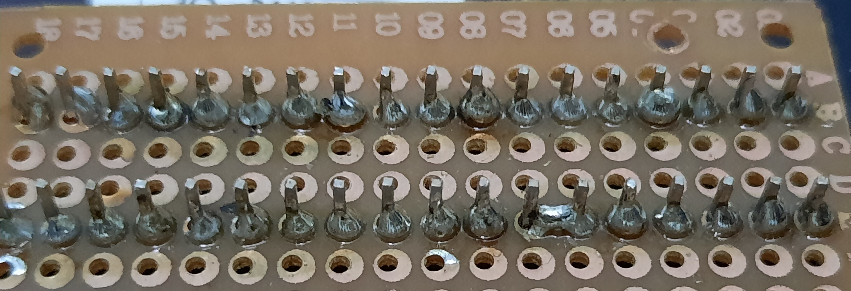
results_img/Soldering Results/4.4.5/20241209_095539.jpg
