nht-cyb/yumi-automatic-soldering-thd/aco/ACO_Matlab/results/r5.pdf

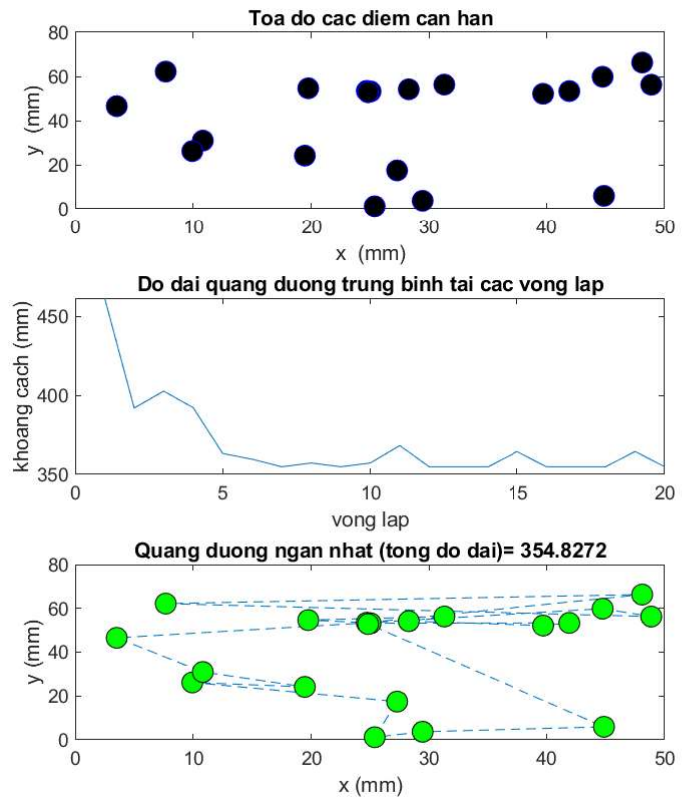
[picture p158: figure]
