nht-cyb/yumi-automatic-soldering-thd/results_img/graph.xlsx

Thời gian truyền thiếc | Thừa thiếc | Thiếu thiếc | Cách điểm | Kéo thiếc | Ngắn mạch | Cháy mạch | Tổng số lỗi
1.7s | 27 | 0 | 0 | 0 | 1 | 0 | 29
1.3s | 13 | 7 | 1 | 0 | 0 | 0 | 21
0.7s | 0 | 18 | 0 | 1 | 0 | 0 | 19
0.6s | 10 | 5 | 3 | 1 | 1 | 3 | 23
Nhiệt độ | Lỗi thừa thiếc | Lỗi thiếu thiếc | Cách điểm | Kéo chóp nhọn | Cháy mạch | Tỉ lệ lỗi
285°C | 3 | 12 | 1 | 0 | 2 | 0.221
300°C | 2 | 8 | 1 | 0 | 0 | 0.107
320°C | 9 | 10 | 1 | 0 | 0 | 0.235
350°C | 2 | 4 | 0 | 0 | 0 | 0.071
385°C | 1 | 8 | 1 | 3 | 3 | 0.186
385°C | 4 | 16 | 3 | 1 | 4 | 0.314
Hình | Phương pháp | Khoảng cách giữa hai điểm liên tiếp |  |  |  | Tần suất vị trí sai
 |  | △x | △y | △z | ɛ(x) | y | z | TB
4.3 | Thủ công | 1.2346 | 0.27127 | -0.0212 | 1.30542 | 0.4091 | 0.7614 | 0.5852
4.1 | Xấp xỉ | 1.9523 | -0.0689 | -0.1047 | 0.58779 | 0.2273 | 0.2803 | 0.2538
4.2 | Xấp xỉ chọn lọc | 2.518 | -0.0046 | 0.00651 | 0.02154 | 0.1288 | 0.0757 | 0.1023
