nht-cyb/yumi-automatic-soldering-thd/ACO-results/results6/data4.png

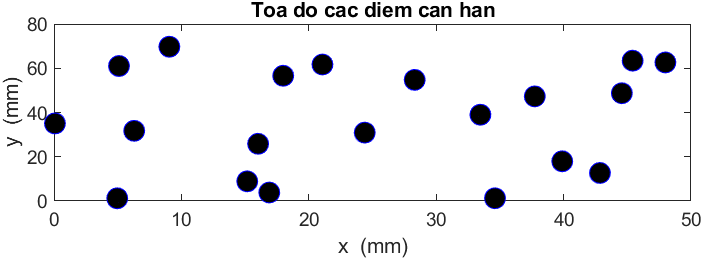
ACO-results/results6/data4.png
