nht-cyb/yumi-automatic-soldering-thd/ACO-results/results6/data4_path.png

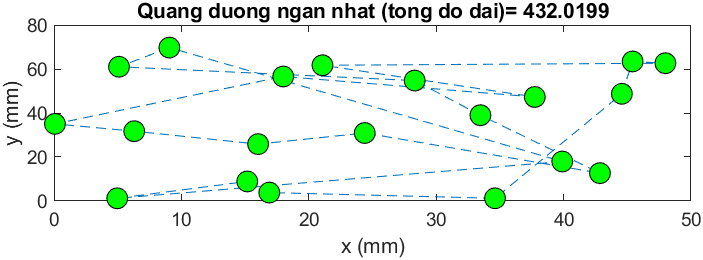
ACO-results/results6/data4_path.png
