nht-cyb/yumi-automatic-soldering-thd/ACO-results/results6/data6.png

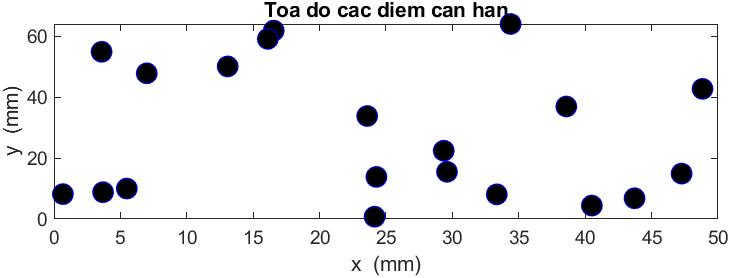
ACO-results/results6/data6.png
