nht-cyb/yumi-automatic-soldering-thd/ACO-results/results6/data6_dis_iter.png

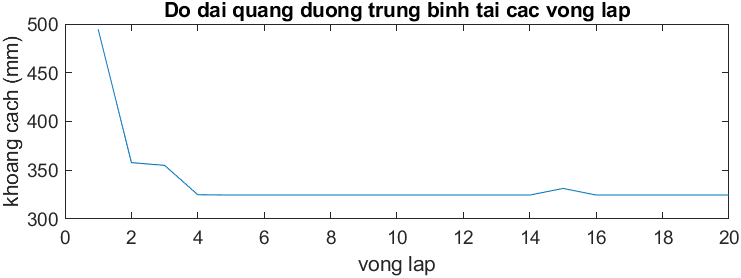
ACO-results/results6/data6_dis_iter.png
