nht-cyb/yumi-automatic-soldering-thd/ACO-results/results6/results2-inter.png

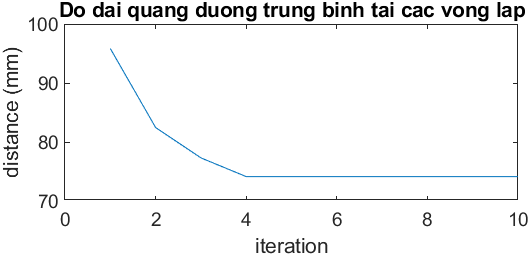
ACO-results/results6/results2-inter.png
