nht-cyb/yumi-automatic-soldering-thd/ACO-results/results6/results2.png

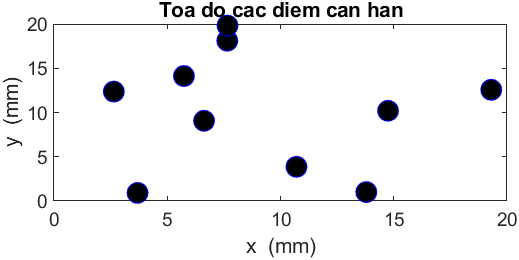
ACO-results/results6/results2.png
