nht-cyb/yumi-automatic-soldering-thd/ACO-results/results6/untitled2.png

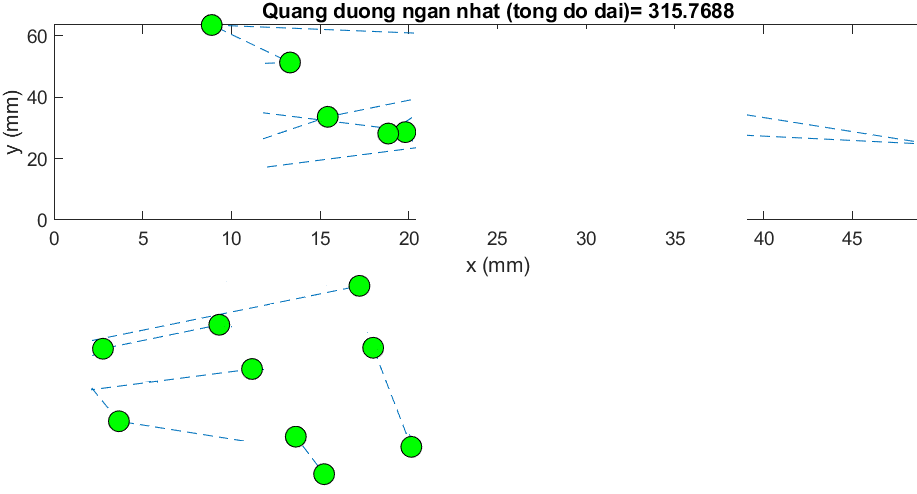
ACO-results/results6/untitled2.png
