nht-cyb/yumi-automatic-soldering-thd/aco/ACO_Matlab/results/untitled1_ctu.png

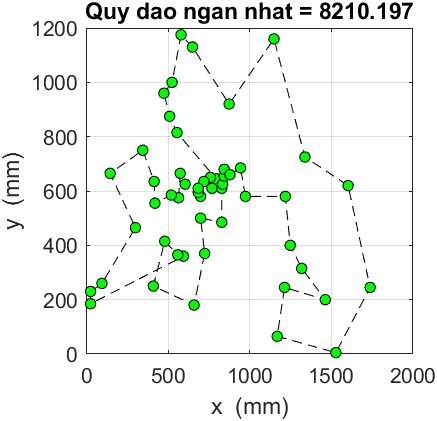
aco/ACO_Matlab/results/untitled1_ctu.png
