nht-cyb/yumi-automatic-soldering-thd/aco/ACO_Matlab/results/untitled13_ctu.png

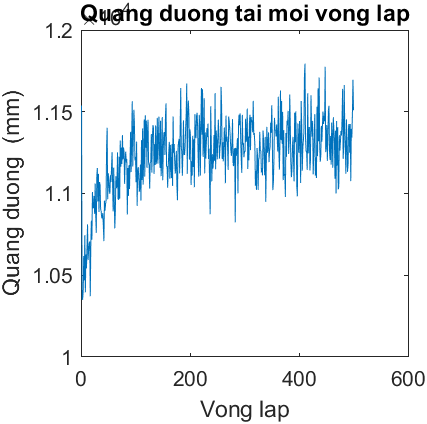
aco/ACO_Matlab/results/untitled13_ctu.png
