nht-cyb/yumi-automatic-soldering-thd/aco/ACO_Matlab/results/untitled21_tu.png

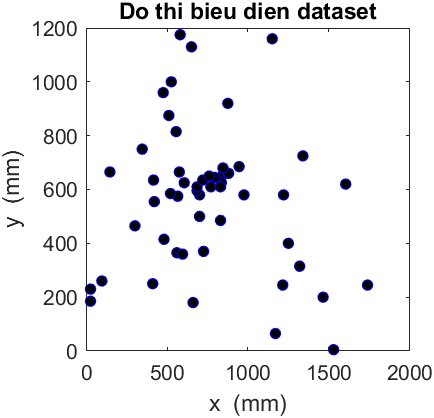
aco/ACO_Matlab/results/untitled21_tu.png
