nht-cyb/yumi-automatic-soldering-thd/results_img/Picture2.png

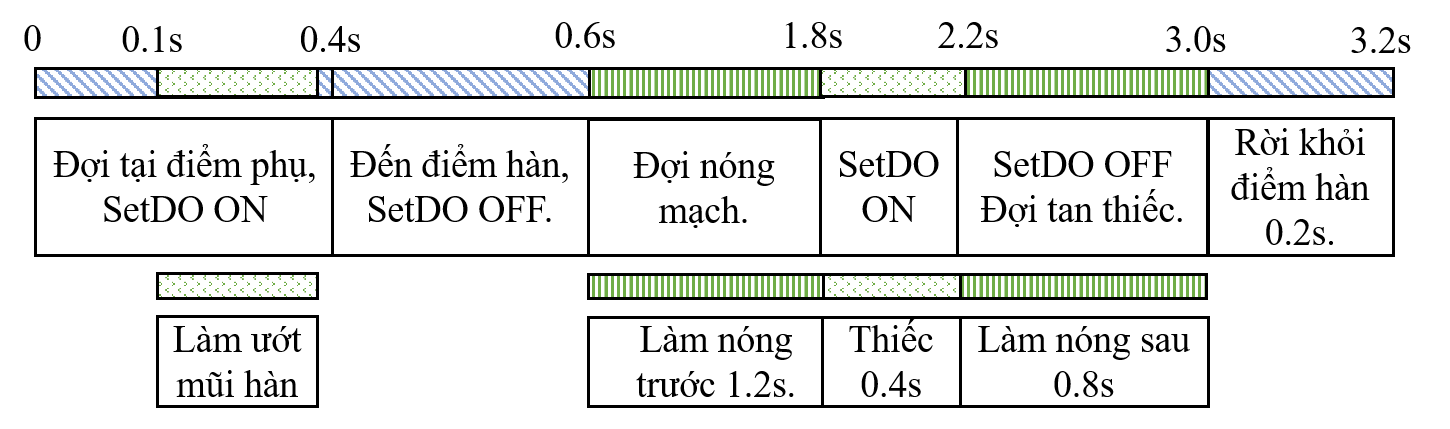
results_img/Picture2.png
