nht-cyb/yumi-automatic-soldering-thd/results_img/Picture3.png

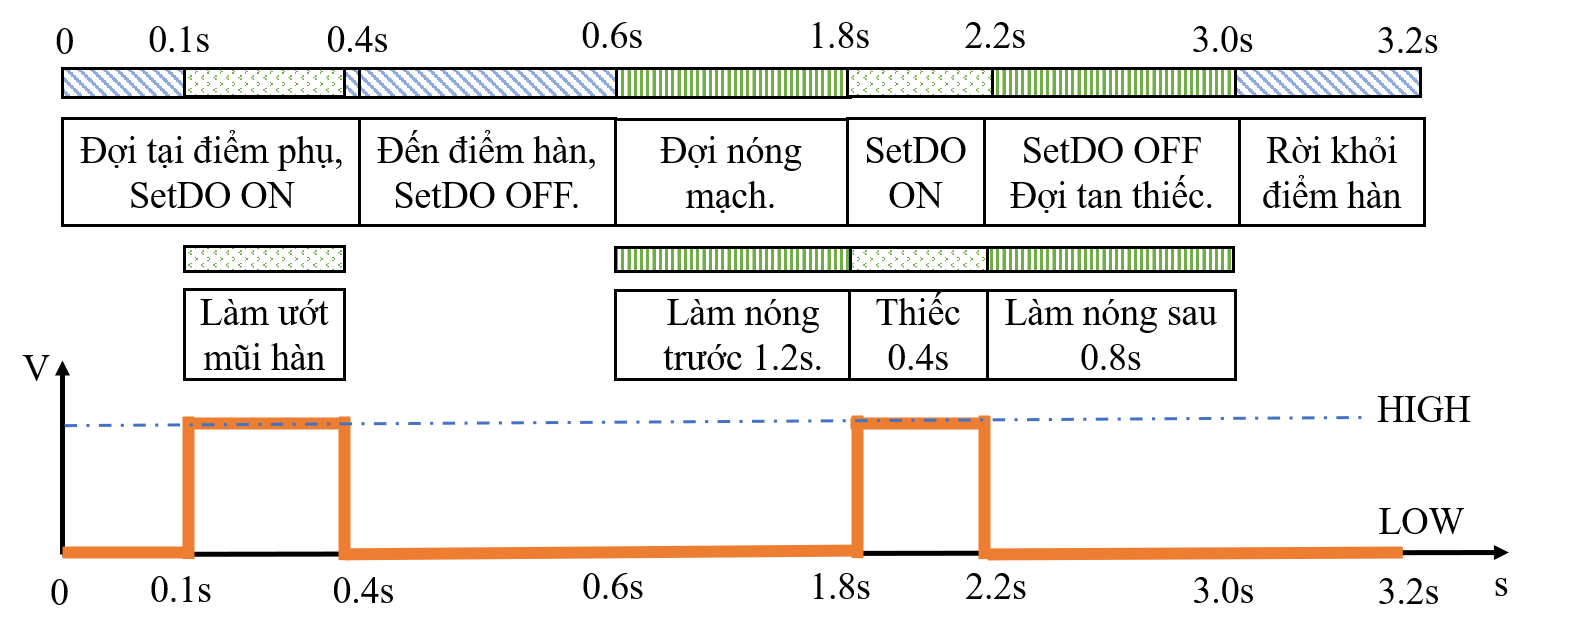
results_img/Picture3.png
