nht-cyb/yumi-automatic-soldering-thd/results_img/Picture11.png

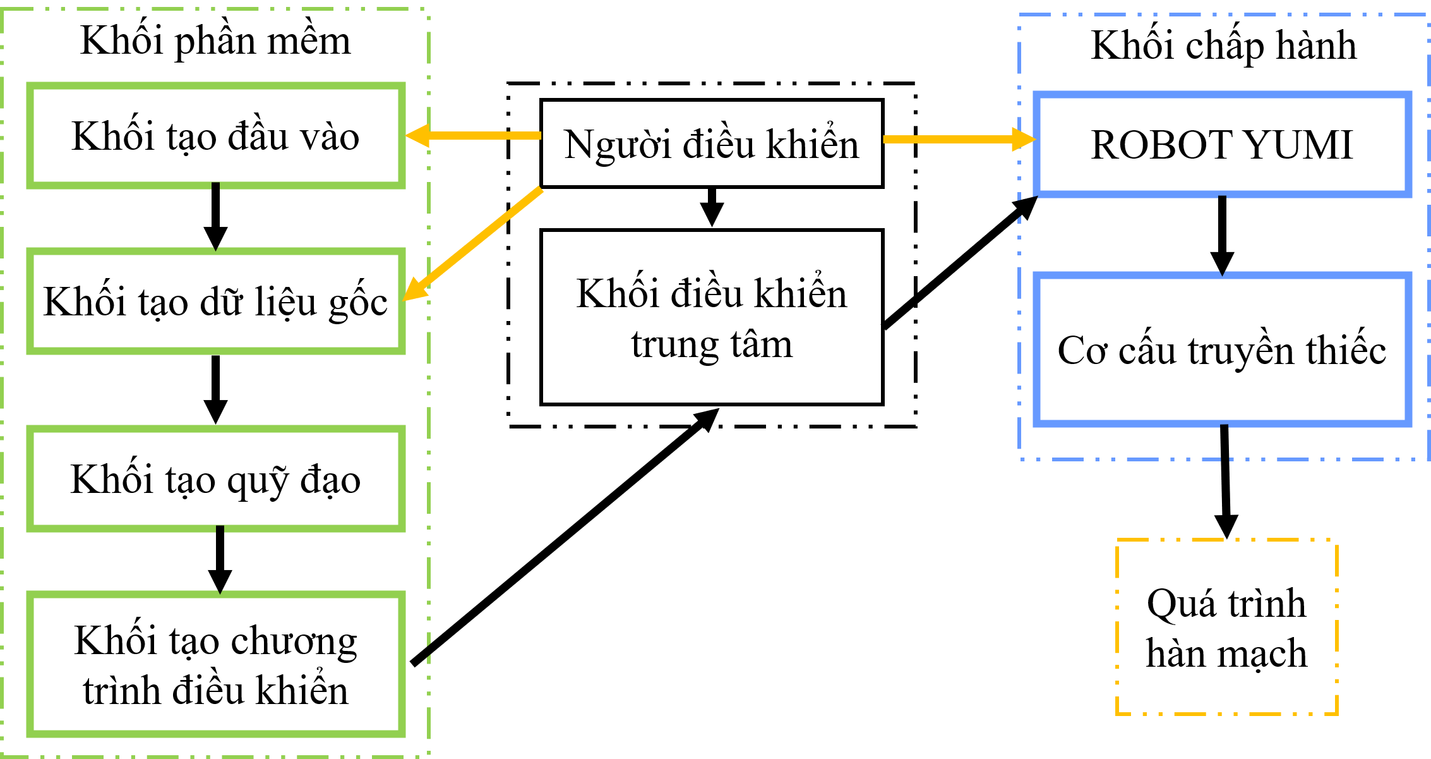
results_img/Picture11.png
