nht-cyb/yumi-automatic-soldering-thd/results_img/Picture111.png

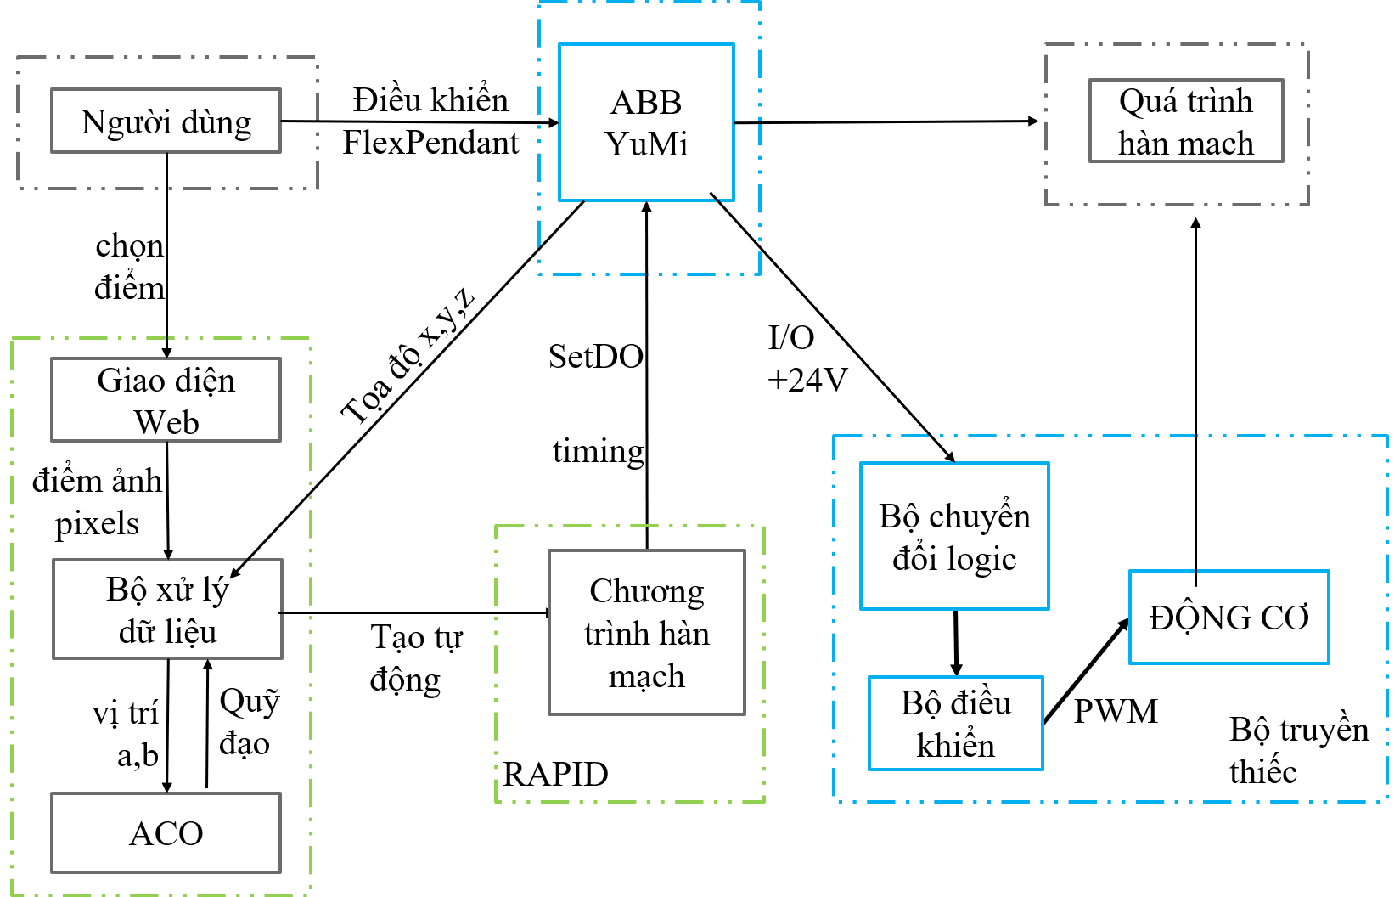
results_img/Picture111.png
