nht-cyb/yumi-automatic-soldering-thd/results_img/soldering_results/test1.jpg

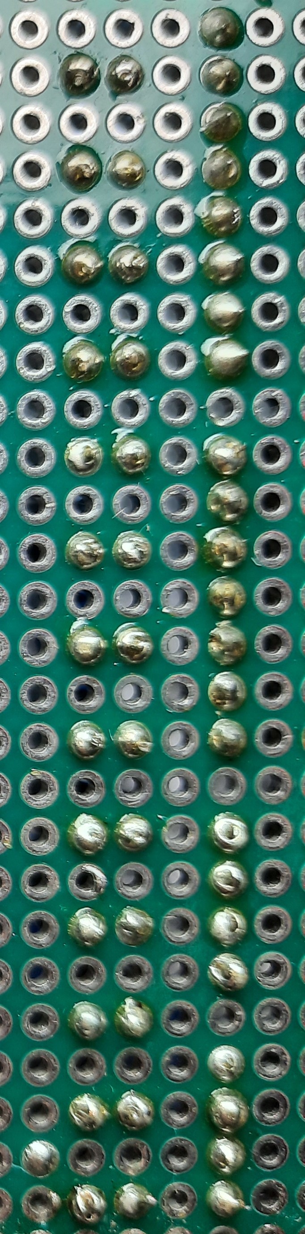
results_img/soldering_results/test1.jpg
