nht-cyb/yumi-automatic-soldering-thd/results_img/soldering_results/test.jpg

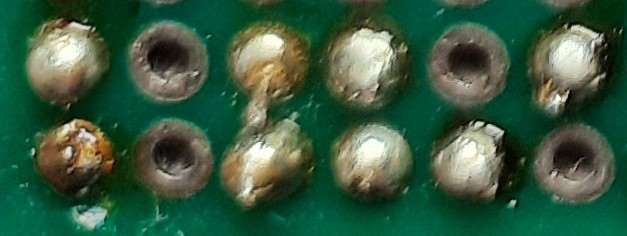
results_img/soldering_results/test.jpg
