nht-cyb/yumi-automatic-soldering-thd/results_img/Test results-20241209T041015Z-001/Test results/20241209_094249.jpg

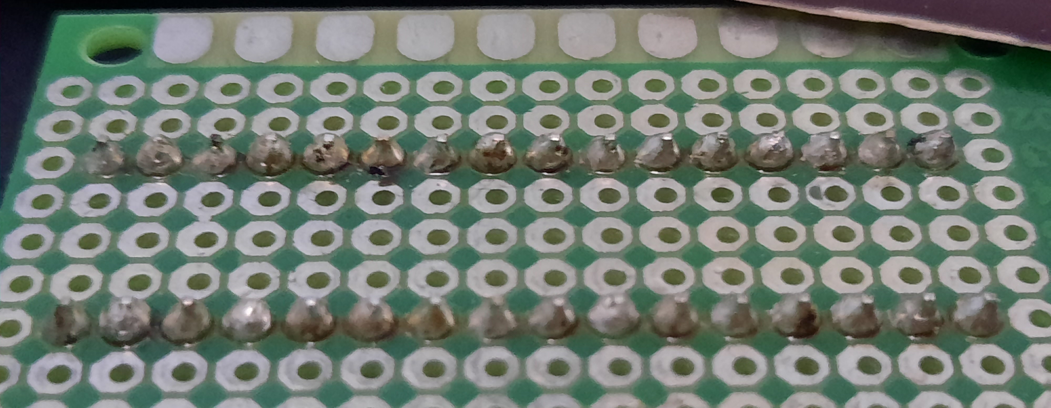
results_img/Test results-20241209T041015Z-001/Test results/20241209_094249.jpg
