nht-cyb/yumi-automatic-soldering-thd/firmware/feeder_v2_mega/schematic3/Solder Feeder Schematic V2.pdf

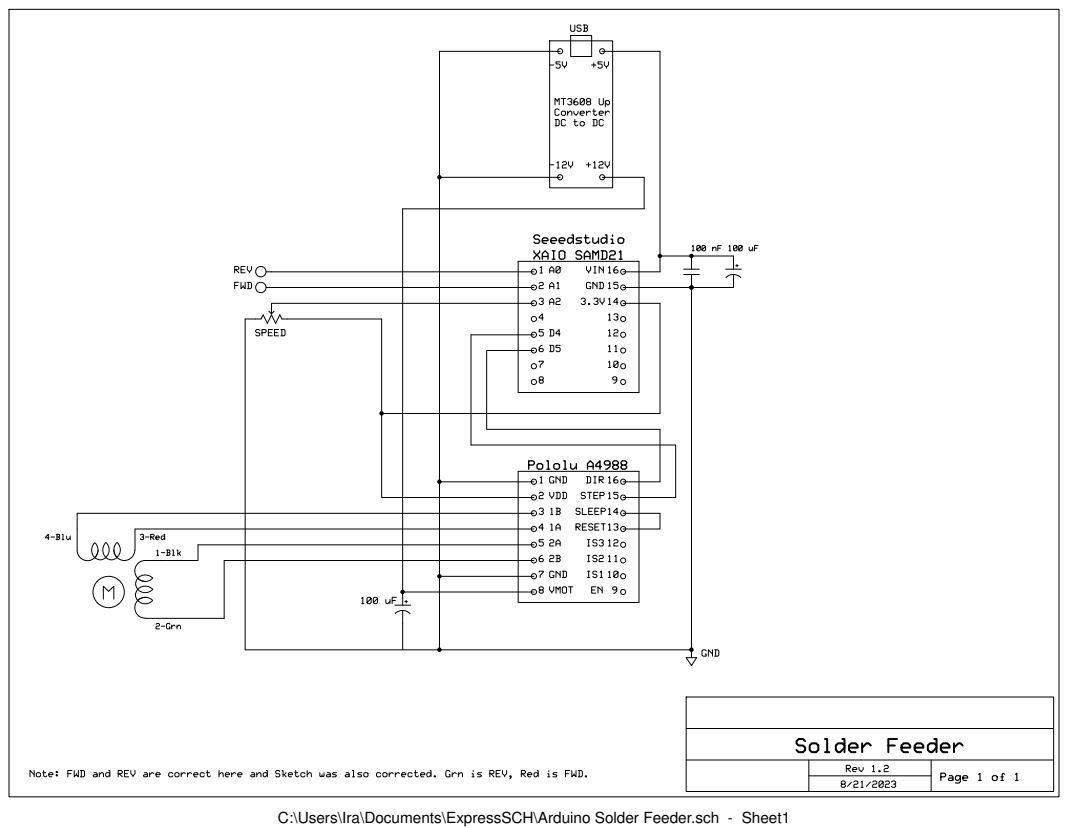
[picture p212: page 1]

C:\Users\Ira\Documents\ExpressSCH\Arduino Solder Feeder.sch - Sheet1
