nht-cyb/yumi-automatic-soldering-thd/reports/FINAL SLIDE.pdf

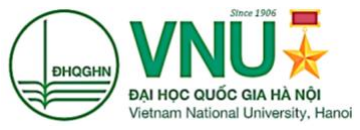
[picture p213: figure]

ĐẠI HỌC QUỐC GIA HÀ NỘI
TRƯỜNG ĐẠI HỌC CÔNG NGHỆ
VNU – Univeristy of Engineering and Technology | MEMS and Microsystems Department

# Nghiên cứu phát triển bài toán hàn linh kiện chân cắm trên mạch in cho robot cộng tác YuMi

### Sinh viên thực hiện: Nguyễn Huyền Trang

### Cán bộ hướng dẫn: PGS. TS. Bùi Thanh Tùng ThS. Trần Như Chí

HÀ NỘI - 2024

#1

Sơ đồ khối hệ thống tổng quát và thiết kế cơ cấu chấp hành.

Khái quát về bối cảnh và lý do chọn đề tài.

Kết quả chế tạo và thực nghiệm. Đánh giá chất lượng của mối hàn.

Tổng kết các kết quả đạt được và hướng phát triển trong tương lai.

# THIẾT KẾ HỆ THỐNG

# THỰC NGHIỆM VÀ KẾT QUẢ

# KẾT LUẬN HƯỚNG PHÁT TRIỂN

#4

#2

#5

# TỔNG QUAN

Hệ thống phần mềm và xây dựng các thuật toán bổ trợ.

# THUẬT TOÁN

#3

Bối cảnh và lý do chọn đề tài.

#01

# TỔNG QUAN

# TỔNG QUAN

01

- Sự bùng nổ của ngành công nghiệp bán dẫn.
- Sản xuất hàng loạt nhưng thiếu sự linh hoạt, hệ thống hàn phức tạp.
- Phương pháp hàn linh kiện cắm thường thực hiện thủ công, độc hại.
- Phù hợp với các ứng dụng với yêu cầu độ tỉ mỉ, độ tùy chỉnh cao.
- Giảm thiểu lao động con người trong quá trình hàn, tránh tiếp xúc với kim loại nặng, hóa chất chất độc hại trong quá trình làm việc.

### Bối cảnh:

### Đề xuất:

01

### Collaborative Robot – Cobot

- Được thiết kế để làm việc chung với con người.
- Tránh sự cố như robot di chuyển va chạm gây tai nạn.
- Có hệ thống cảm biến lực dừng thao tác lại.

### YuMi ABB: 7-DOFs

- Tính năng hướng dẫn trực quan, dễ sử dụng, lập trình.
- Linh hoạt, kết hợp với nhiều cấu hình, nhanh nhẹn, nhỏ gọn.
- Đáp ứng nhu cầu sản xuất theo yêu cầu của các quy trình lắp ráp các thiết bị nhỏ như: điện - điện tử...

# ABB YUMI

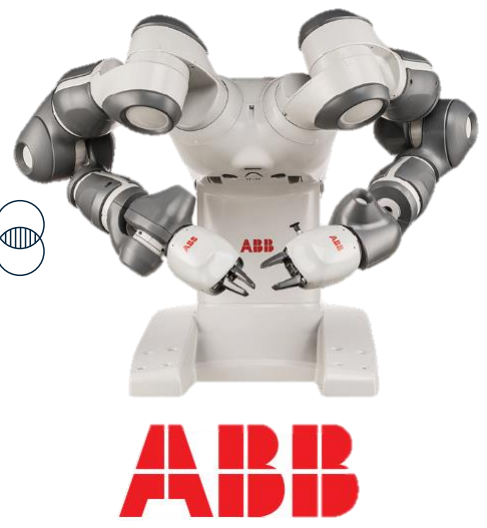
[picture p214: figure]

Hình 1. Robot ABB YuMi.

Xây dựng hệ thống tổng quát.

#02

# THIẾT KẾ HỆ THỐNG

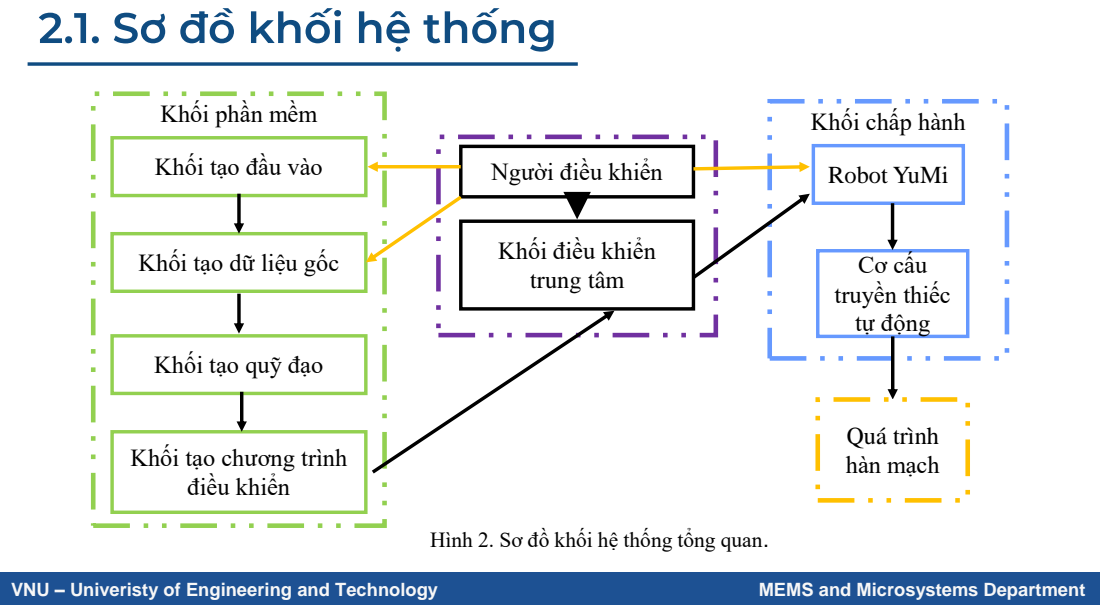
[picture p215: page 7]
Robot YuMi; Cơ cấu truyền thiếc; tự động; Quá trình hàn mạch

Khối phần mềm

Khối chấp hành

Khối tạo đầu vào

Người điều khiển

Khối tạo dữ liệu gốc

Khối điều khiển
trung tâm

Khối tạo quỹ đạo

Khối tạo chương trình
điều khiển

Hình 2. Sơ đồ khối hệ thống tổng quan.

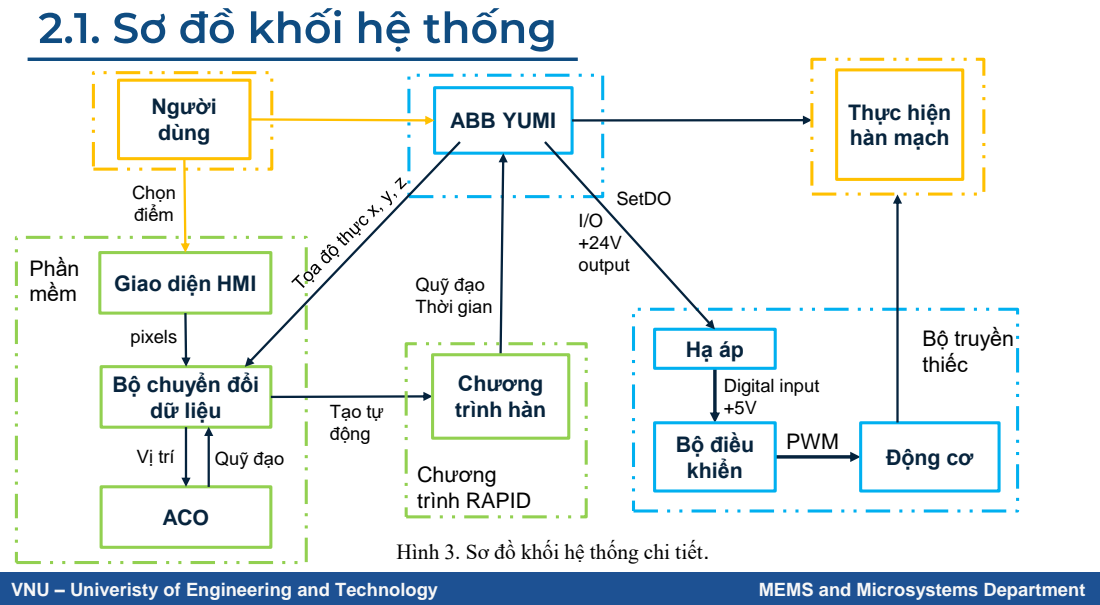
[picture p216: page 8]
ABB YUMI; Tạo tự động; Vị trí; Quỹ đạo; PWM; ACO; Bộ điều; khiển; Động cơ; Bộ truyền; thiếc; Phần mềm; Người dùng; Chọn điểm; pixels; Chương trình hàn; Chương trình RAPID; Quỹ đạo Thời gian; SetDO; I/O +24V output; Digital input +5V; Thực hiện hàn mạch

Giao diện HMI

Bộ chuyển đổi
dữ liệu

Hình 3. Sơ đồ khối hệ thống chi tiết.

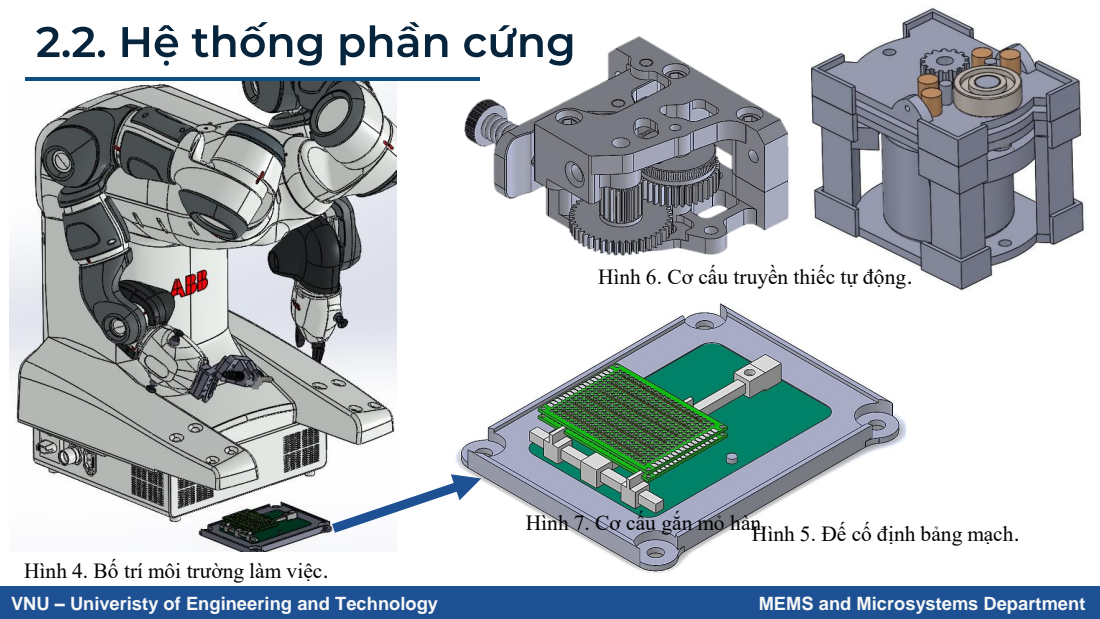
[picture p217: page 9]

Hình 6. Cơ cấu truyền thiếc tự động.

Hình 7. Cơ cấu gắn mỏ hàn.

Hình 5. Đế cố định bảng mạch.

Hình 4. Bố trí môi trường làm việc.

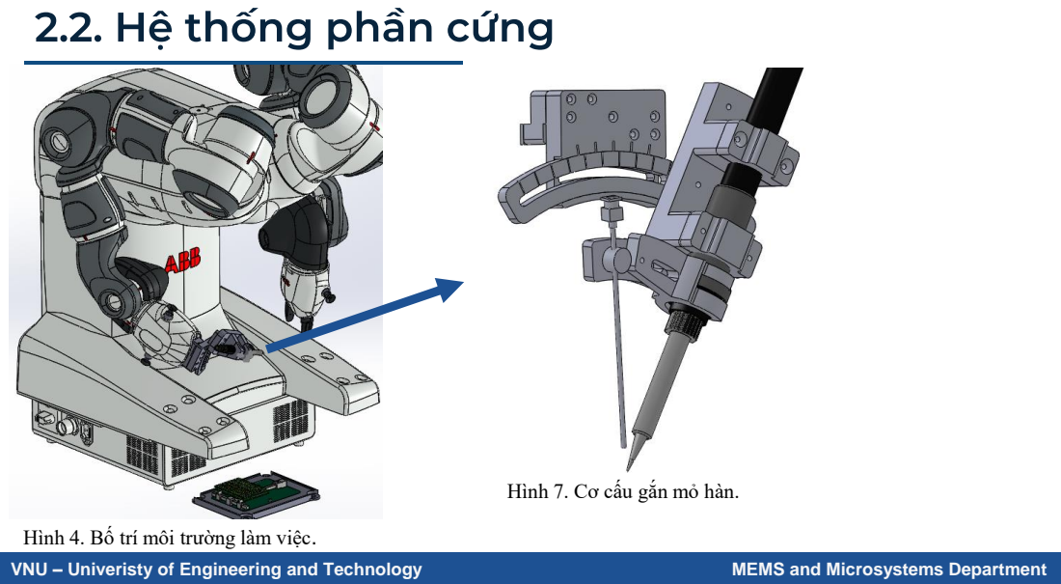
[picture p218: page 10]

Hình 7. Cơ cấu gắn mỏ hàn.

Hình 4. Bố trí môi trường làm việc.

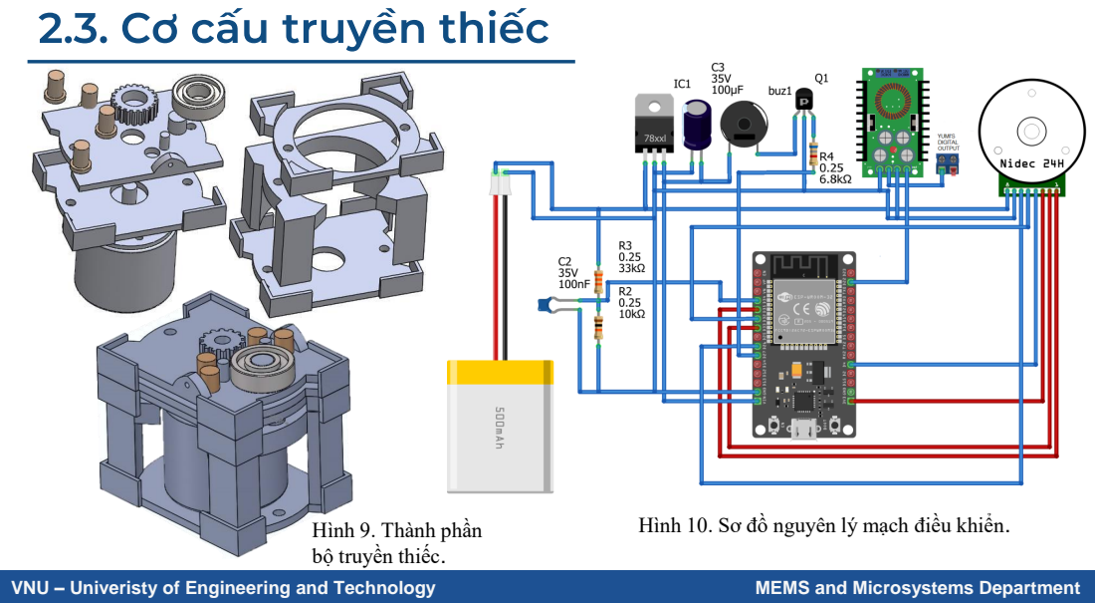
[picture p219: page 11]

Hình 10. Sơ đồ nguyên lý mạch điều khiển.

Hình 9. Thành phần
bộ truyền thiếc.

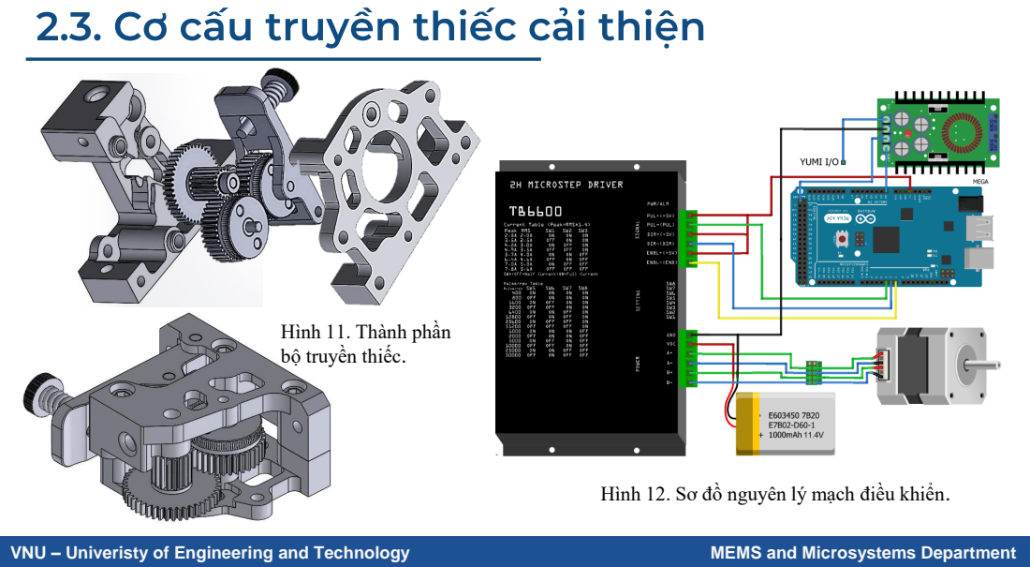
[picture p220: page 12]

Hình 11. Thành phần
bộ truyền thiếc.

Hình 12. Sơ đồ nguyên lý mạch điều khiển.

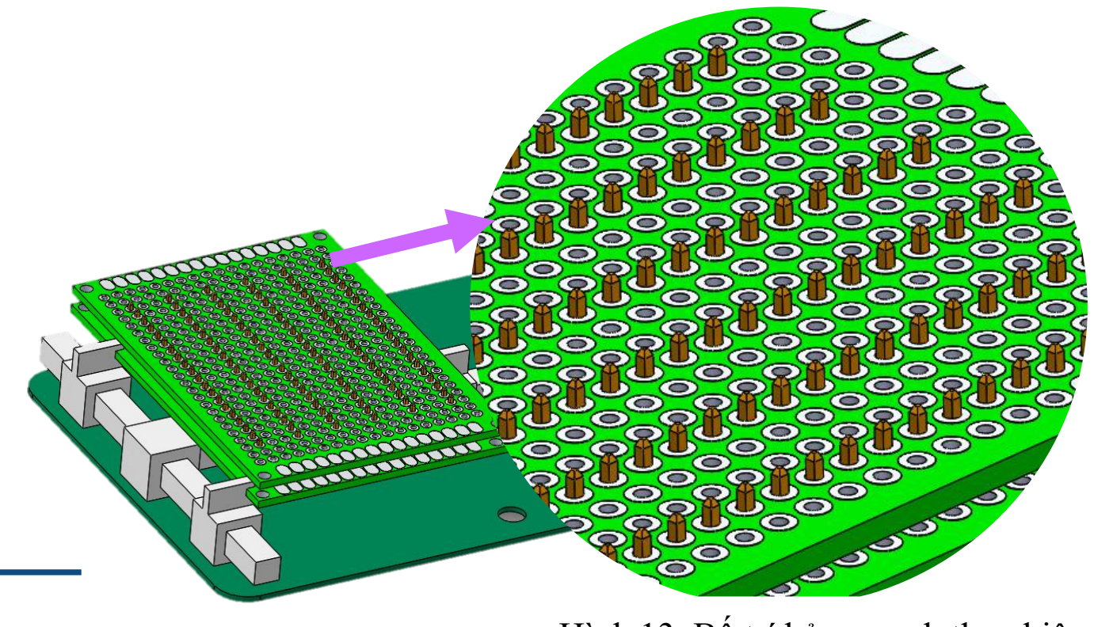
[picture p221: figure]

Xây dựng hệ thống phần mềm.

#03

# THUẬT TOÁN

Hình 13. Bố trí bảng mạch thực hiện.

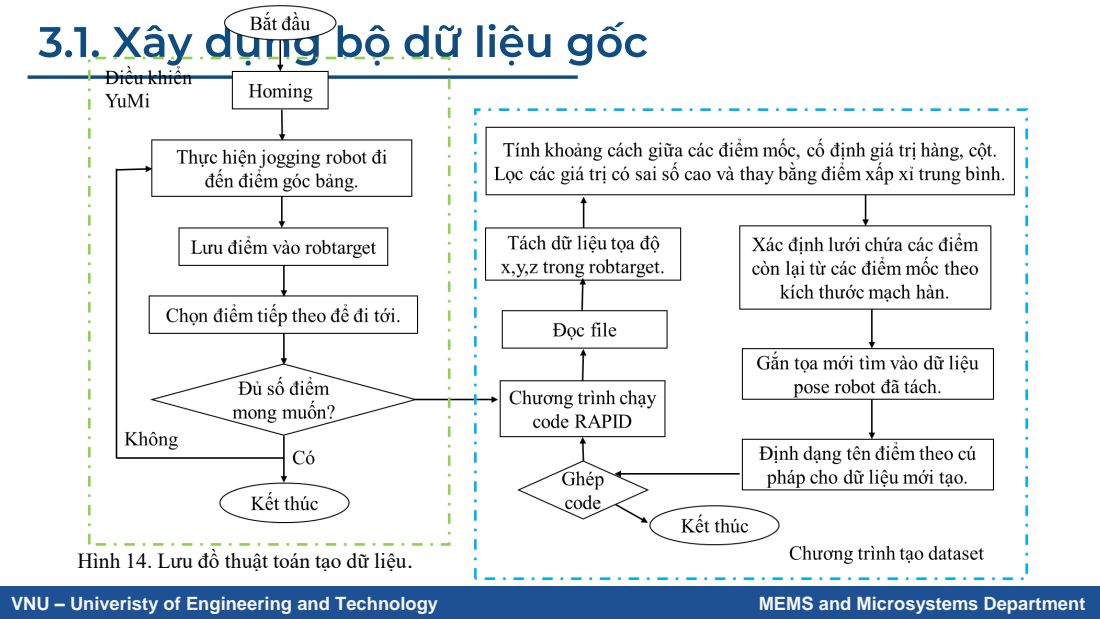
[picture p222: page 14]

Hình 14. Lưu đồ thuật toán tạo dữ liệu.

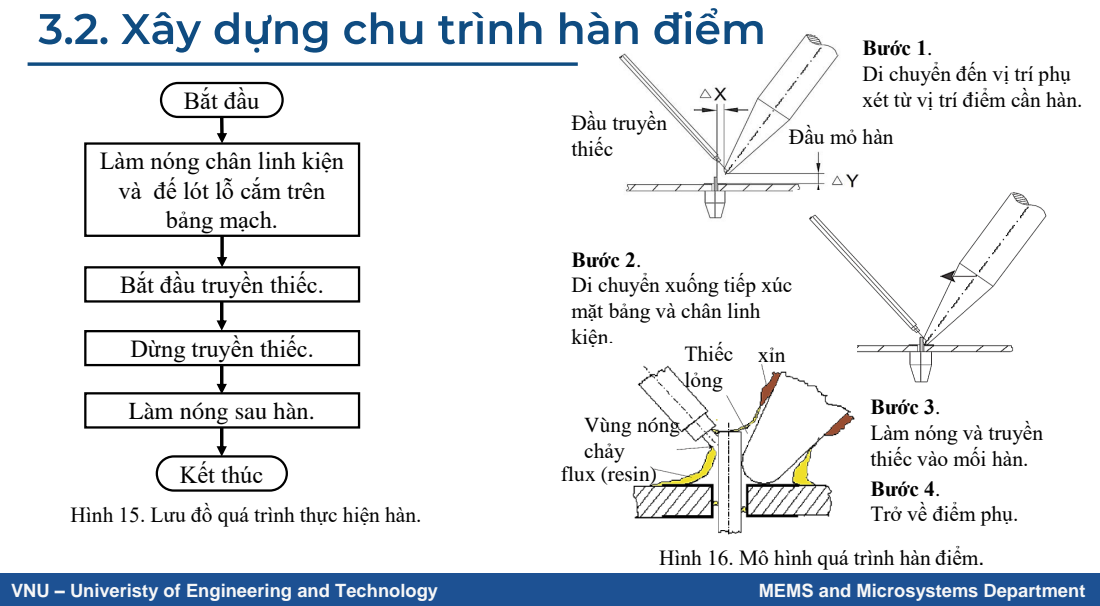
[picture p223: page 15]
flux (resin); Vùng nóng chảy; Thiếc; lỏng; xỉn; Bắt đầu; Kết thúc

Bước 1.
Di chuyển đến vị trí phụ
xét từ vị trí điểm cần hàn.

Đầu mỏ hàn Đầu truyền
thiếc

Làm nóng chân linh kiện
và đế lót lỗ cắm trên
bảng mạch.

Bước 2.
Di chuyển xuống tiếp xúc
mặt bảng và chân linh
kiện.

Bắt đầu truyền thiếc.

Dừng truyền thiếc.

Làm nóng sau hàn.

Bước 3.
Làm nóng và truyền
thiếc vào mối hàn.
Bước 4.
Trở về điểm phụ.

Hình 15. Lưu đồ quá trình thực hiện hàn.

Hình 16. Mô hình quá trình hàn điểm.

1.8s | 2.2s | 3.0s | 3.2s
0 | 0.1s | 0.4s | 0.6s

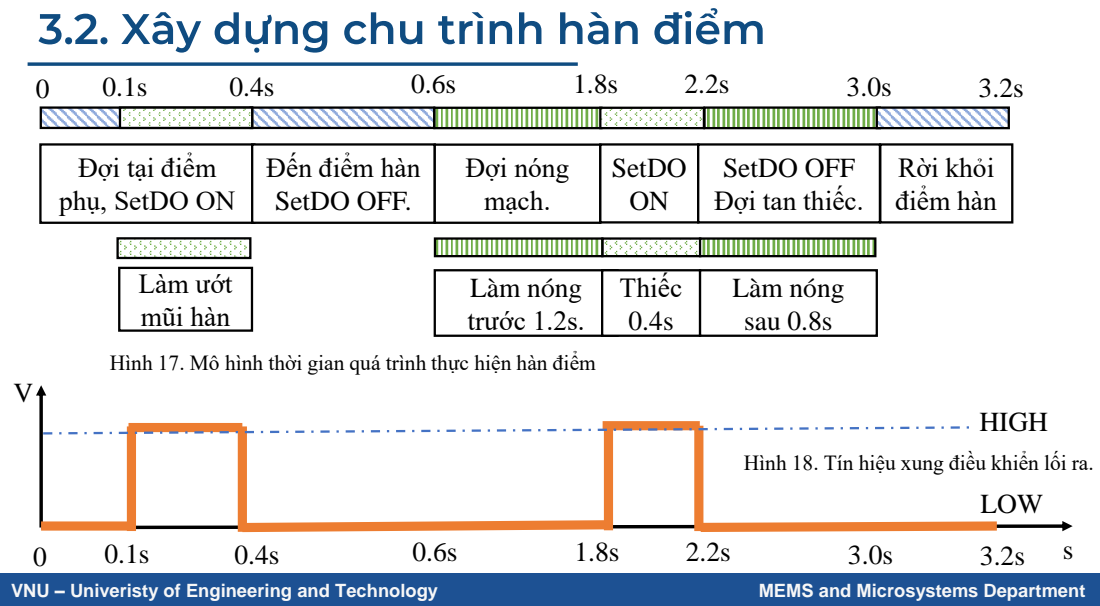
[picture p224: page 16]
Làm nóng trước 1.2s.; Thiếc; Làm nóng sau 0.8s; Rời khỏi điểm hàn; Làm ướt mũi hàn; Đợi nóng mạch.; SetDO ON; HIGH; LOW

Đợi tại điểm
phụ, SetDO ON

Đến điểm hàn
SetDO OFF.

SetDO OFF
Đợi tan thiếc.

Hình 17. Mô hình thời gian quá trình thực hiện hàn điểm

Hình 18. Tín hiệu xung điều khiển lối ra.

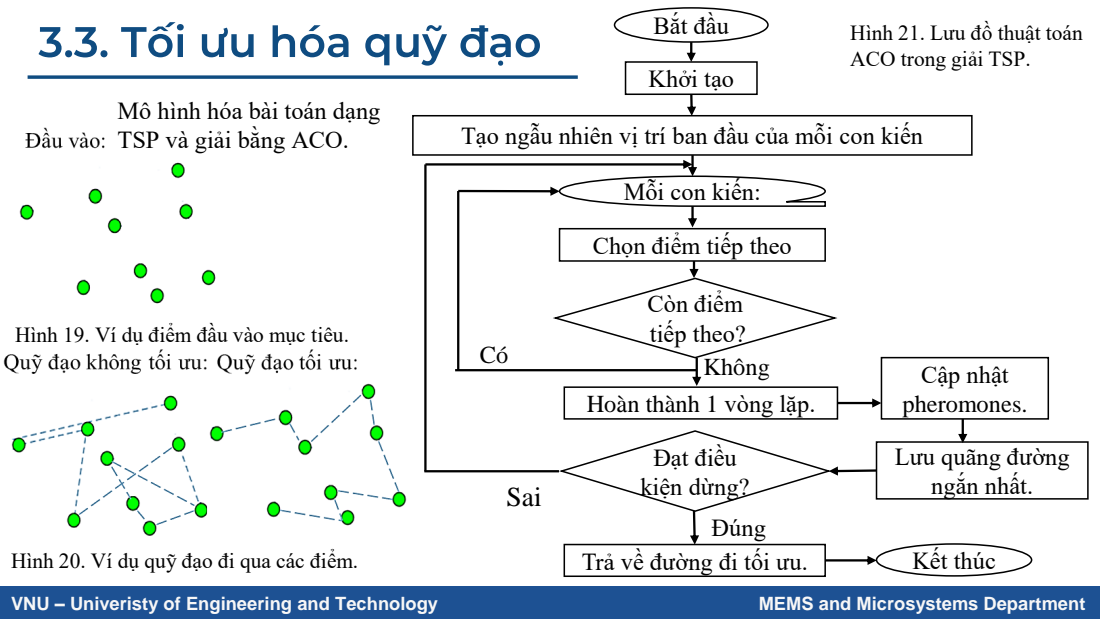
[picture p225: page 17]
Còn điểm tiếp theo?; Bắt đầu; Khởi tạo; Không; Cập nhật; Hoàn thành 1 vòng lặp.; pheromones.; Đạt điều; kiện dừng?; Đúng; Sai; Kết thúc

Hình 21. Lưu đồ thuật toán
ACO trong giải TSP.

Mô hình hóa bài toán dạng
TSP và giải bằng ACO.

Tạo ngẫu nhiên vị trí ban đầu của mỗi con kiến

Mỗi con kiến:

Chọn điểm tiếp theo

Hình 19. Ví dụ điểm đầu vào mục tiêu.

Lưu quãng đường
ngắn nhất.

Hình 20. Ví dụ quỹ đạo đi qua các điểm.

Trả về đường đi tối ưu.

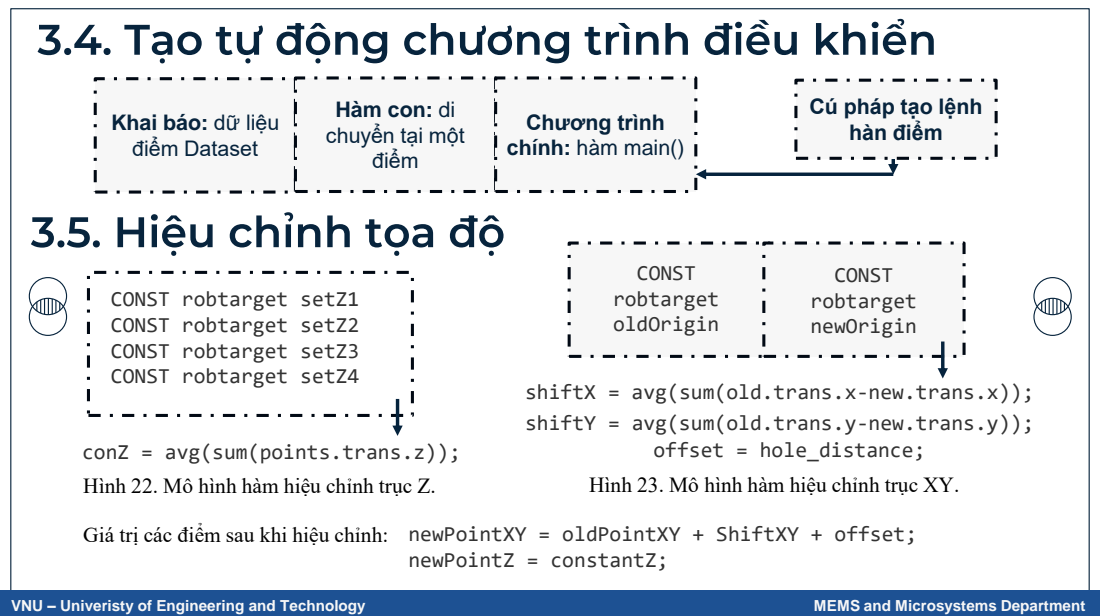
[picture p226: page 18]
CONST robtarget setZ1 CONST robtarget setZ2 CONST robtarget setZ3 CONST robtarget setZ4; CONST robtarget oldOrigin; CONST robtarget newOrigin; offset = hole_distance;; Hình 22. Mô hình hàm hiệu chỉnh trục Z.; Hình 23. Mô hình hàm hiệu chỉnh trục XY.

Hàm con: di
chuyển tại một
điểm

Cú pháp tạo lệnh
hàn điểm

Khai báo: dữ liệu
điểm Dataset

Chương trình
chính: hàm main()

shiftX = avg(sum(old.trans.x-new.trans.x));
shiftY = avg(sum(old.trans.y-new.trans.y));

conZ = avg(sum(points.trans.z));

Giá trị các điểm sau khi hiệu chỉnh:

newPointXY = oldPointXY + ShiftXY + offset;
newPointZ = constantZ;

#04

# THỰC NGHIỆM VÀ KẾT QUẢ

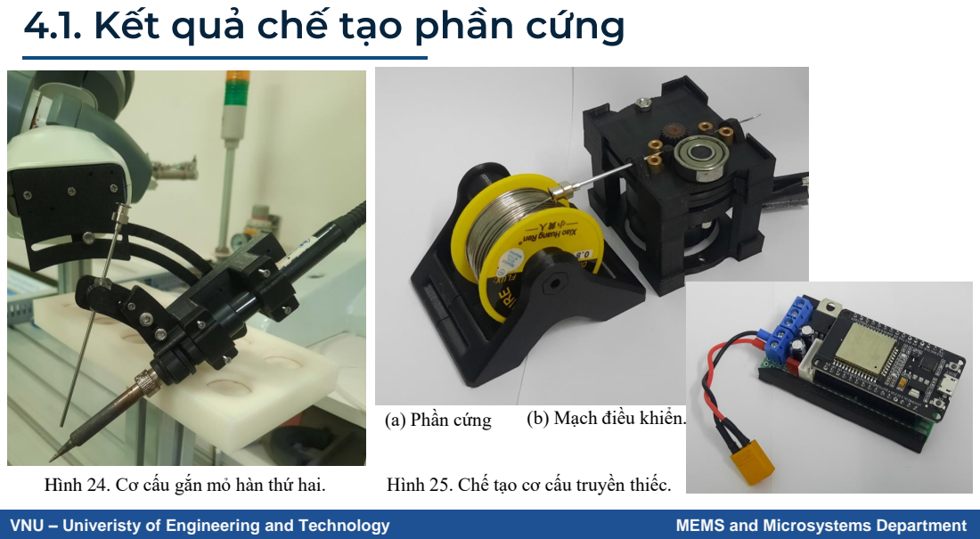
[picture p227: page 20]
(a) Phần cứng; Hình 24. Cơ cấu gắn mỏ hàn thứ hai.; Hình 25. Chế tạo cơ cấu truyền thiếc.

(b) Mạch điều khiển.

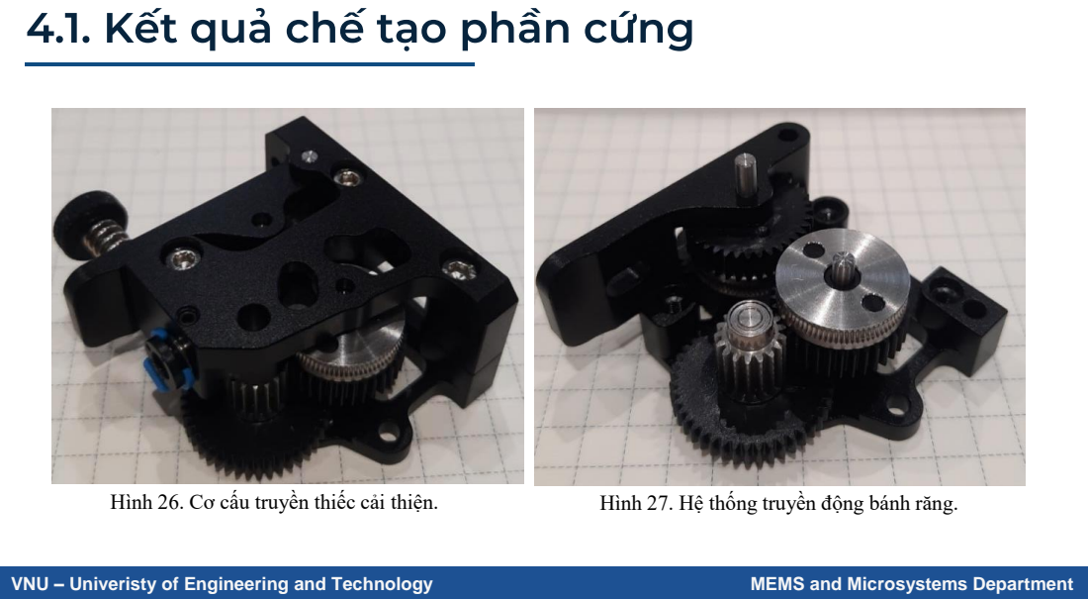
[picture p228: page 21]
Hình 26. Cơ cấu truyền thiếc cải thiện.; Hình 27. Hệ thống truyền động bánh răng.

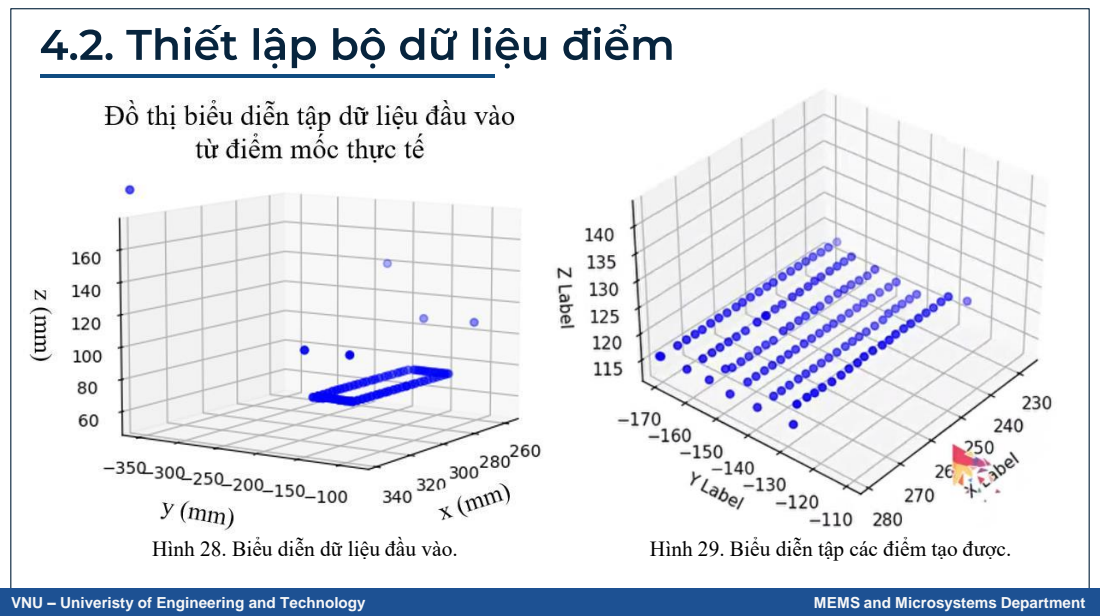
[picture p229: page 22]
Hình 28. Biểu diễn dữ liệu đầu vào.; Hình 29. Biểu diễn tập các điểm tạo được.

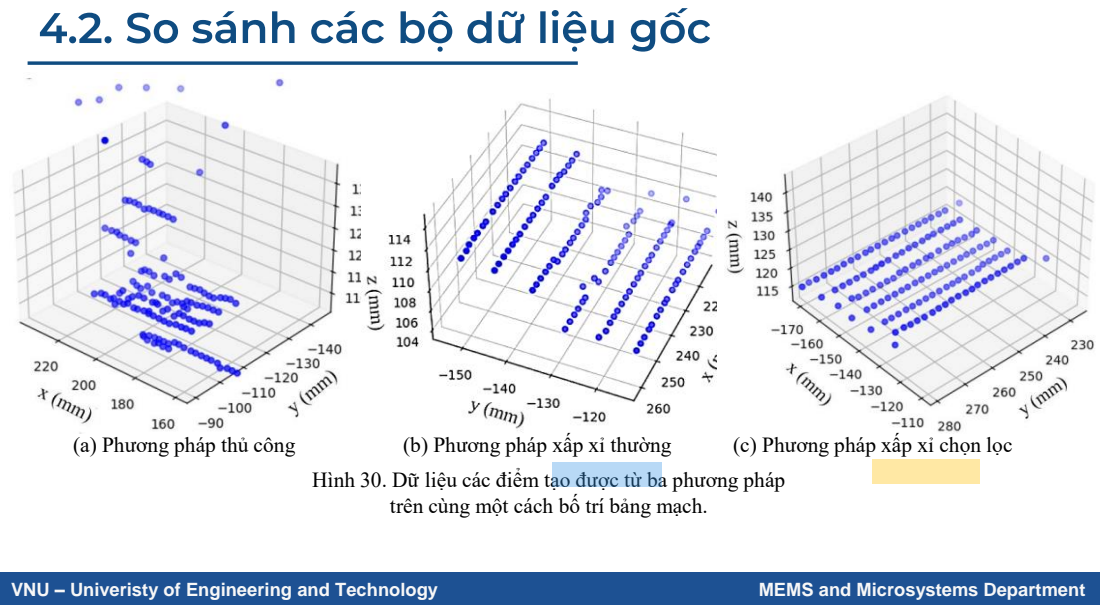
[picture p230: page 23]
(a) Phương pháp thủ công; (b) Phương pháp xấp xỉ thường; (c) Phương pháp xấp xỉ chọn lọc

Hình 30. Dữ liệu các điểm tạo được từ ba phương pháp

trên cùng một cách bố trí bảng mạch.

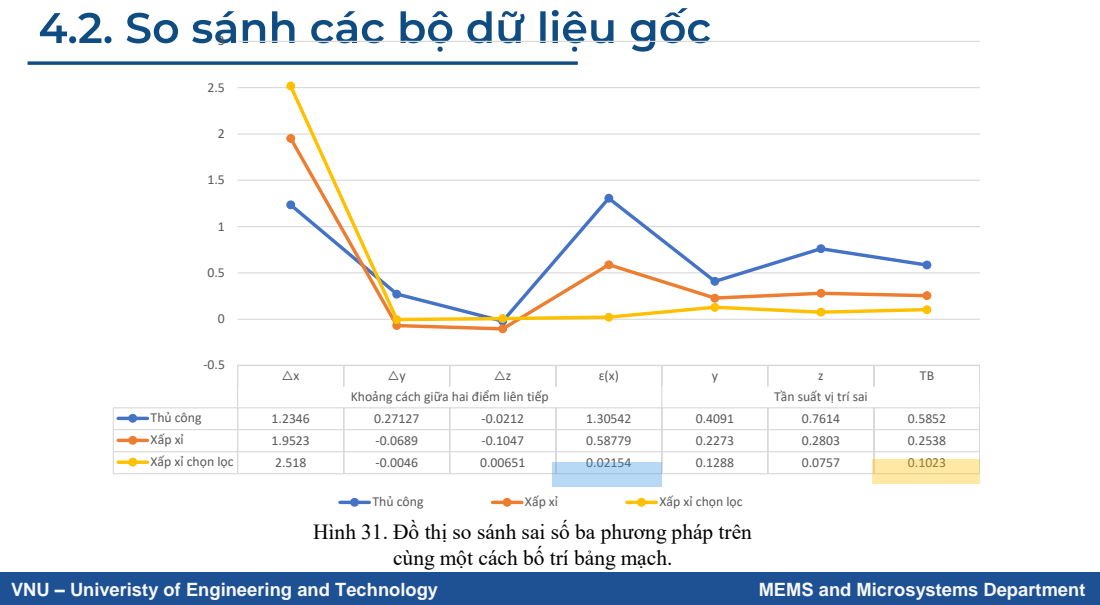
[picture p231: page 24]
Thủ công; Xấp xỉ; Xấp xỉ chọn lọc

Khoảng cách giữa hai điểm liên tiếp | | | | Tần suất vị trí sai

Thủ công | 1.2346 | 0.27127 | -0.0212 | 1.30542 | 0.4091 | 0.7614 | 0.5852
Xấp xỉ | 1.9523 | -0.0689 | -0.1047 | 0.58779 | 0.2273 | 0.2803 | 0.2538
Xấp xỉ chọn lọc | 2.518 | -0.0046 | 0.00651 | 0.02154 | 0.1288 | 0.0757 | 0.1023

Hình 31. Đồ thị so sánh sai số ba phương pháp trên

cùng một cách bố trí bảng mạch.

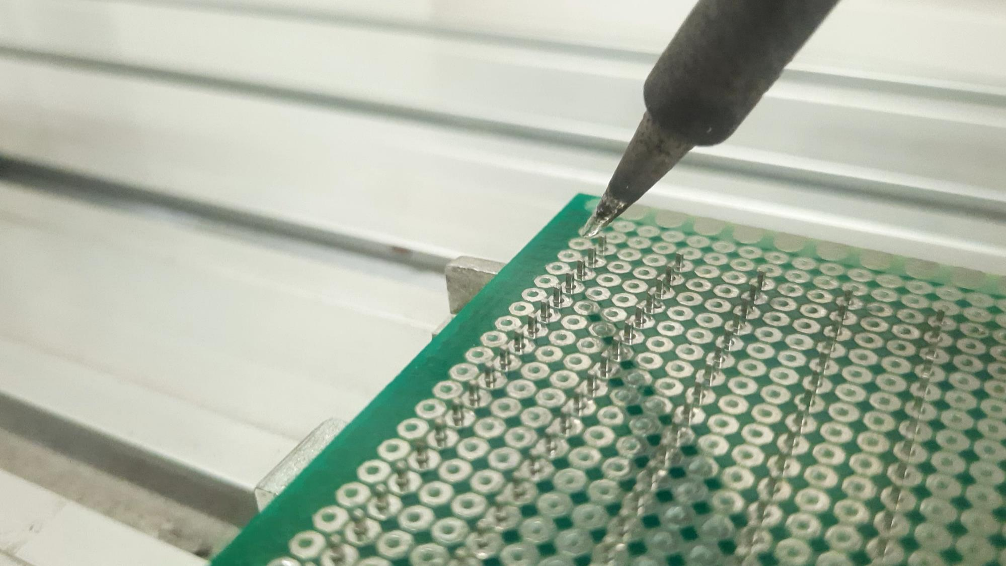
[picture p232: page 25]

# 4.3. Tạo dữ liệu đầu vào

# Chọn vị trí điểm cần hàn. <link>

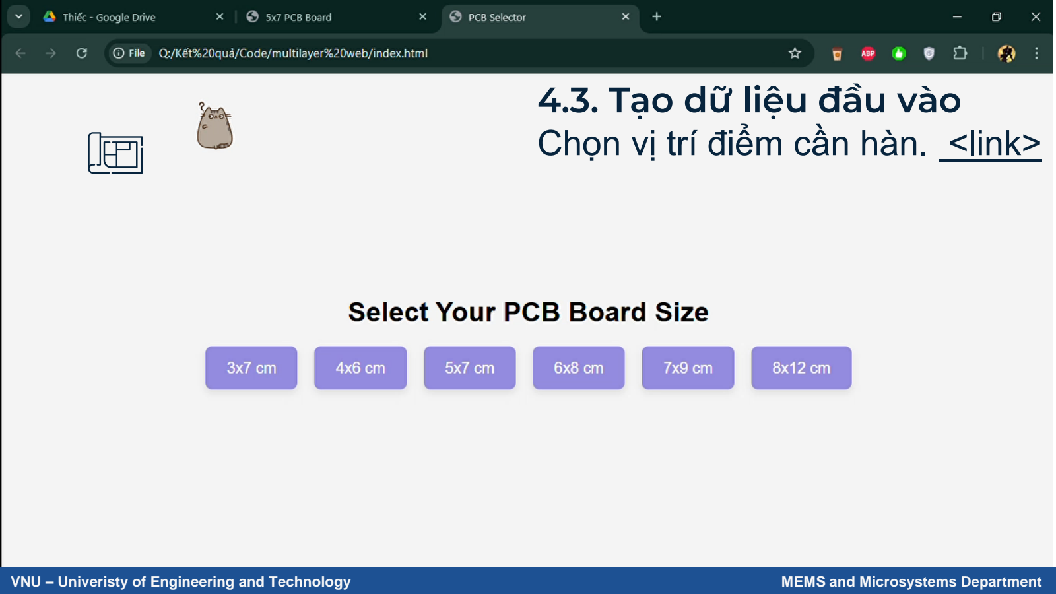
[picture p233: page 26]
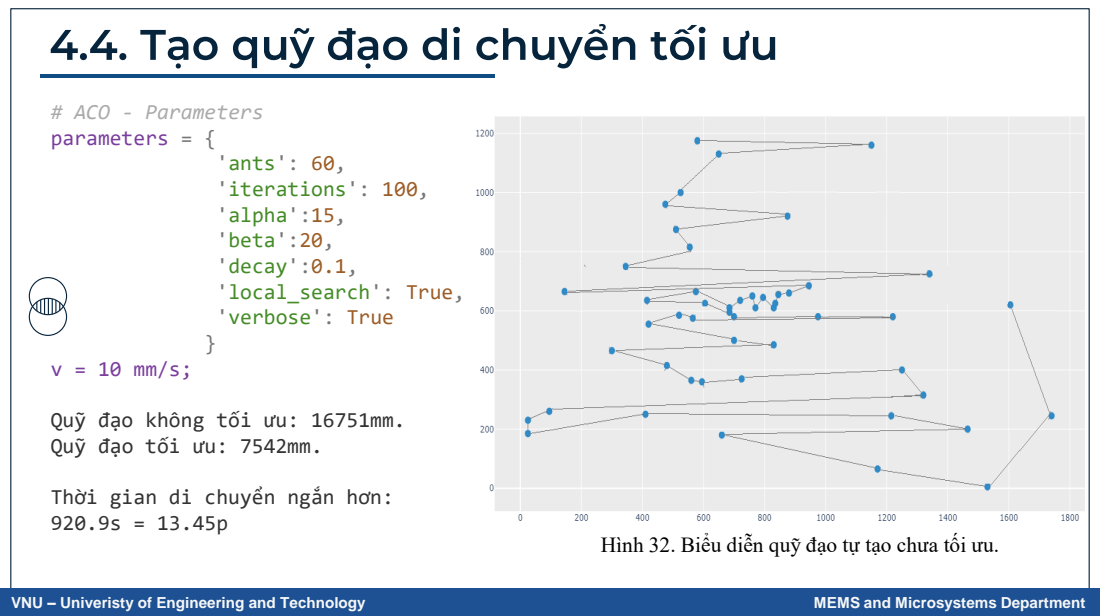
[picture p234: page 27]
# ACO - Parameters parameters = {; 'ants': 60, 'iterations': 100, 'alpha':15, 'beta':20, 'decay':0.1, 'local_search': True, 'verbose': True

Quỹ đạo không tối ưu: 16751mm.
Quỹ đạo tối ưu: 7542mm.

Thời gian di chuyển ngắn hơn:

Hình 32. Biểu diễn quỹ đạo tự tạo chưa tối ưu.

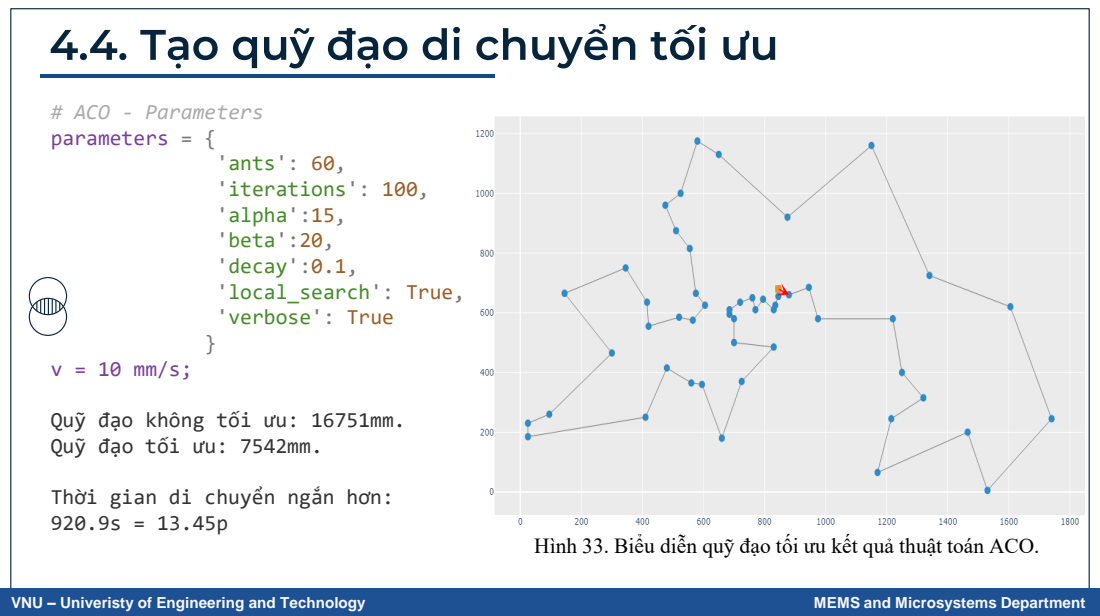
[picture p235: page 28]
# ACO - Parameters parameters = {; 'ants': 60, 'iterations': 100, 'alpha':15, 'beta':20, 'decay':0.1, 'local_search': True, 'verbose': True

Quỹ đạo không tối ưu: 16751mm.
Quỹ đạo tối ưu: 7542mm.

Thời gian di chuyển ngắn hơn:

Hình 33. Biểu diễn quỹ đạo tối ưu kết quả thuật toán ACO.

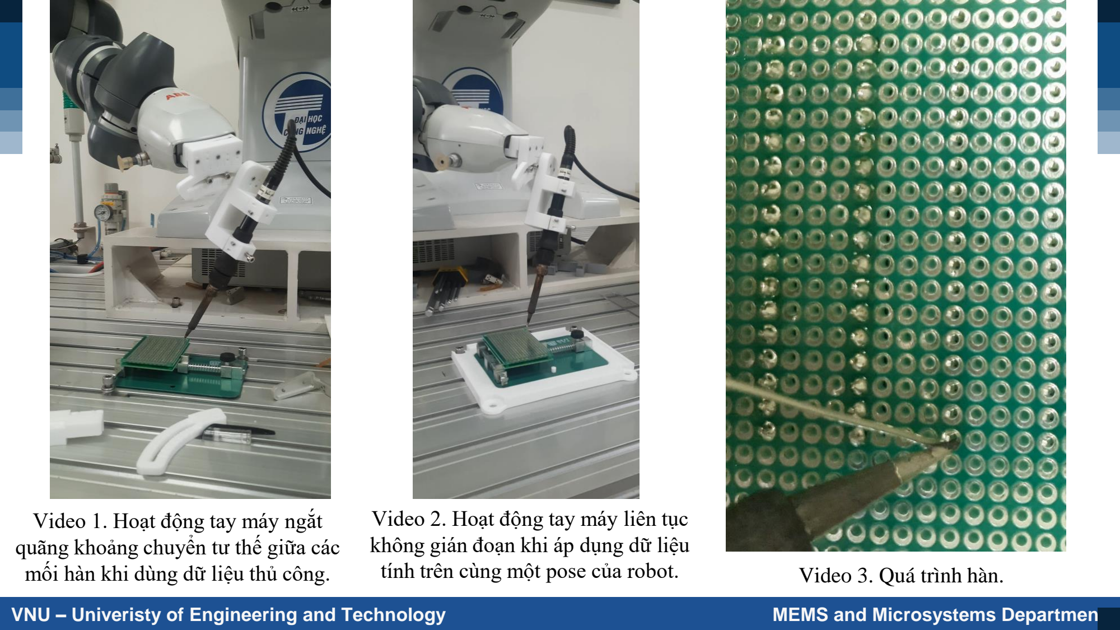
[picture p236: page 29]

Video 1. Hoạt động tay máy ngắt quãng khoảng chuyển tư thế giữa các mối hàn khi dùng dữ liệu thủ công.

Video 2. Hoạt động tay máy liên tục
không gián đoạn khi áp dụng dữ liệu
tính trên cùng một pose của robot. | Video 3. Quá trình hàn.

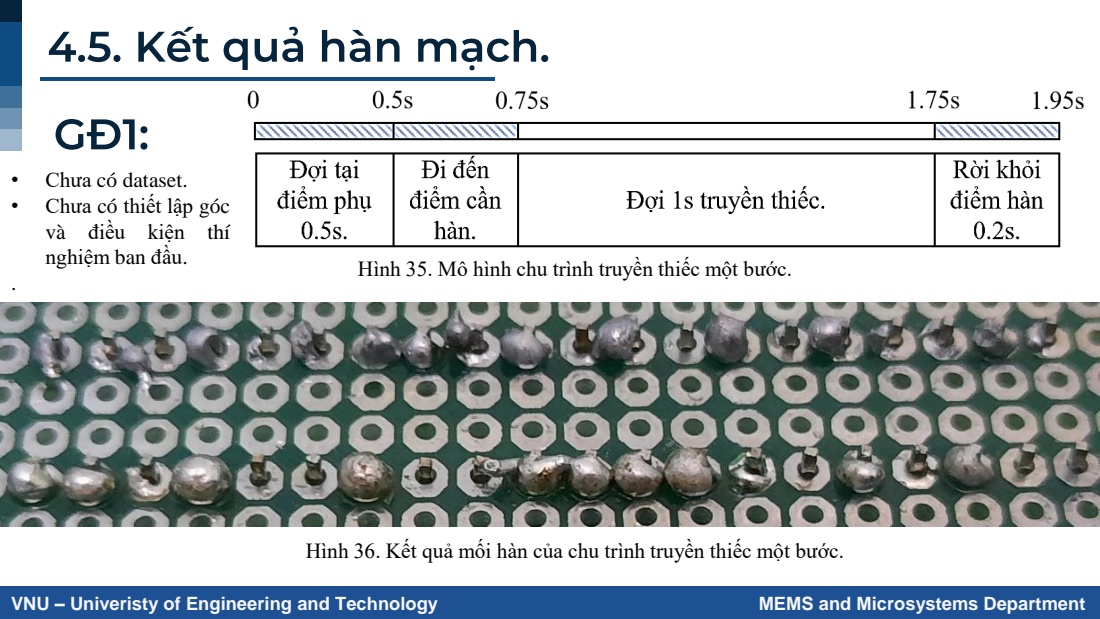
[picture p237: page 30]

• Chưa có dataset.
• Chưa có thiết lập góc
và điều kiện thí
nghiệm ban đầu.

Hình 35. Mô hình chu trình truyền thiếc một bước.

Hình 36. Kết quả mối hàn của chu trình truyền thiếc một bước.

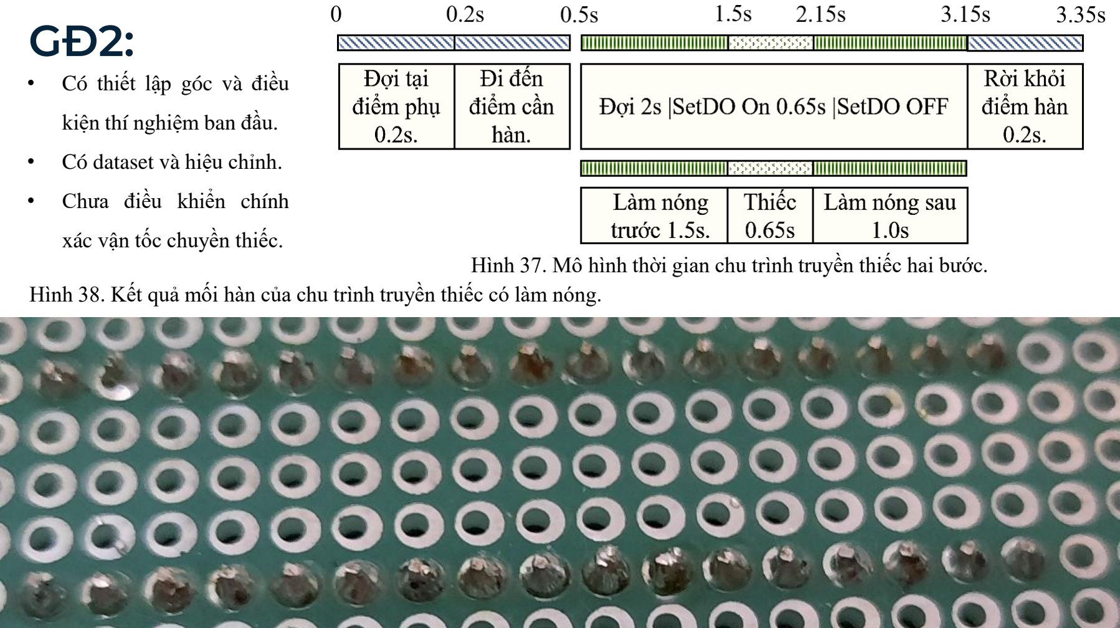
[picture p238: page 31]

Hình 38. Kết quả mối hàn của chu trình truyền thiếc có làm nóng.

Hình 37. Mô hình thời gian chu trình truyền thiếc hai bước.

- Có thiết lập góc và điều

kiện thí nghiệm ban đầu.

- Có dataset và hiệu chỉnh.
- Chưa điều khiển chính

xác vận tốc chuyền thiếc.

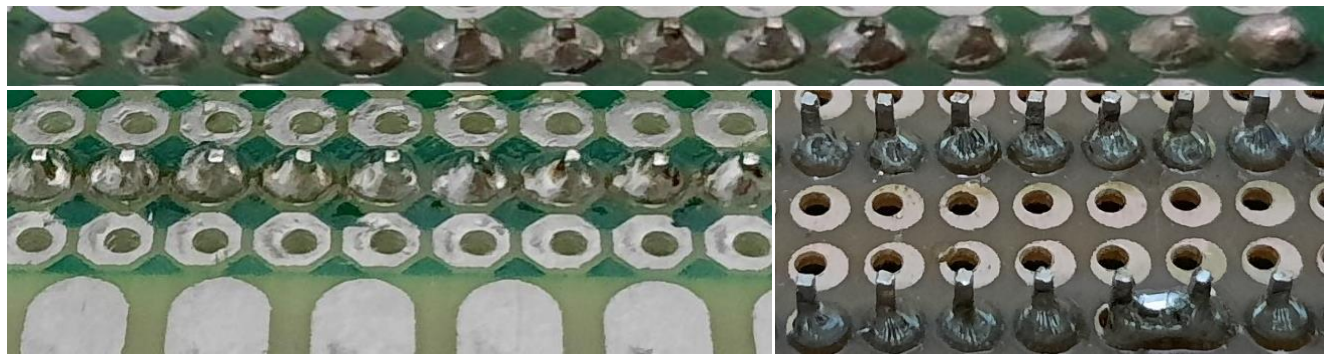
[picture p239: figure]

Hình 39. Kết quả mối hàn truyền thiếc ba bước điều khiển vận tốc truyền..

Làm nóng
trước 1.2s.

Thiếc
0.4s

Làm nóng
sau 0.8s

Đợi tại điểm
phụ, SetDO ON

Đến điểm hàn
SetDO OFF.

Rời khỏi
điểm hàn
1.8s | 2.2s | 3.0s | 3.2s

Làm ướt
mũi hàn

Đợi nóng
mạch.

SetDO
ON

SetDO OFF
Đợi tan thiếc.
0 | 0.1s | 0.4s | 0.6s

Hình 38. Mô hình truyền thiếc ba bước có điều khiển vận tốc truyền.

- Có điều kiện thiết lập.
- Điều khiển chính xác

vận tốc truyền thiếc.

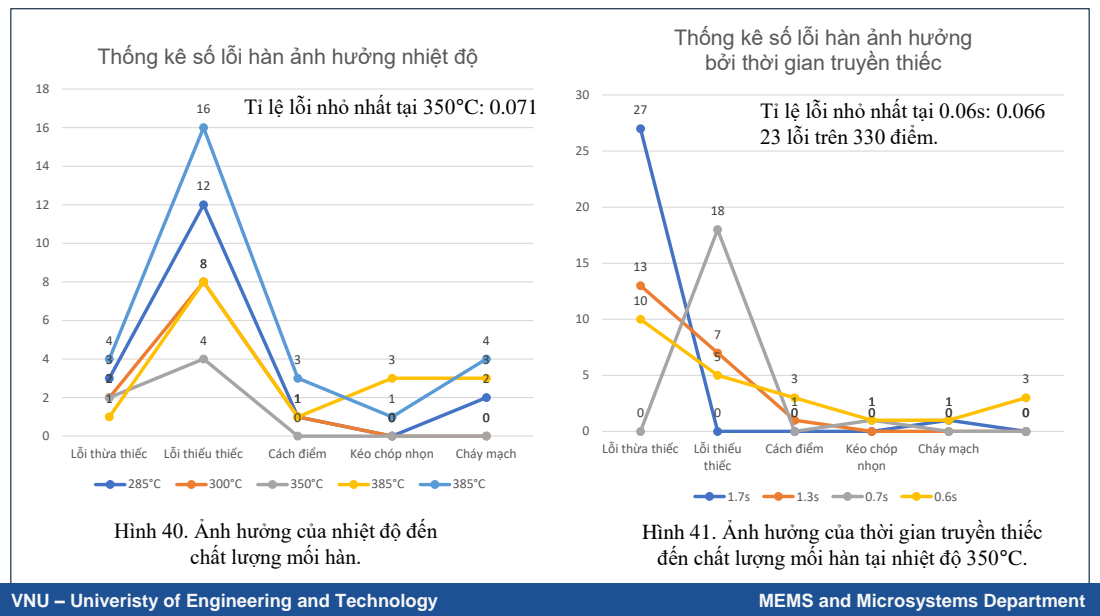
[picture p240: page 33]
Lỗi thừa thiếc Lỗi thiếu thiếc; Cách điểm; Kéo chóp nhọn; Cháy mạch; thiếc; Kéo chóp; nhọn; Tỉ lệ lỗi nhỏ nhất tại 350°C: 0.071; Tỉ lệ lỗi nhỏ nhất tại 0.06s: 0.066

Thống kê số lỗi hàn ảnh hưởng
bởi thời gian truyền thiếc

Thống kê số lỗi hàn ảnh hưởng nhiệt độ

23 lỗi trên 330 điểm.

Lỗi thừa thiếc Lỗi thiếu

Hình 40. Ảnh hưởng của nhiệt độ đến

Hình 41. Ảnh hưởng của thời gian truyền thiếc
đến chất lượng mối hàn tại nhiệt độ 350°C.

chất lượng mối hàn.

#05

# KẾT LUẬN VÀ HƯỚNG PHÁT TRIỂN

# 5.1. Kết luận

+ | Đáp ứng với các yêu cầu cơ bản của đề tài.
+ | Đạt chất lượng mong đợi, ổn định, duy trì được sự cải thiện liên tục.
+ | Xác định được chính xác tọa độ điểm trong không gian thực, xây dựng được bộ dữ liệu cho các lần thực hiện sau.
+ | Xây dựng được chương trình tạo lệnh tự động, giảm thiểu thao tác nhập liệu thủ công
Đạt được | Hạn chế
– | Thang đánh giá chưa hoàn toàn
phản ánh chính xác tiêu chí hàn công nghiệp.

– Hệ thống thiết bị còn hạn chế, chưa có cảm biến xác định nhiệt độ chính xác trong quá trình.

– Chưa đủ thời gian áp dụng với các mạch PCB thiết kế khác.

# 5.2. Hướng phát triển

+ | Xây dựng giao diện dễ sử dụng.
+ | Tạo cơ cấu CNC mới phù hợp với hoạt động nhiệt độ cao.
+ | Xây dựng hệ thống gia nhiệt chủ động, có cảm biến đo chính xác.
+ | Sử dụng camera nhận diện vị trí điểm.
+ | Xử lý ảnh cảnh báo va chạm và lập phương án di chuyển.
+ | Xây dựng model học máy đánh giá chất lượng mối hàn (AOI) thông qua ảnh quang học hoặc ảnh X-quang.

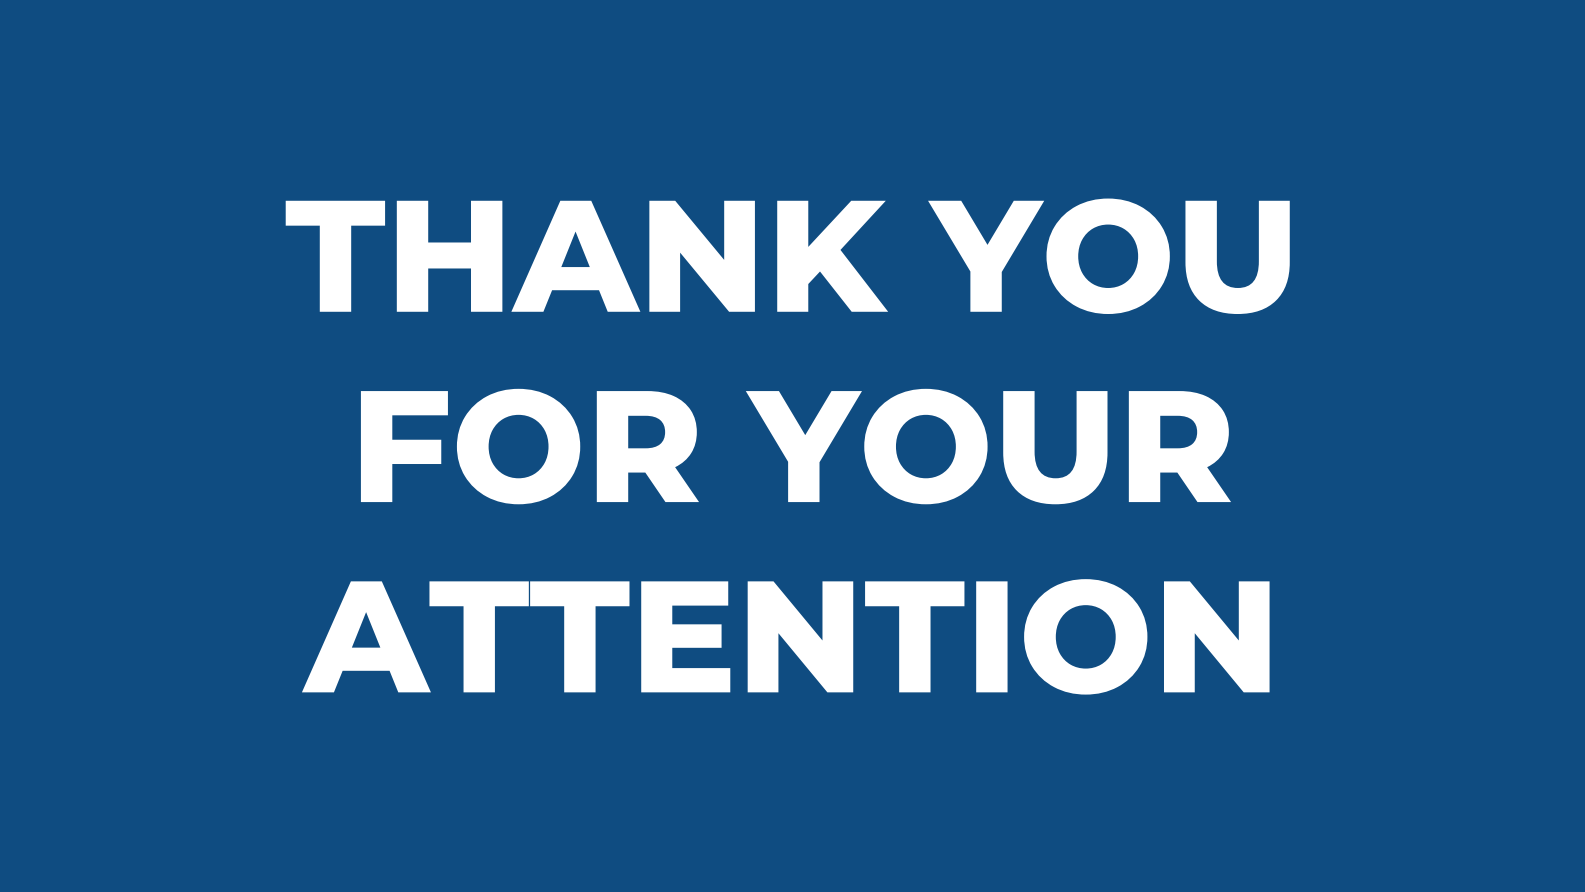
[picture p241: page 37]

ĐẠI HỌC QUỐC GIA HÀ NỘI
TRƯỜNG ĐẠI HỌC CÔNG NGHỆ

# Nghiên cứu phát triển bài toán hàn linh kiện chân cắm trên mạch in cho robot cộng tác YuMi

### Sinh viên thực hiện: Nguyễn Huyền Trang

### Cán bộ hướng dẫn: PGS. TS. Bùi Thanh Tùng ThS. Trần Như Chí

HÀ NỘI - 2024
