nht-cyb/yumi-automatic-soldering-thd/(list of files, drawings)

Other design files:
firmware/feeder_v1_esp32/schematic2/schematic2.fz
firmware/feeder_v2_mega/schematic3/schematic3.fz
