nht-cyb/yumi-automatic-soldering-thd/(commit log)

2026-10-10 Add GIFs of joint selection, robot motion and soldering
2026-10-10 Add web PCB joint selector
2026-10-10 Add data processing scripts, datasets and calibration videos
2026-10-10 Add firmware, schematics and CAD for the feeders, cleaner and mounts
2026-10-10 Add soldering result images and test data
2026-10-10 Fix formatting for soldering procedures link in README
