nht-cyb/yumi-automatic-soldering-thd/results_img/soldering_results/20241119_221709 (1).jpg

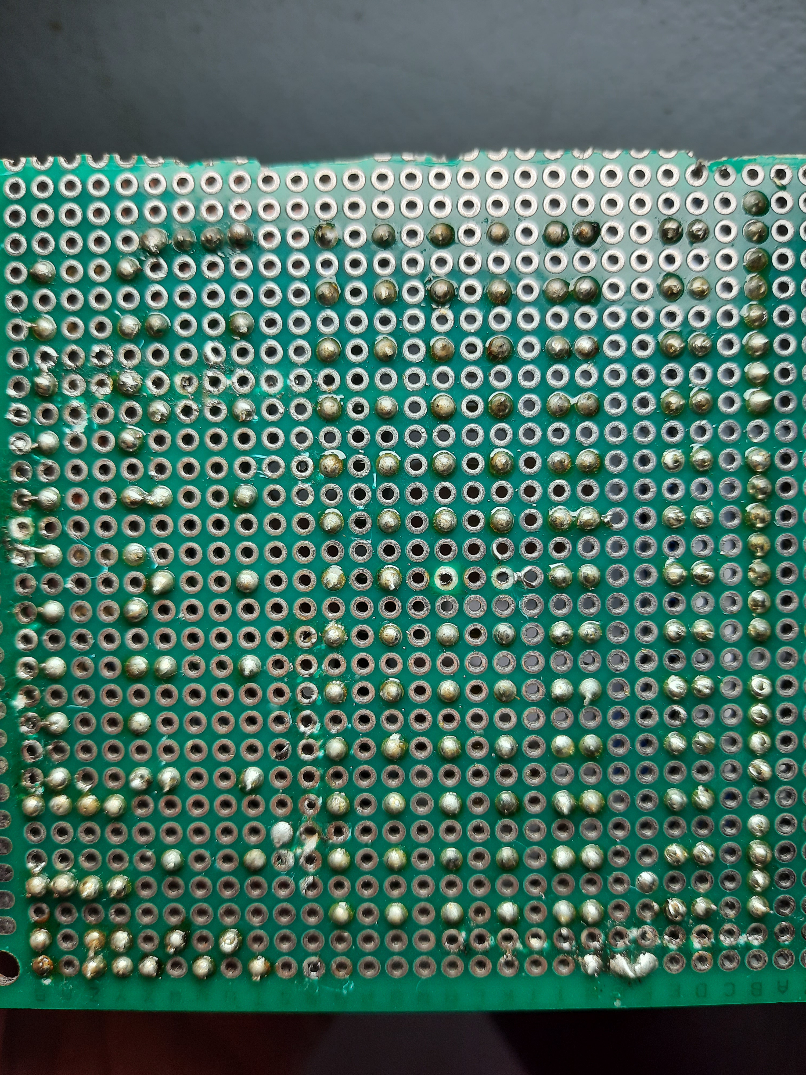
results_img/soldering_results/20241119_221709 (1).jpg
